MathiasKoch/roberto_mechanical/README.md

# Roberto the robot! Mechanical repository containing PCBs and mechanical drawing files.

Please see the roberto_robot repository for the actual robot software, issue tracker and wiki

https://github.com/smilykoch/roberto_robot
