MathiasKoch/roberto_mechanical/Solidworks/Assemblies/pcb_buttons.SLDASM

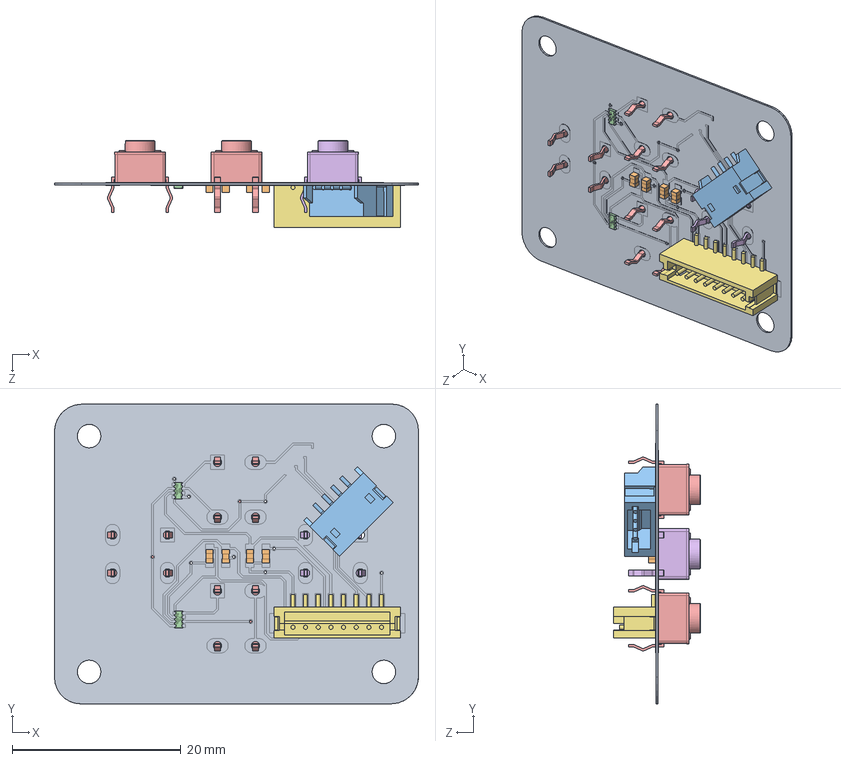
[picture p1: CAD file, 2017-02-08]
Solidworks/Assemblies/pcb_buttons.SLDASM
43.1 x 35.5 x 10.3 mm
Dip_buttons
Capacitor 0603_buttons x 4
S4B-ZR-SM4A-TF_buttons
4xRes_0402_buttons x 2
Tactile switch 6x6x5mm_buttons x 3
Tactile switch 6x6x5mm_buttons_CUT
B8B-PH-SM4_buttons
