MathiasKoch/roberto_mechanical/Solidworks/Assemblies/screen.SLDASM

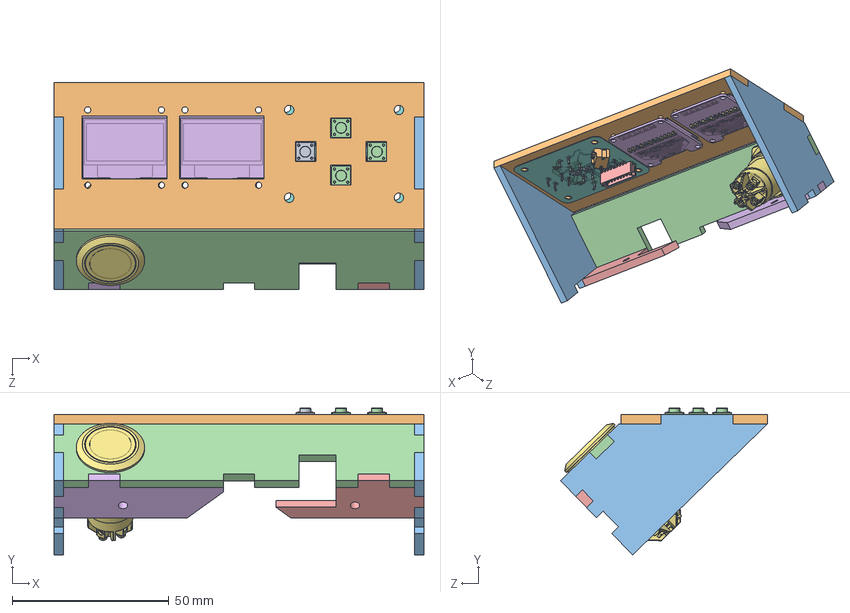
[picture p2: CAD file, 2017-02-08]
Solidworks/Assemblies/screen.SLDASM
118.0 x 46.9 x 66.1 mm
screen_face
screen_side x 2
screen_front
screen_bottom_right
screen_bottom_left
power_switch
Dip_buttons
Capacitor 0603_buttons x 4
S4B-ZR-SM4A-TF_buttons
4xRes_0402_buttons x 2
Tactile switch 6x6x5mm_buttons x 3
Tactile switch 6x6x5mm_buttons_CUT
B8B-PH-SM4_buttons
oled_display x 2
Capacitor 0603_motor x 16
Resistor 0603_motor x 8
