MathiasKoch/roberto_mechanical/Solidworks/Discarded/Electronics/xt60/XT-60_Macho.SLDASM

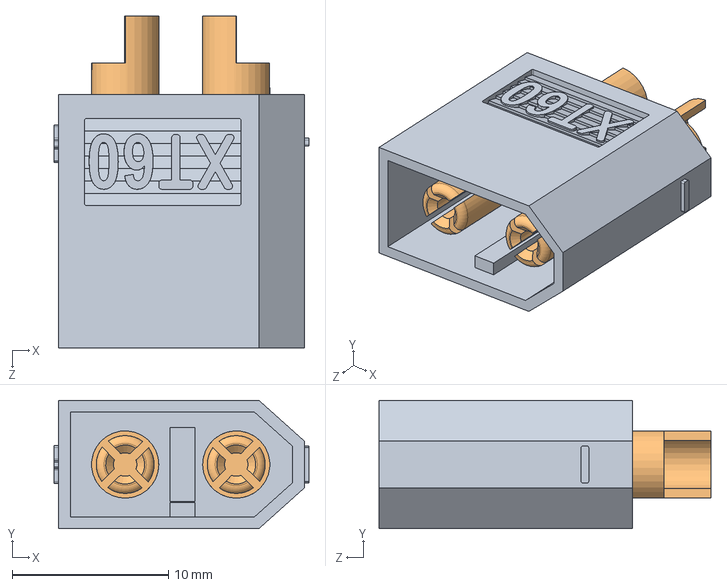
[picture p3: CAD file, 2016-10-30]
Solidworks/Discarded/Electronics/xt60/XT-60_Macho.SLDASM
16.3 x 8.20 x 21.2 mm
XT-60_Macho
PinoXT-60_Macho x 2
