MathiasKoch/roberto_mechanical/Solidworks/Assemblies/display.SLDASM

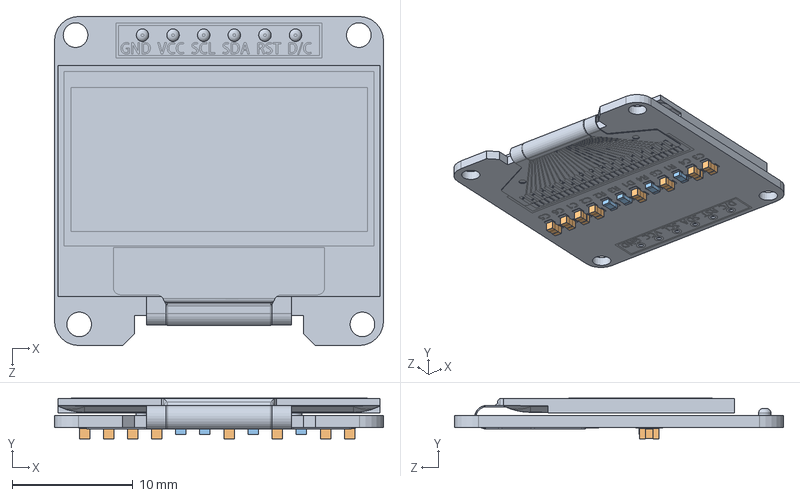
[picture p4: CAD file, 2017-02-08]
Solidworks/Assemblies/display.SLDASM
27.3 x 3.37 x 27.3 mm
oled_display
Capacitor 0603_motor x 8
Resistor 0603_motor x 4
