MathiasKoch/roberto_mechanical/Solidworks/Assemblies/pcb_motor.SLDASM

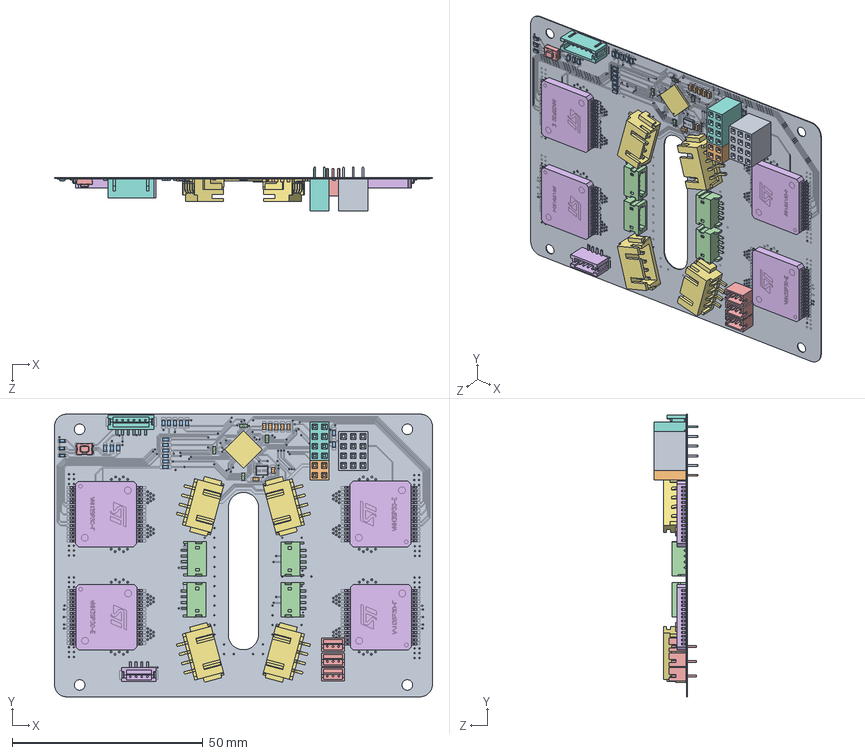
[picture p5: CAD file, 2017-02-08]
Solidworks/Assemblies/pcb_motor.SLDASM
99.1 x 74.1 x 11.7 mm
Dip_motor_motor
Capacitor 0603_motor x 7
led_0603_blue_motor x 3
S4B-ZR-SM4A-TF_motor x 4
B3B-ZR(LF)(SN)_motor x 3
B4B-PH-SM4(LF)(SN)_motor
S4B-XH-SM4-TB_motor x 4
2x4 female header 2_54mm pitch_motor
3x4 female header 2_54mm pitch_motor
2x2 female header 2_54mm pitch_motor
Resistor 0603_motor x 16
4xRes_0402_motor x 4
Switch-CK-KMR2_motor
PowSO30-ST_motor x 4
UFQFPN48_motor
B6B-ZR-SM4-TF_motor
GeyerElectronics_KX7_motor
