MathiasKoch/roberto_mechanical/Solidworks/CircuitWorks/Charger/Dip.SLDASM

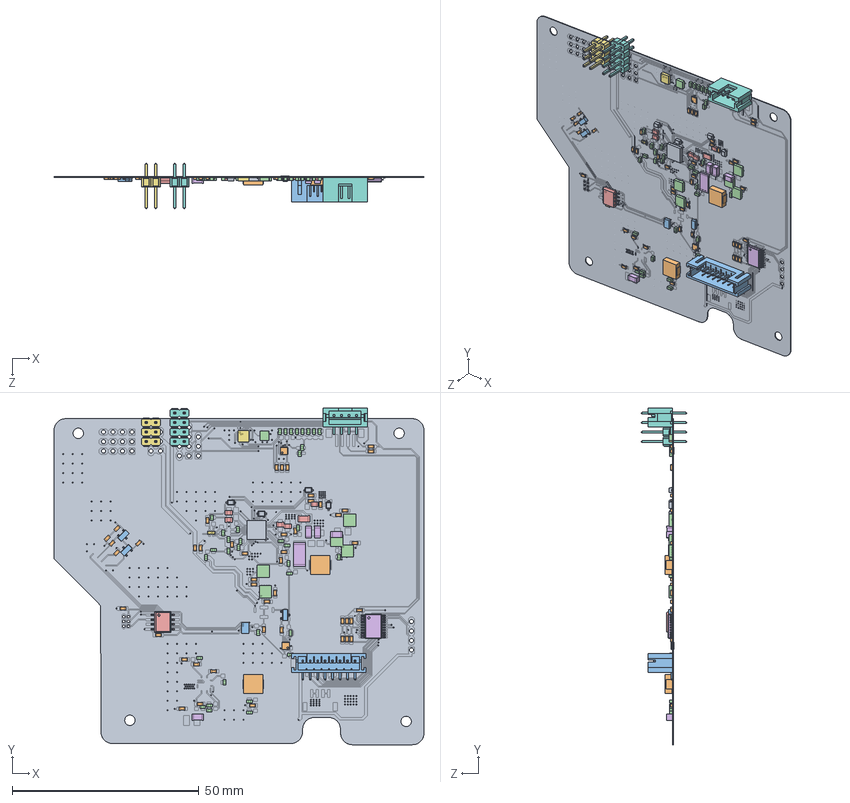
[picture p6: CAD file, 2016-11-09]
Solidworks/CircuitWorks/Charger/Dip.SLDASM
99.1 x 90.1 x 12.2 mm
Dip
Resistor 0603 x 46
B8B-PH-SM4
Capacitor 0603 x 35
Capacitor 0805 x 5
Capacitor 1206 x 4
Header 2_54 Vertical 2x3
Header 2_54 Vertical 2x4
SOD323F-1 x 4
IHLP-2020BZ-01 x 2
SOT 23 x 3
TDFN-8-EP_3x3mm x 5
Resistor 1206
Resistor 2512
4xRes_0402
B4B-PH-SM4(LF)(SN)
VQFN-32
SON8-2x2mm x 2
DFN8_3_0x2_0mm_0_50
HCLGA-10L_LPS25H
SO_IC8
TSSOP-20
QFN24-3x3_MPU9250
