MathiasKoch/roberto_mechanical/Solidworks/Assemblies/pcb_encoder.SLDASM

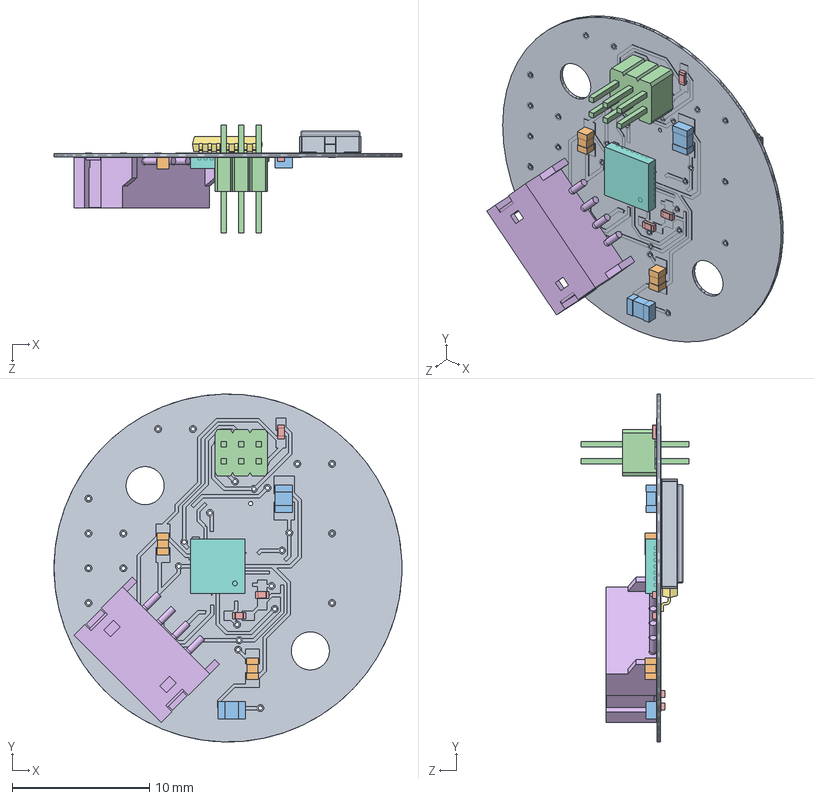
[picture p7: CAD file, 2017-02-08]
Solidworks/Assemblies/pcb_encoder.SLDASM
25.4 x 25.4 x 7.85 mm
Dip_encoder
Capacitor 0603_encoder x 2
Capacitor 0805_encoder x 2
ISP_Header_encoder
res0402-1_encoder x 5
S4B-ZR-SM4A-TF_encoder
tssop14-2_encoder
ATmega 168_encoder
GeyerElectronics_KX14_encoder
