MathiasKoch/roberto_mechanical/Solidworks/Assemblies/camera_mount.SLDASM

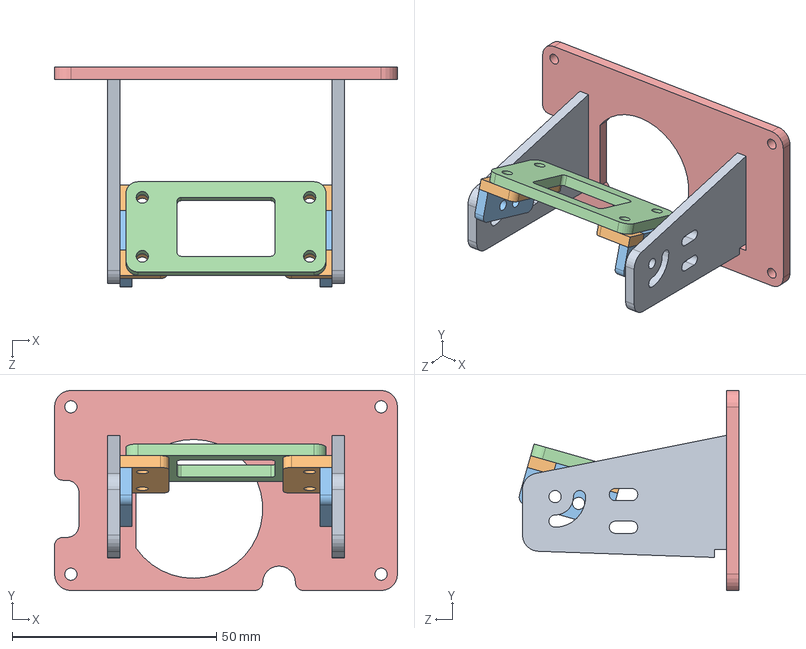
[picture p8: CAD file, 2017-02-08]
Solidworks/Assemblies/camera_mount.SLDASM
84.0 x 49.0 x 53.8 mm
camera_mount_side x 2
camera_vinkel_1 x 2
camera_vinkel_2 x 2
camera_plate
camera_mount_v2
