MathiasKoch/roberto_mechanical/Solidworks/Assemblies/tire.SLDASM

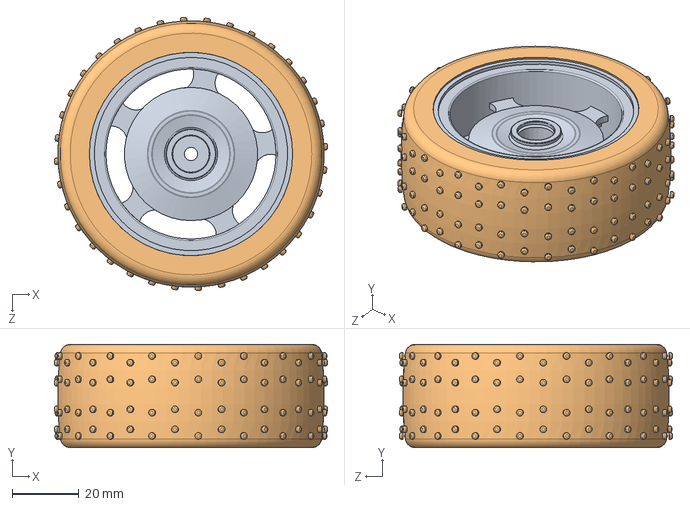
[picture p9: CAD file, 2017-02-08]
Solidworks/Assemblies/tire.SLDASM
81.9 x 31.0 x 81.9 mm
tire_rim
tire_rubber
