MathiasKoch/roberto_mechanical/Solidworks/Assemblies/bearing.SLDASM

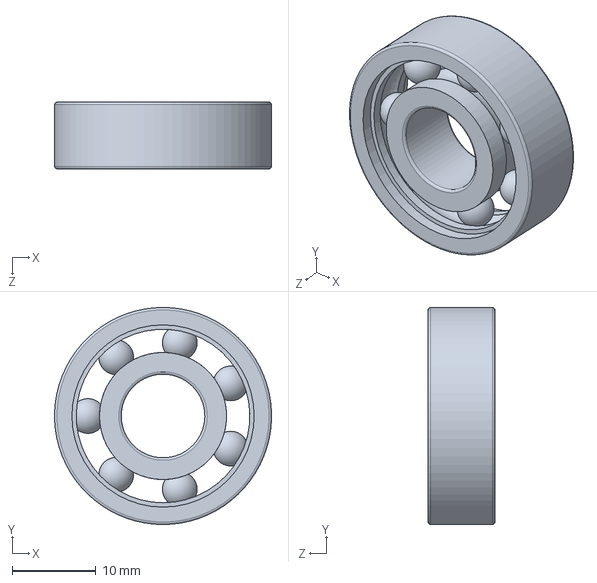
[picture p10: CAD file, 2017-02-08]
Solidworks/Assemblies/bearing.SLDASM
26.0 x 26.0 x 8.00 mm
