MathiasKoch/roberto_mechanical/Solidworks/Assemblies/pcb_distribution.SLDASM

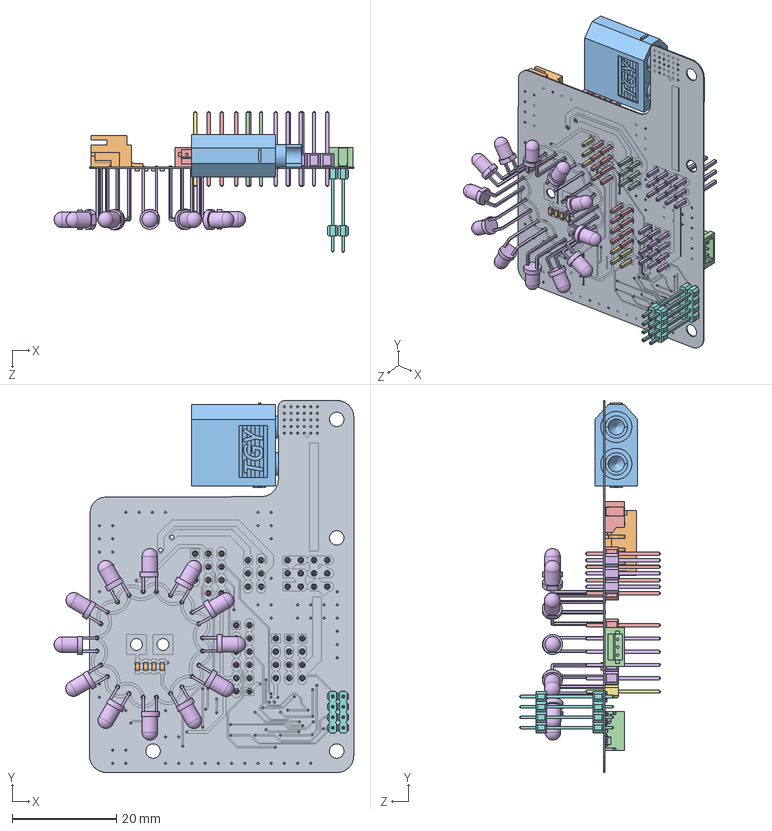
[picture p11: CAD file, 2017-02-08]
Solidworks/Assemblies/pcb_distribution.SLDASM
57.6 x 71.5 x 27.2 mm
Dip_distribution
S4B-XH-SM4-TB_distribution
XT-60_distribution
2x3_male_2.54x254_distribution
2x4_male_2.54x254_distribution x 2
3x4_male_2.54x254_distribution x 2
1x3_male_2.54x254_distribution
2x4_male_2.0x2.0_distribution
SOT 23_distribution x 6
Resistor 0603_distribution x 6
4xRes_0402_distribution x 3
S3B-ZR-SM4A-TF_distribution x 2
S4B-ZR-SM4A-TF_distribution
LED DIP 3MM_distribution x 12
2x2_male_2.54x254_distribution
