MathiasKoch/roberto_mechanical/Solidworks/Assemblies/pcb_charger.SLDASM

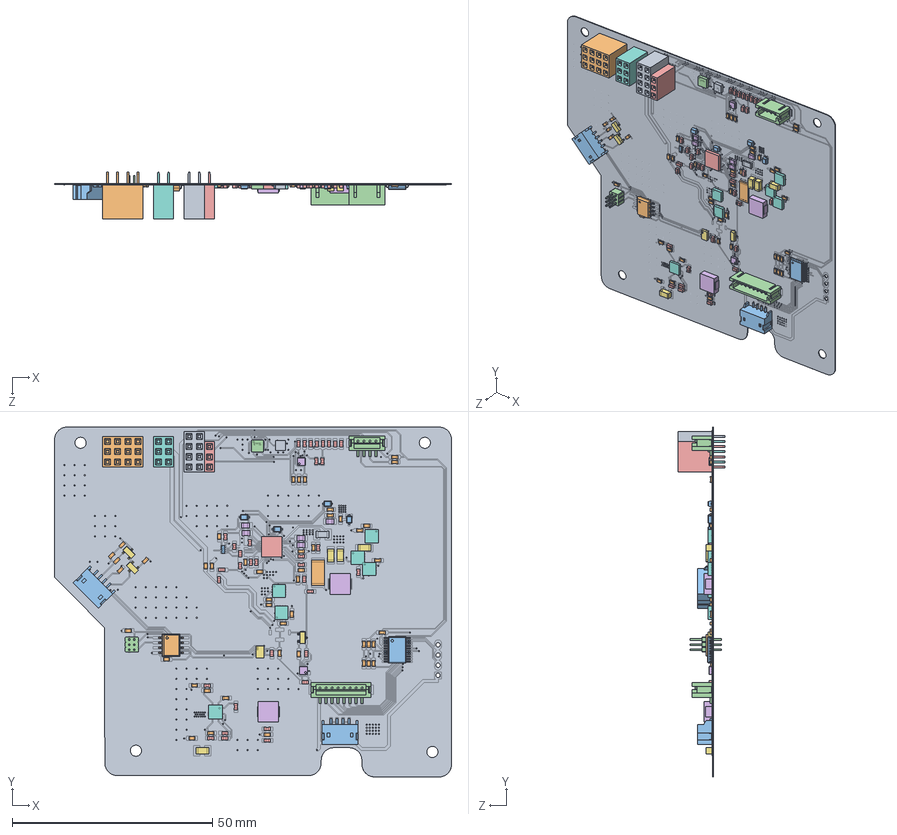
[picture p12: CAD file, 2017-02-08]
Solidworks/Assemblies/pcb_charger.SLDASM
99.1 x 87.3 x 11.7 mm
Dip_charger_charger
Resistor 0603_charger x 46
S4B-ZR-SM4A-TF_charger x 2
B8B-PH-SM4_charger
Capacitor 0603_charger x 35
Capacitor 0805_charger x 5
Capacitor 1206_charger x 4
2x3 female header 2_54mm pitch_charger
2x4 female header 2_54mm pitch_charger
3x4 female header 2_54mm pitch_charger
SOD323F-1_charger x 4
ISP_Header_charger
1x3 female header 2_54mm pitch_charger
IHLP-2020BZ-01_charger x 2
SOT 23_charger x 3
TDFN-8-EP_3x3mm_charger x 5
Resistor 1206_charger
Resistor 2512_charger
4xRes_0402_charger
B4B-PH-SM4(LF)(SN)_charger
VQFN-32_charger
SON8-2x2mm_charger x 2
DFN8_3_0x2_0mm_0_50_charger
TPS54320_charger
HCLGA-10L_LPS25H_charger
SO_IC8_charger
TSSOP-20_charger
QFN24-3x3_MPU9250_charger
