MathiasKoch/roberto_mechanical/DipTrace/3D/CHARGER/MPU9250.step

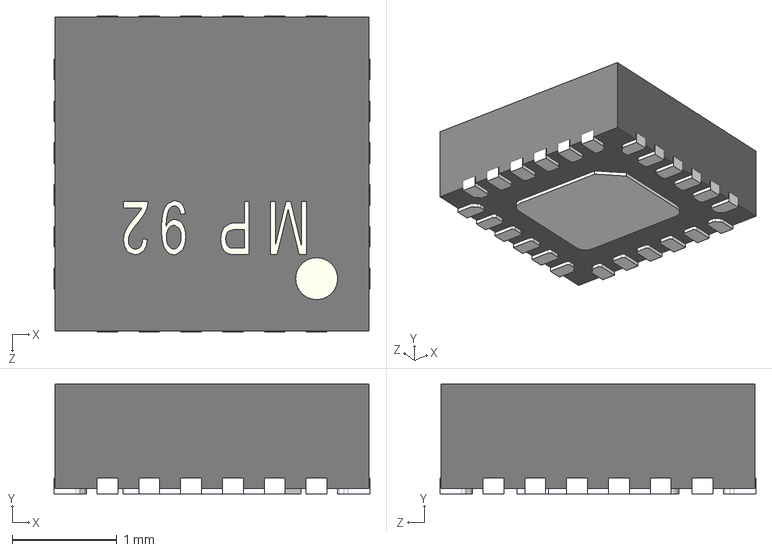
[picture p13: CAD file, 2017-08-20]
DipTrace/3D/CHARGER/MPU9250.step
3.02 x 1.05 x 3.02 mm
