MathiasKoch/roberto_mechanical/DipTrace/3D/DISTRIBUTION/S4B-XH-SM4-TB_motor.STEP

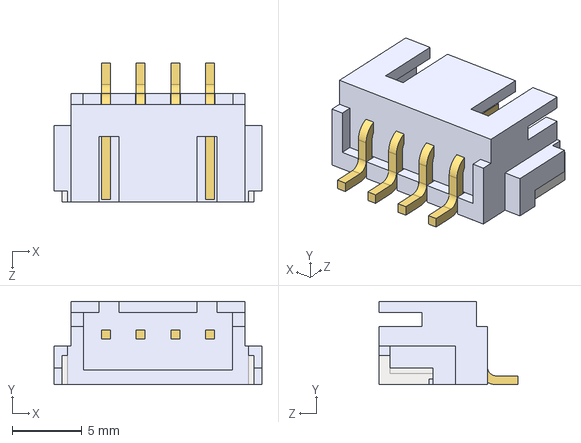
[picture p14: CAD file, 2017-08-20]
DipTrace/3D/DISTRIBUTION/S4B-XH-SM4-TB_motor.STEP
14.9 x 6.00 x 10.0 mm
