MathiasKoch/roberto_mechanical/DipTrace/3D/MOTOR/GeyerElectronics_KX7.step

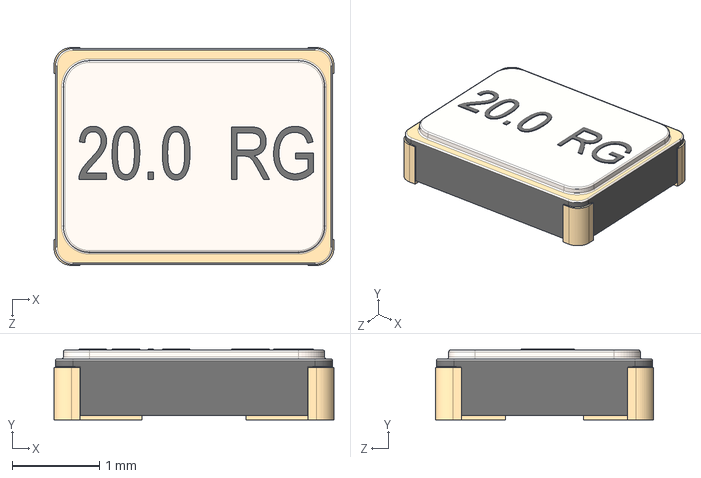
[picture p15: CAD file, 2017-08-20]
DipTrace/3D/MOTOR/GeyerElectronics_KX7.step
3.21 x 0.81 x 2.50 mm
