MathiasKoch/roberto_mechanical/DipTrace/Mechanical mounting/base_bottom_up.DXF

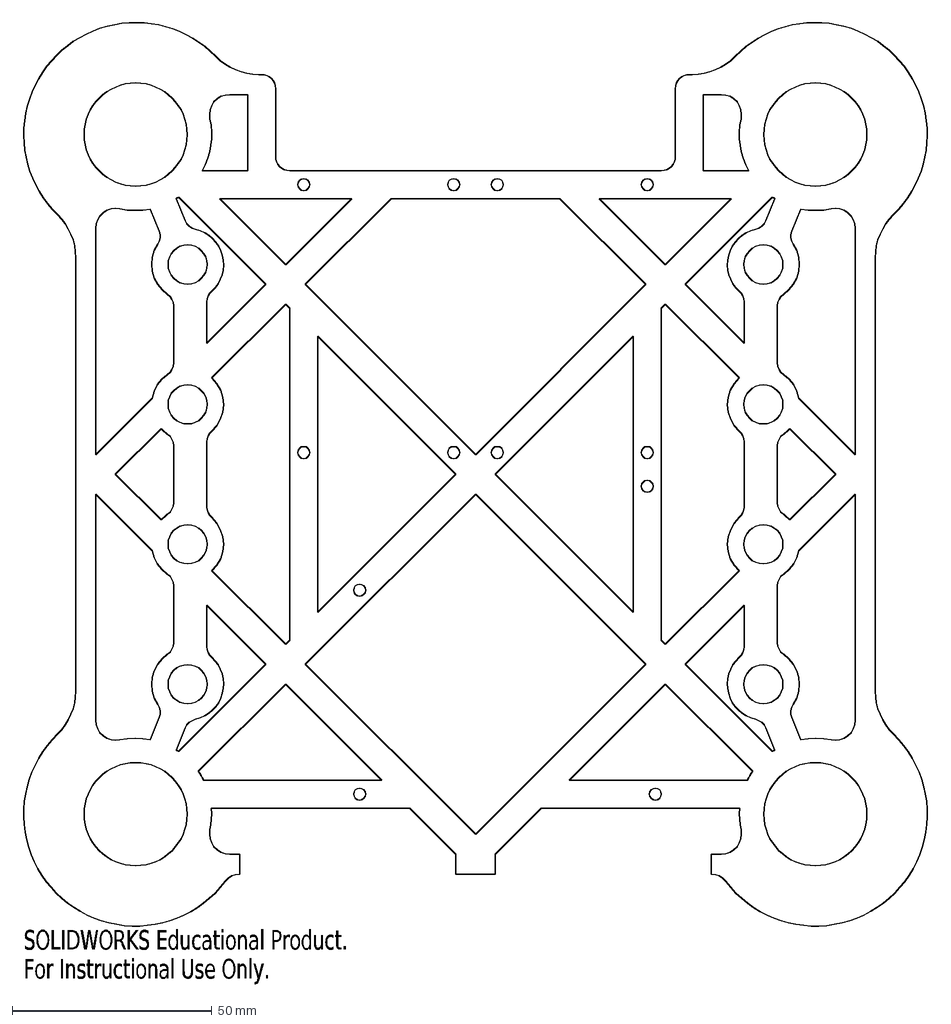
[picture p16: CAD file, 2017-08-20]
DipTrace/Mechanical mounting/base_bottom_up.DXF
SOLIDWORKS Educational Product.
For Instructional Use Only.
