MathiasKoch/roberto_mechanical/Solidworks/CircuitWorks/BUILT-BY-CIRCUITWORKS/components/Electrolitic Capacitor Radial 5x11.SLDPRT

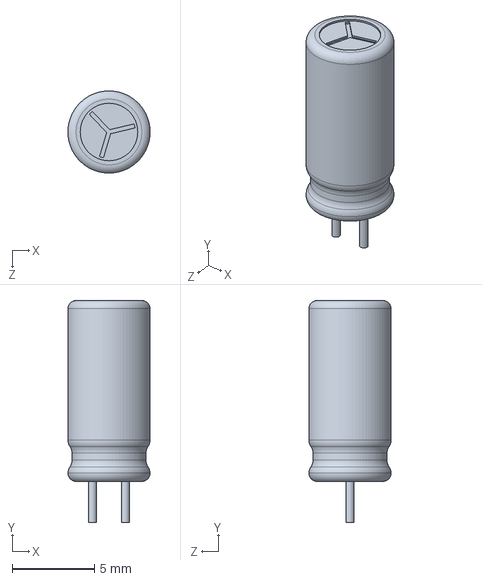
[picture p17: CAD file, 2016-11-10]
Solidworks/CircuitWorks/BUILT-BY-CIRCUITWORKS/components/Electrolitic Capacitor Radial 5x11.SLDPRT
5.00 x 13.5 x 5.00 mm
