MathiasKoch/roberto_mechanical/Solidworks/CircuitWorks/Buttons/Tactile switch 6x6x5mm.SLDPRT

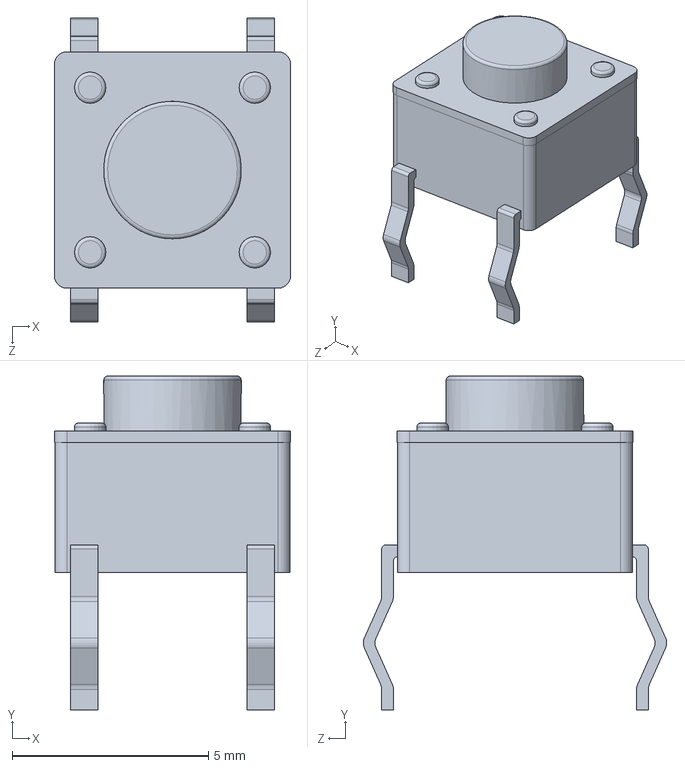
[picture p18: CAD file, 2016-11-10]
Solidworks/CircuitWorks/Buttons/Tactile switch 6x6x5mm.SLDPRT
6.03 x 8.52 x 7.74 mm
