MathiasKoch/roberto_mechanical/Solidworks/CircuitWorks/Distribution/S3B-ZR-SM4A-TF.SLDPRT

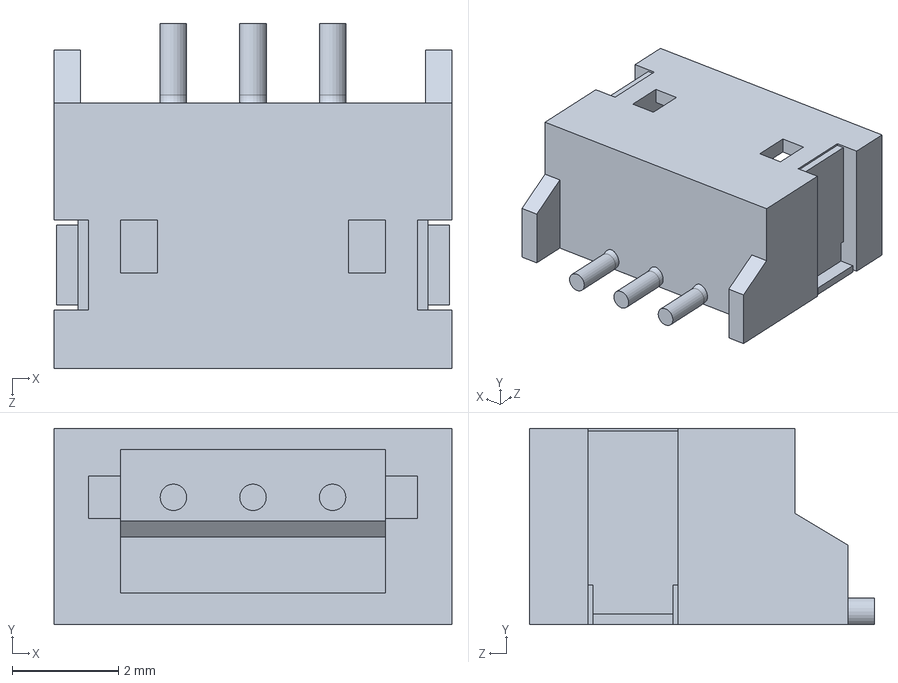
[picture p19: CAD file, 2016-11-10]
Solidworks/CircuitWorks/Distribution/S3B-ZR-SM4A-TF.SLDPRT
7.50 x 3.70 x 6.50 mm
