MathiasKoch/roberto_mechanical/Solidworks/CircuitWorks/Encoder/res0402-1.SLDPRT

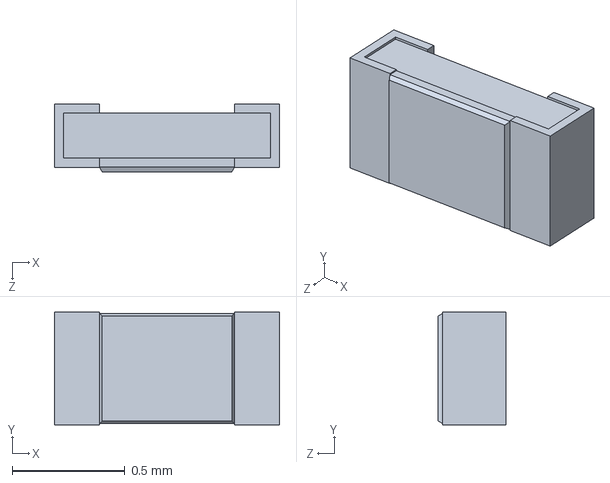
[picture p20: CAD file, 2016-11-10]
Solidworks/CircuitWorks/Encoder/res0402-1.SLDPRT
1.00 x 0.5 x 0.3 mm
