MathiasKoch/roberto_mechanical/Solidworks/Discarded/Electronics/xt60/PinoXT-60_Macho.SLDPRT

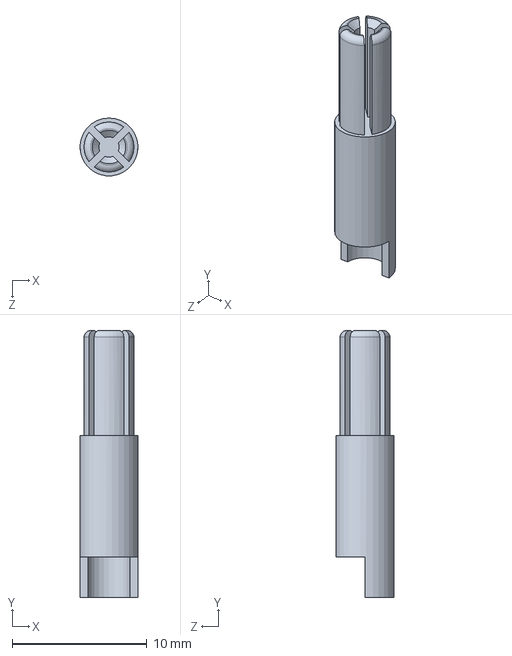
[picture p21: CAD file, 2016-10-30]
Solidworks/Discarded/Electronics/xt60/PinoXT-60_Macho.SLDPRT
4.30 x 19.8 x 4.30 mm
