MathiasKoch/roberto_mechanical/Solidworks/Discarded/gear_motor.SLDPRT

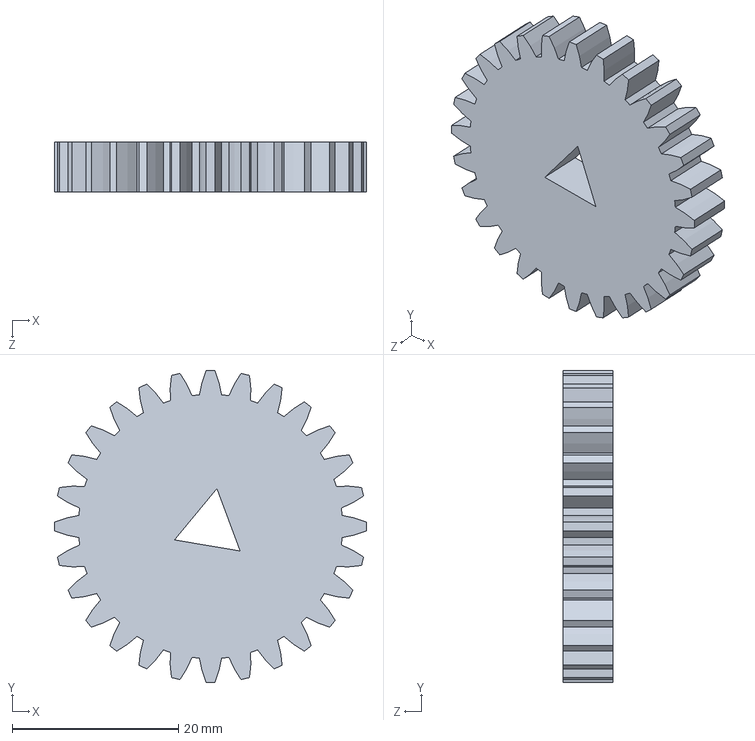
[picture p22: CAD file, 2016-10-30]
Solidworks/Discarded/gear_motor.SLDPRT
37.5 x 37.5 x 6.00 mm
