MathiasKoch/roberto_mechanical/Solidworks/Drawings/dxf/top_base.DXF

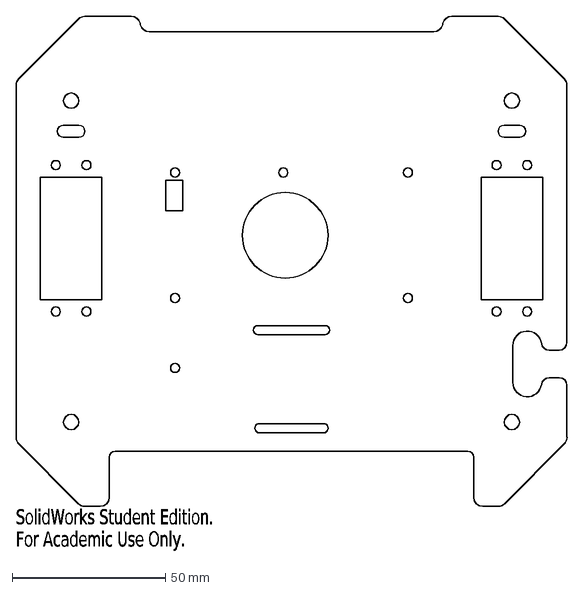
[picture p23: CAD file, 2017-02-08]
Solidworks/Drawings/dxf/top_base.DXF
SolidWorks Student Edition.
For Academic Use Only.
