MathiasKoch/roberto_mechanical/Solidworks/Parts/Charger/4xRes_0402_charger.SLDPRT

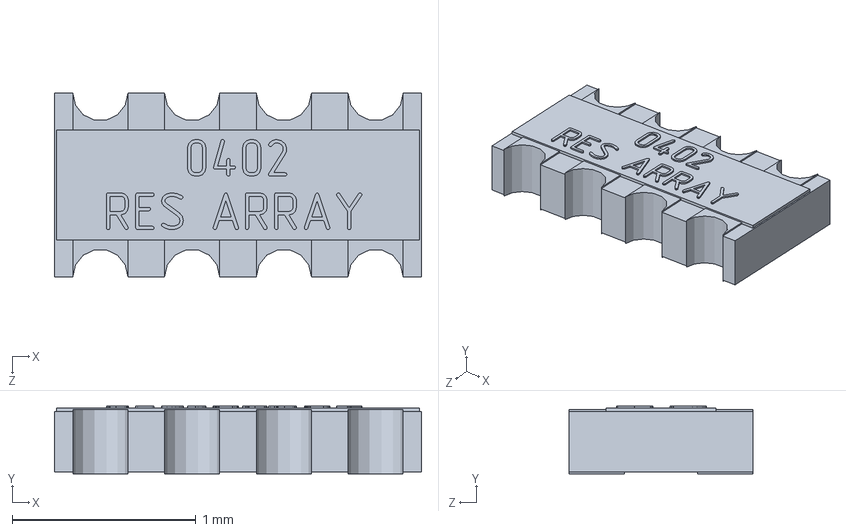
[picture p24: CAD file, 2016-11-09]
Solidworks/Parts/Charger/4xRes_0402_charger.SLDPRT
2.00 x 0.37 x 1.00 mm
