MathiasKoch/roberto_mechanical/Solidworks/Parts/Connectors/XT60 MALE.SLDPRT

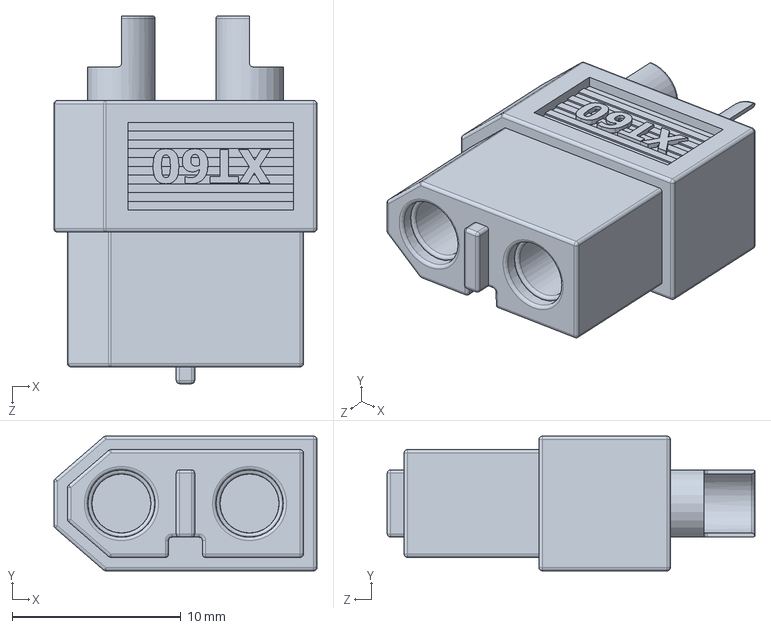
[picture p25: CAD file, 2017-02-08]
Solidworks/Parts/Connectors/XT60 MALE.SLDPRT
15.6 x 8.00 x 21.8 mm
