MathiasKoch/roberto_mechanical/Solidworks/Parts/Display/Resistor 0603_motor.SLDPRT

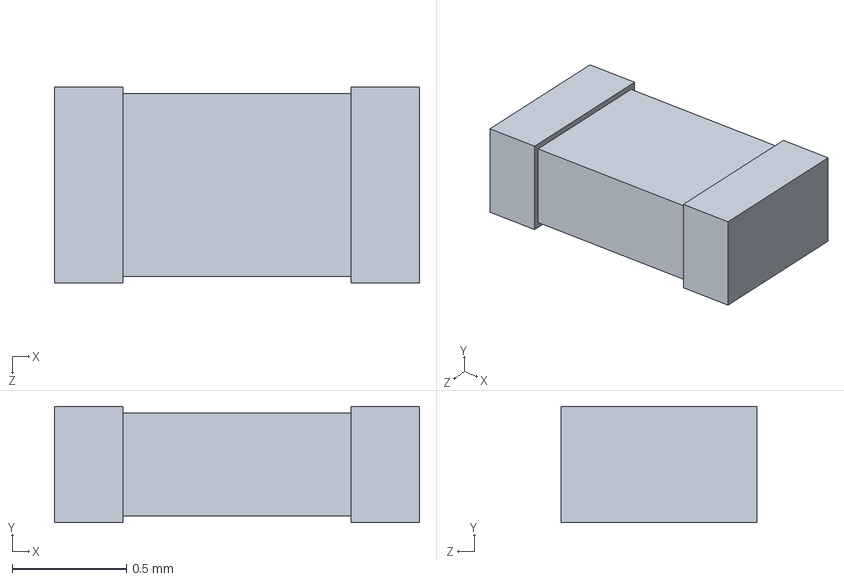
[picture p26: CAD file, 2016-11-09]
Solidworks/Parts/Display/Resistor 0603_motor.SLDPRT
1.60 x 0.51 x 0.86 mm
