MathiasKoch/roberto_mechanical/Solidworks/Parts/Motor/S4B-ZR-SM4A-TF_motor.SLDPRT

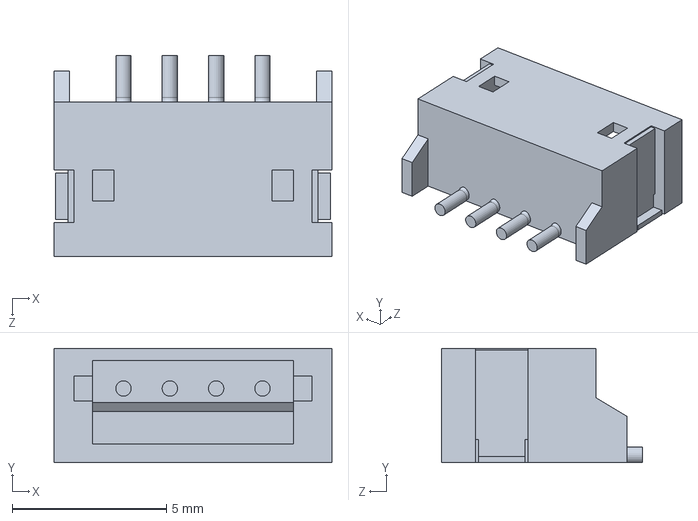
[picture p27: CAD file, 2016-11-09]
Solidworks/Parts/Motor/S4B-ZR-SM4A-TF_motor.SLDPRT
9.00 x 3.70 x 6.50 mm
