MathiasKoch/roberto_mechanical/Solidworks/Parts/screen_face.SLDPRT

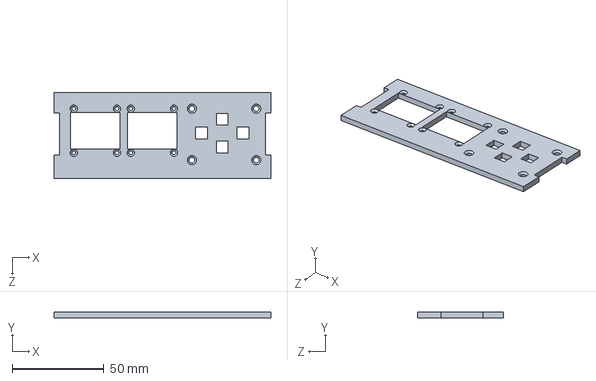
[picture p28: CAD file, 2017-02-08]
Solidworks/Parts/screen_face.SLDPRT
118.0 x 3.00 x 46.7 mm
