MathiasKoch/roberto_mechanical/DipTrace/3D/CHARGER/hdrf-1x3t_2.54_8x3.step

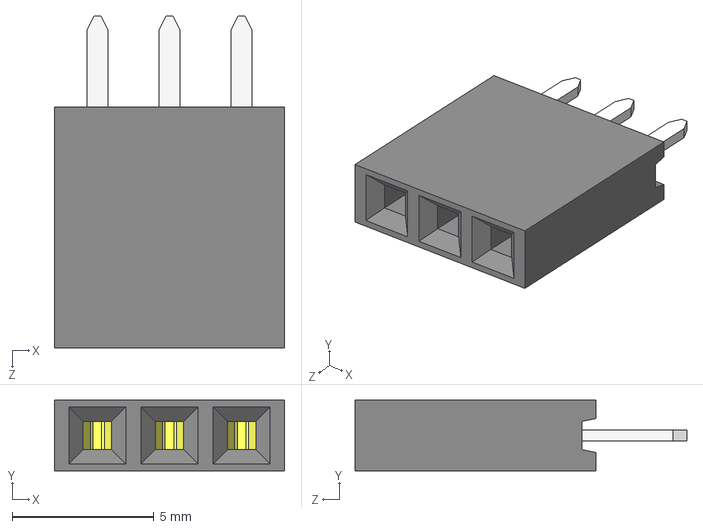
[picture p29: CAD file, 2017-08-20]
DipTrace/3D/CHARGER/hdrf-1x3t_2.54_8x3.step
8.12 x 2.50 x 11.7 mm
