MathiasKoch/roberto_mechanical/DipTrace/3D/MOTOR/PowSO30-ST.STEP

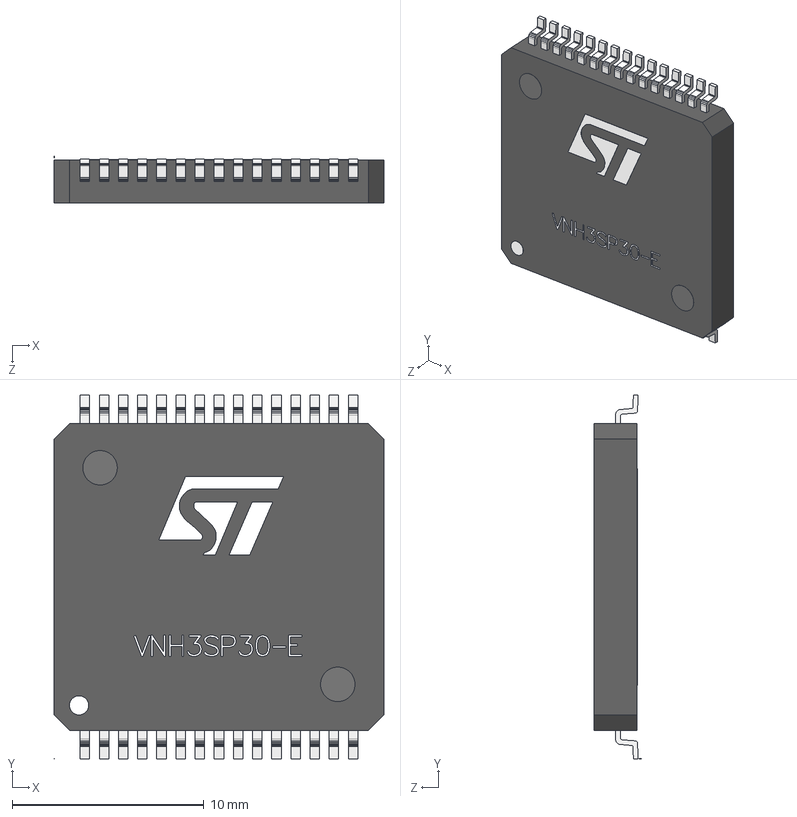
[picture p30: CAD file, 2017-08-20]
DipTrace/3D/MOTOR/PowSO30-ST.STEP
17.2 x 19.0 x 2.47 mm
SW3dPS-PowSO30-ST_Extruded18 x 30
SW3dPS-PowSO30-ST_Board3 x 30
SW3dPS-PowSO30-ST_Extruded22 x 2
SW3dPS-PowSO30-ST_Extruded32
SW3dPS-PowSO30-ST_Extruded31
SW3dPS-PowSO30-ST_Extruded29
SW3dPS-PowSO30-ST_Extruded30
SW3dPS-PowSO30-ST_Extruded20
SW3dPS-PowSO30-ST_Extruded28
SW3dPS-PowSO30-ST_Extruded26
SW3dPS-PowSO30-ST_Cylinder2 x 2
SW3dPS-PowSO30-ST_Extruded33
SW3dPS-PowSO30-ST_Extruded21
SW3dPS-PowSO30-ST_Extruded24
SW3dPS-PowSO30-ST_Extruded19
SW3dPS-PowSO30-ST_Extruded25
SW3dPS-PowSO30-ST_Extruded23
SW3dPS-PowSO30-ST_Extruded27
SW3dPS-PowSO30-ST_Extruded17
SW3dPS-PowSO30-ST_Cylinder3
SW3dPS-PowSO30-ST_Board2
