MathiasKoch/roberto_mechanical/DipTrace/Mechanical mounting/top_base.DXF

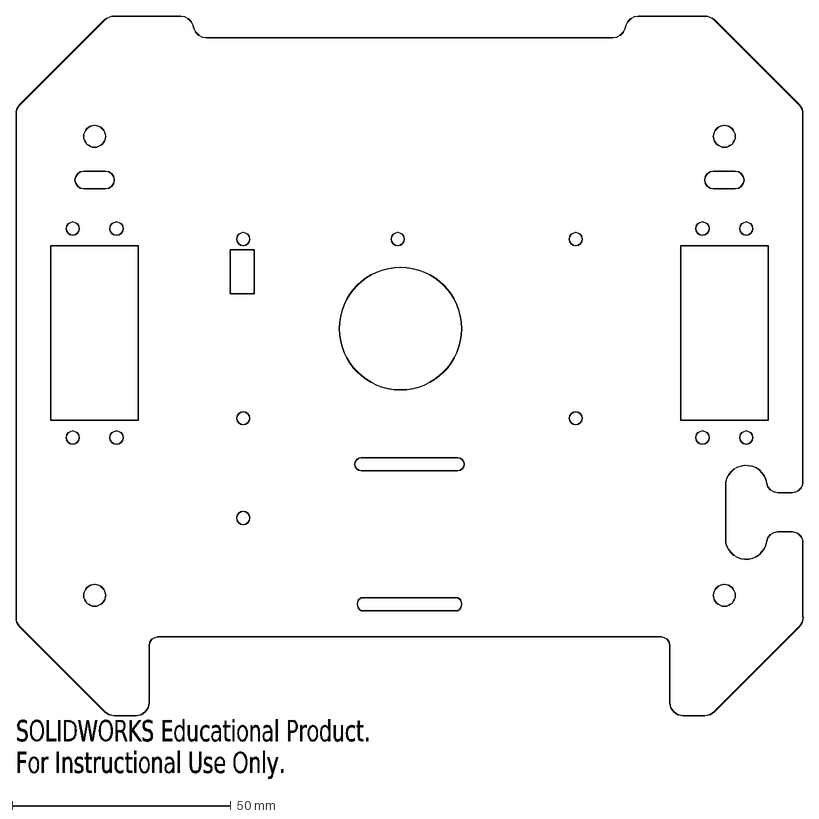
[picture p31: CAD file, 2017-08-20]
DipTrace/Mechanical mounting/top_base.DXF
SOLIDWORKS Educational Product.
For Instructional Use Only.
