MathiasKoch/roberto_mechanical/Solidworks/CircuitWorks/Encoder/GeyerElectronics_KX14.SLDPRT

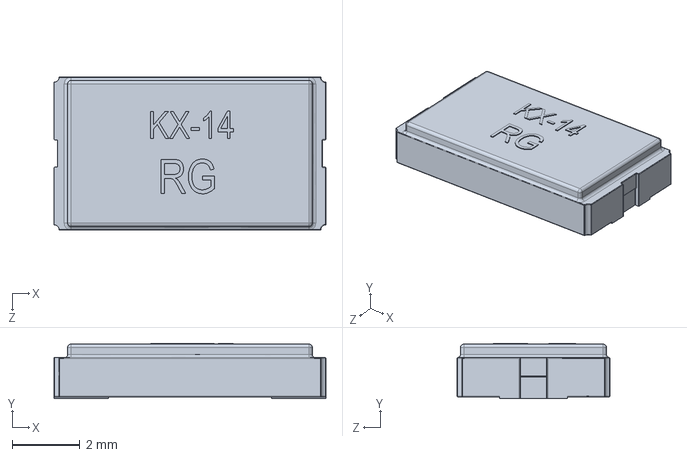
[picture p32: CAD file, 2016-11-10]
Solidworks/CircuitWorks/Encoder/GeyerElectronics_KX14.SLDPRT
8.00 x 1.62 x 4.50 mm
