MathiasKoch/roberto_mechanical/Solidworks/Discarded/WheelMount_p3.SLDPRT

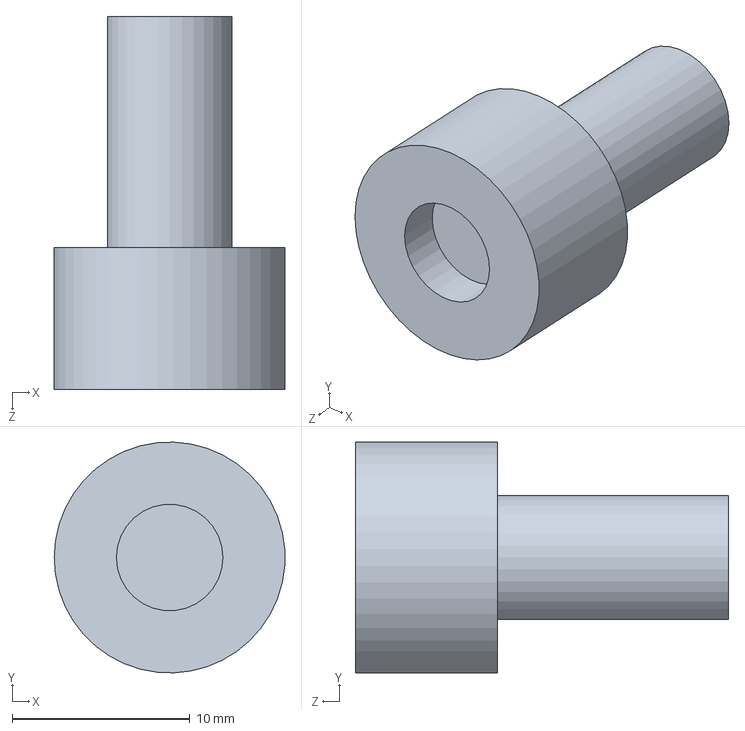
[picture p33: CAD file, 2016-10-30]
Solidworks/Discarded/WheelMount_p3.SLDPRT
13.0 x 13.0 x 21.0 mm
