MathiasKoch/roberto_mechanical/Solidworks/Parts/Charger/SOT 23_charger.SLDPRT

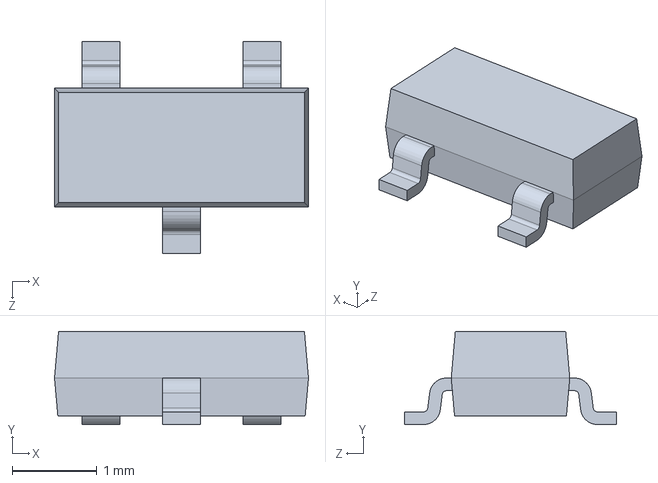
[picture p34: CAD file, 2016-11-09]
Solidworks/Parts/Charger/SOT 23_charger.SLDPRT
3.00 x 1.10 x 2.50 mm
