MathiasKoch/roberto_mechanical/Solidworks/Parts/Display/Capacitor 0603_motor.SLDPRT

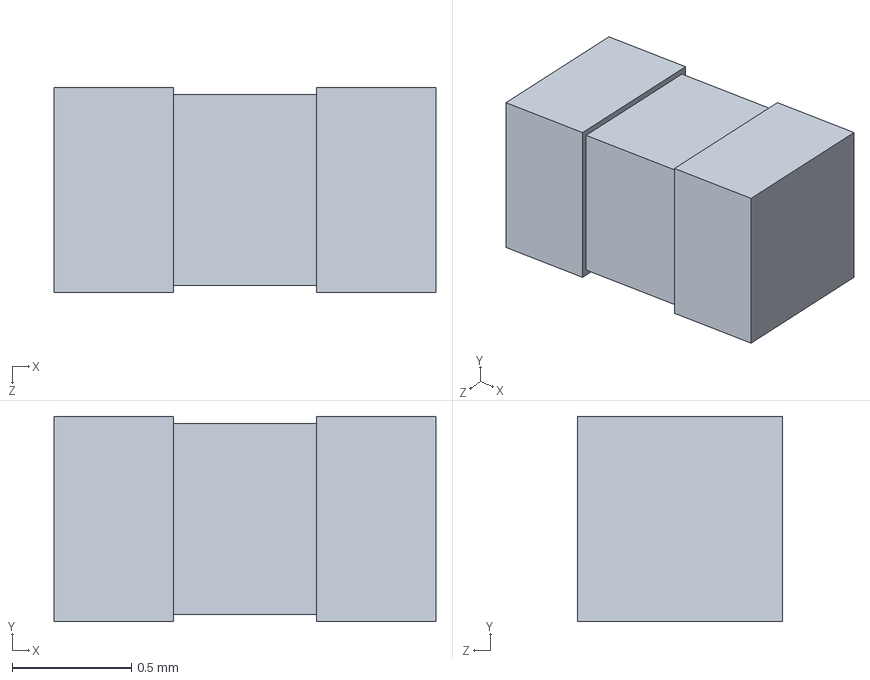
[picture p35: CAD file, 2016-11-09]
Solidworks/Parts/Display/Capacitor 0603_motor.SLDPRT
1.60 x 0.86 x 0.86 mm
