MathiasKoch/roberto_mechanical/Solidworks/Parts/power_switch.SLDPRT

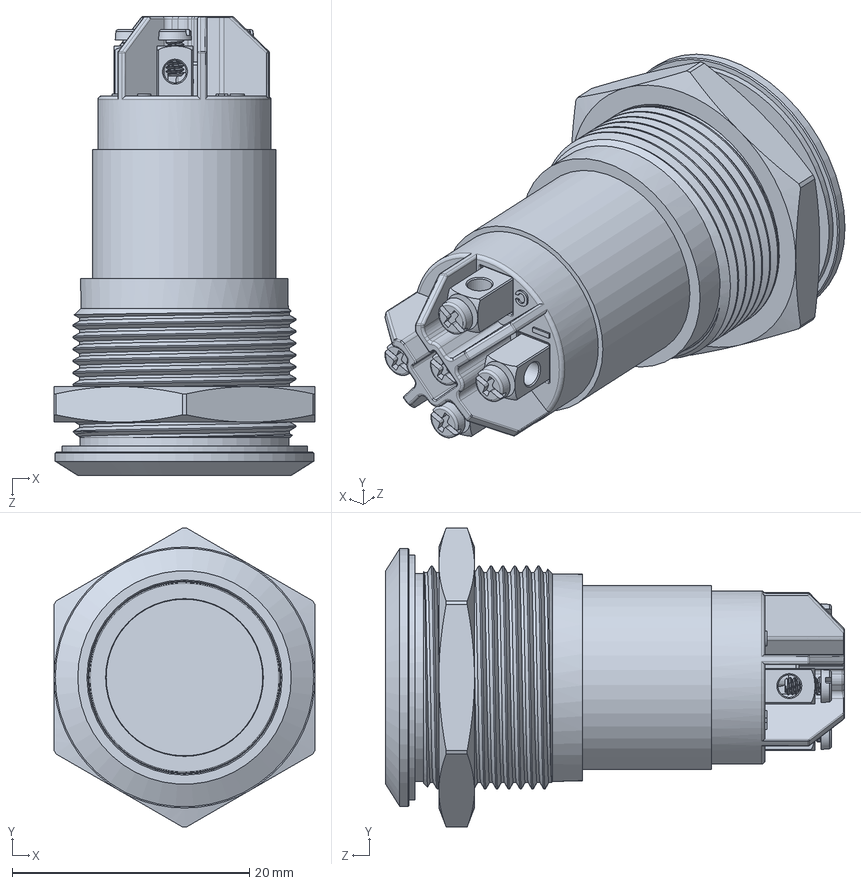
[picture p36: CAD file, 2017-02-08]
Solidworks/Parts/power_switch.SLDPRT
22.0 x 25.2 x 38.7 mm
