MathiasKoch/roberto_mechanical/Solidworks/Parts/Smart-Parts/threaded_rod.sldprt

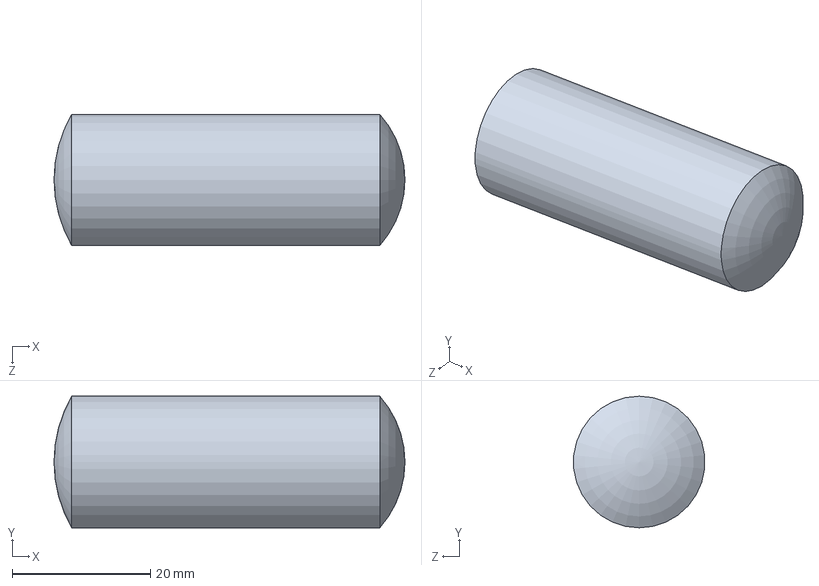
[picture p37: CAD file, 2017-02-08]
Solidworks/Parts/Smart-Parts/threaded_rod.sldprt
50.8 x 19.1 x 19.0 mm
