MathiasKoch/roberto_mechanical/DipTrace/3D/CHARGER/pqfn-32r_5x5x0.5.step

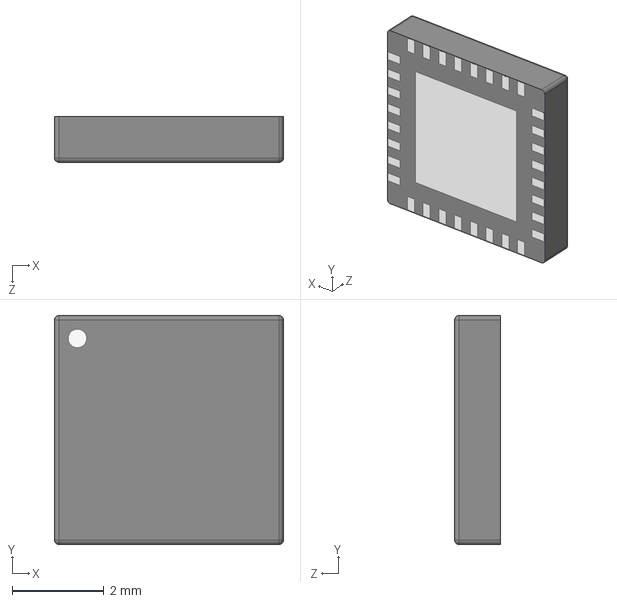
[picture p38: CAD file, 2017-08-20]
DipTrace/3D/CHARGER/pqfn-32r_5x5x0.5.step
5.00 x 5.00 x 1.00 mm
