MathiasKoch/roberto_mechanical/DipTrace/3D/DISTRIBUTION/hdr-2x5th_2.54x2.54_12x15.step

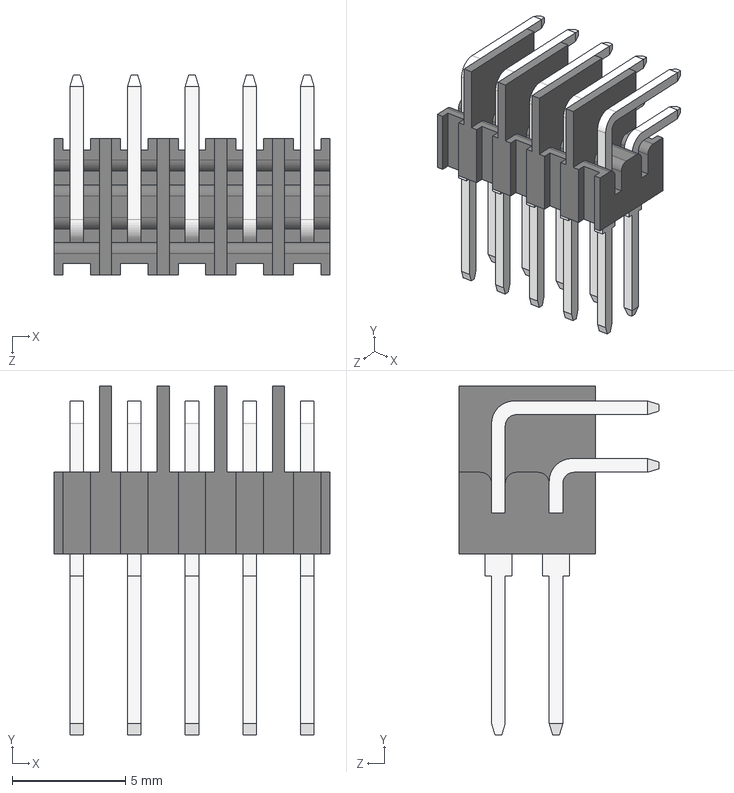
[picture p39: CAD file, 2017-08-20]
DipTrace/3D/DISTRIBUTION/hdr-2x5th_2.54x2.54_12x15.step
12.2 x 15.4 x 8.80 mm
