MathiasKoch/roberto_mechanical/DipTrace/3D/MOTOR/Switch-CK-KMR2.STEP

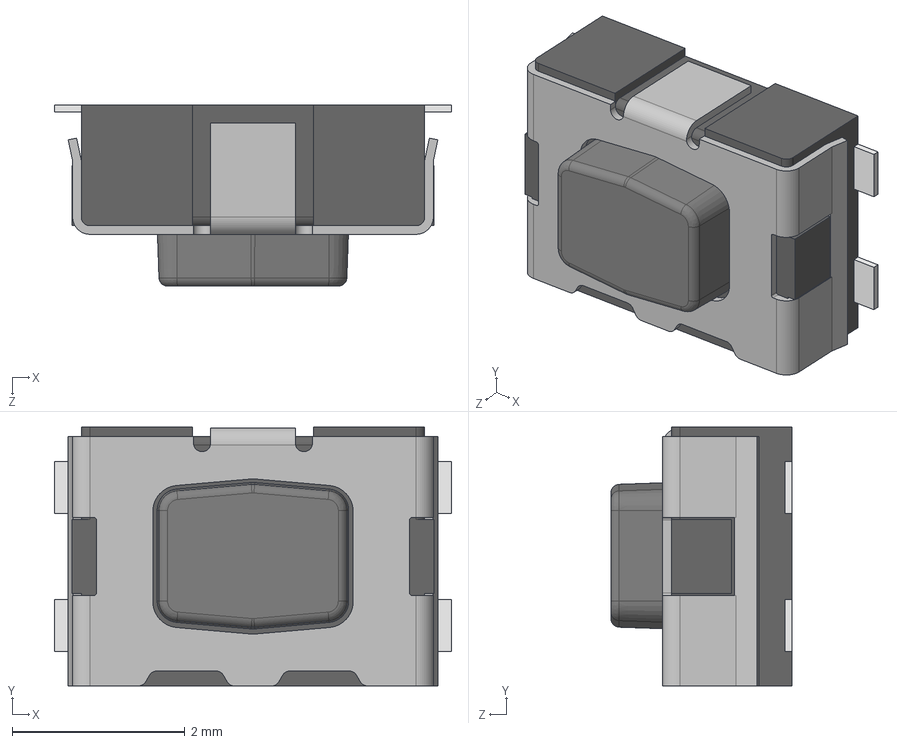
[picture p40: CAD file, 2017-08-20]
DipTrace/3D/MOTOR/Switch-CK-KMR2.STEP
4.60 x 3.00 x 2.10 mm
User Library-Switch-CK-KMR2_Button
User Library-Switch-CK-KMR2_Boitier
User Library-Switch-CK-KMR2_Tole
User Library-Switch-CK-KMR2_Pads
