MathiasKoch/roberto_mechanical/DipTrace/Mechanical mounting/base_bottom_low.DXF

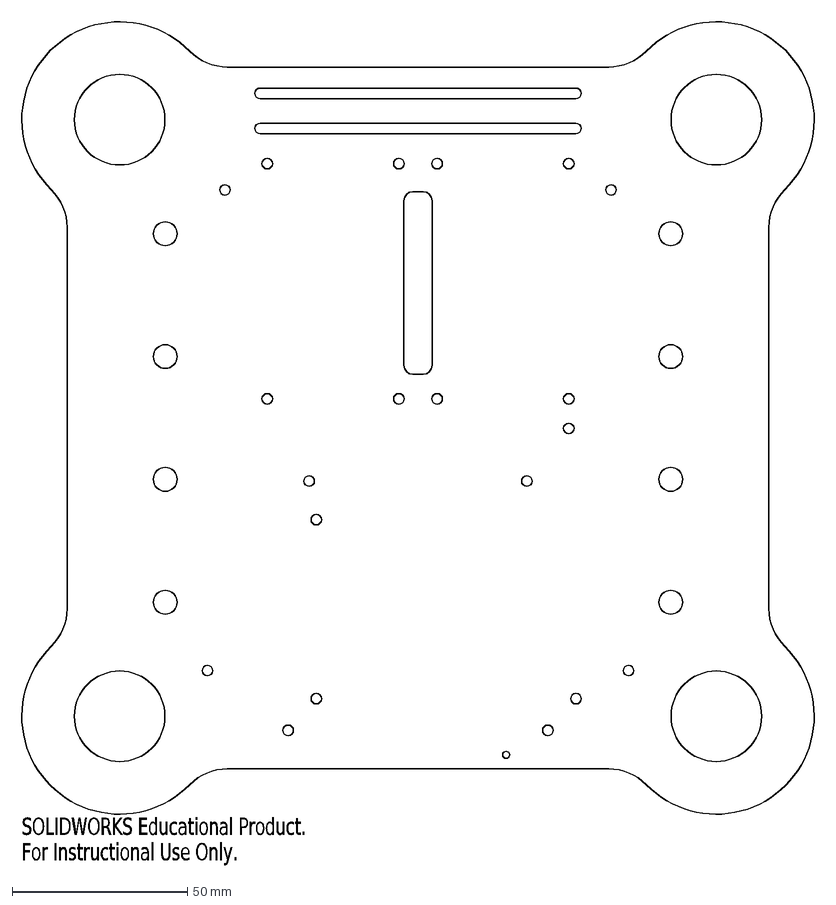
[picture p41: CAD file, 2017-08-20]
DipTrace/Mechanical mounting/base_bottom_low.DXF
SOLIDWORKS Educational Product.
For Instructional Use Only.
