MathiasKoch/roberto_mechanical/Solidworks/CircuitWorks/BUILT-BY-CIRCUITWORKS/components/SO-14 (PIC16F684).SLDPRT

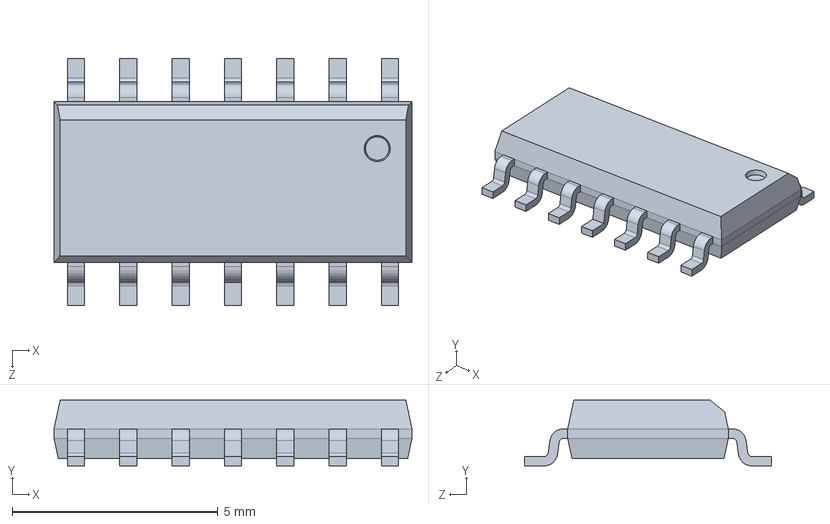
[picture p42: CAD file, 2016-11-10]
Solidworks/CircuitWorks/BUILT-BY-CIRCUITWORKS/components/SO-14 (PIC16F684).SLDPRT
8.69 x 1.60 x 5.99 mm
