MathiasKoch/roberto_mechanical/Solidworks/CircuitWorks/Encoder/ATmega 168.SLDPRT

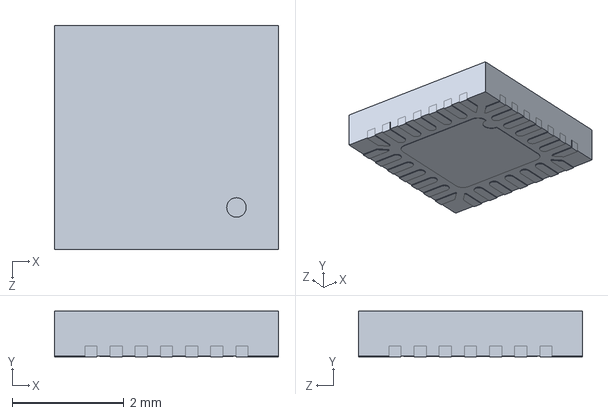
[picture p44: CAD file, 2016-11-10]
Solidworks/CircuitWorks/Encoder/ATmega 168.SLDPRT
4.00 x 0.82 x 4.00 mm
