MathiasKoch/roberto_mechanical/Solidworks/Parts/Connectors/JST_XH_4.SLDPRT

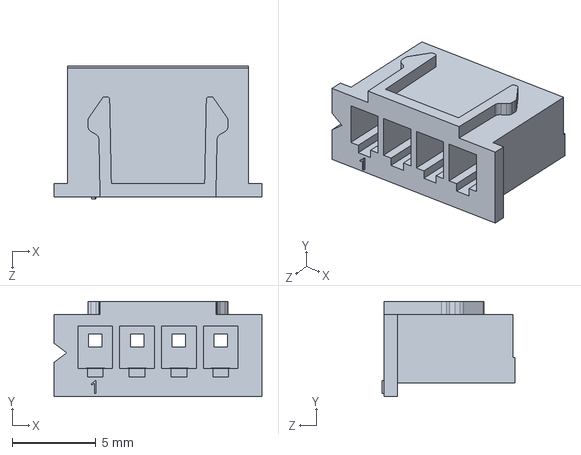
[picture p46: CAD file, 2016-11-17]
Solidworks/Parts/Connectors/JST_XH_4.SLDPRT
12.4 x 5.69 x 7.95 mm
