MathiasKoch/roberto_mechanical/Solidworks/Parts/Distribution/1x3_male_2.54x254_distribution.SLDPRT

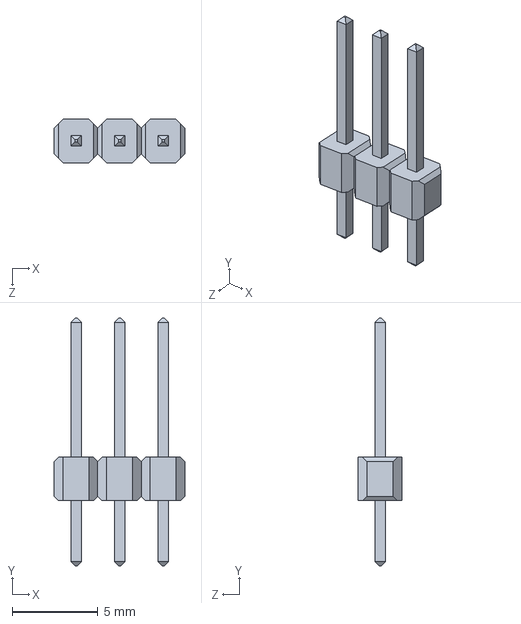
[picture p47: CAD file, 2016-11-10]
Solidworks/Parts/Distribution/1x3_male_2.54x254_distribution.SLDPRT
7.62 x 14.5 x 2.54 mm
