MathiasKoch/roberto_mechanical/Solidworks/Parts/encoder_mount.SLDPRT

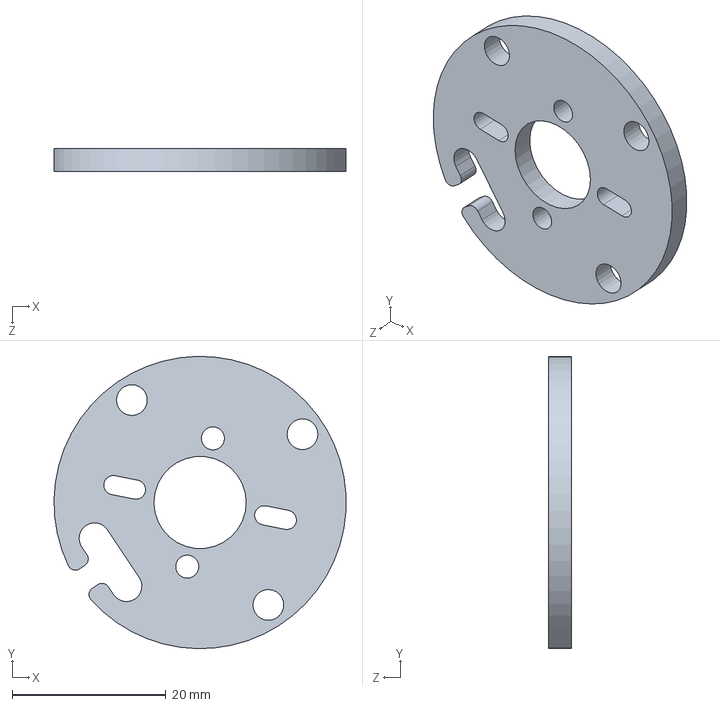
[picture p48: CAD file, 2017-02-08]
Solidworks/Parts/encoder_mount.SLDPRT
38.0 x 38.0 x 3.00 mm
