MathiasKoch/roberto_mechanical/DipTrace/3D/CHARGER/SRR1208.step

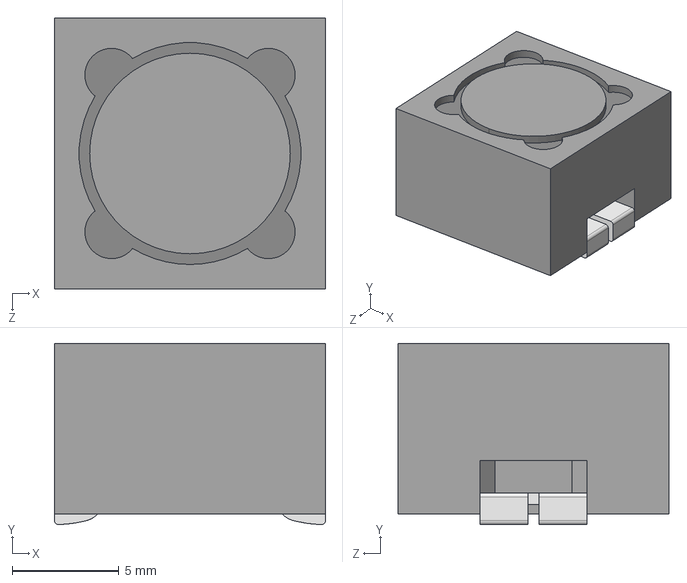
[picture p49: CAD file, 2017-08-20]
DipTrace/3D/CHARGER/SRR1208.step
12.7 x 8.49 x 12.7 mm
