MathiasKoch/roberto_mechanical/Solidworks/CircuitWorks/BUILT-BY-CIRCUITWORKS/components/CAPCXXXXN.SLDPRT

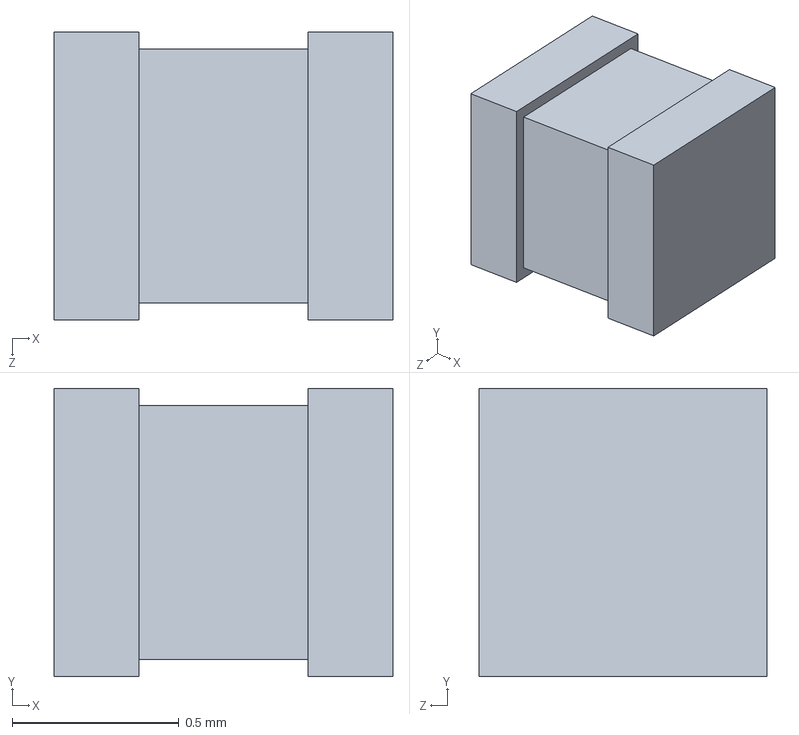
[picture p50: CAD file, 2016-11-10]
Solidworks/CircuitWorks/BUILT-BY-CIRCUITWORKS/components/CAPCXXXXN.SLDPRT
1.02 x 0.864 x 0.864 mm
