MathiasKoch/roberto_mechanical/Solidworks/Discarded/hjul.SLDPRT

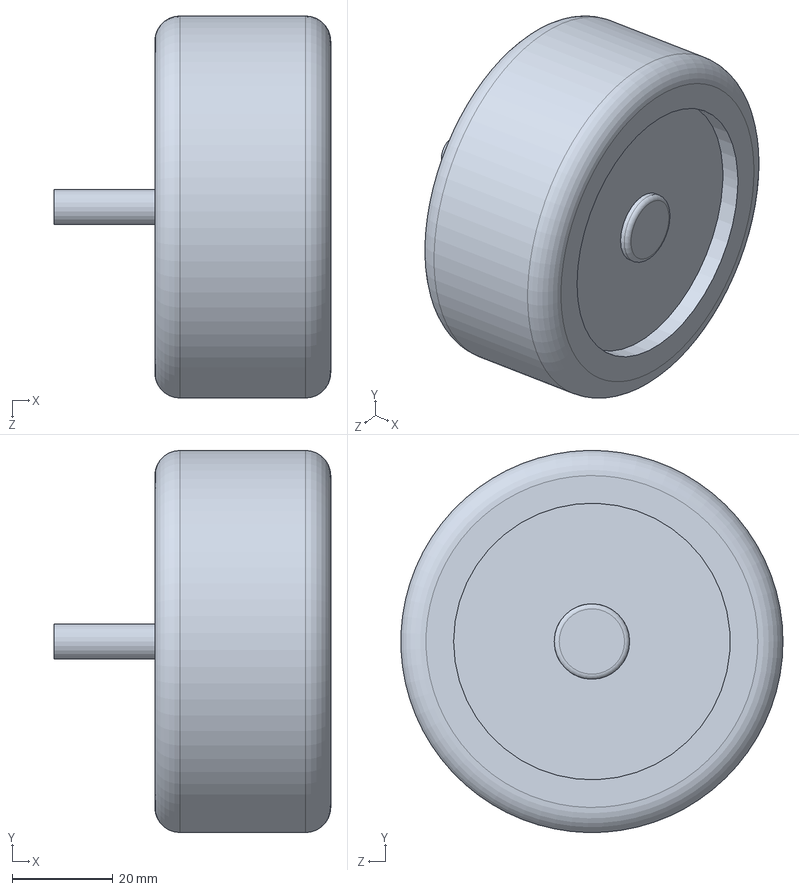
[picture p52: CAD file, 2016-10-30]
Solidworks/Discarded/hjul.SLDPRT
55.0 x 76.0 x 76.0 mm
