MathiasKoch/roberto_mechanical/Solidworks/Parts/battery.SLDPRT

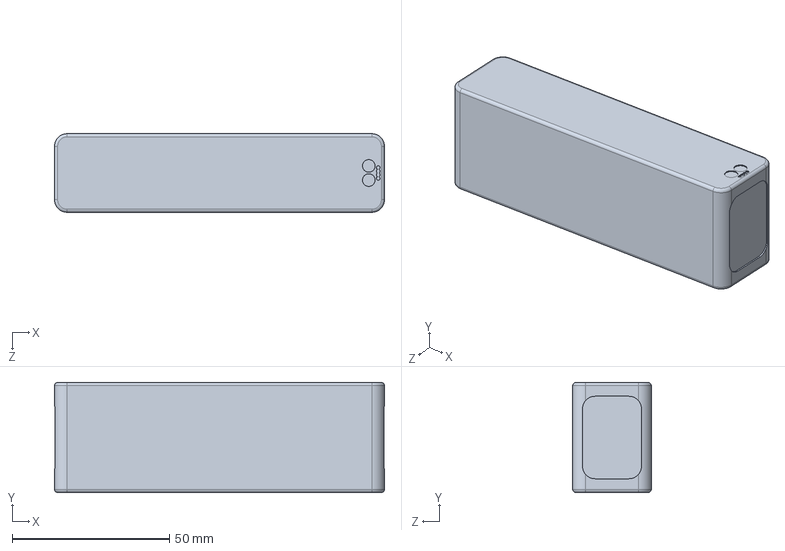
[picture p53: CAD file, 2017-02-08]
Solidworks/Parts/battery.SLDPRT
105.0 x 35.0 x 25.0 mm
