MathiasKoch/roberto_mechanical/Solidworks/Parts/Charger/SON8-2x2mm_charger.SLDPRT

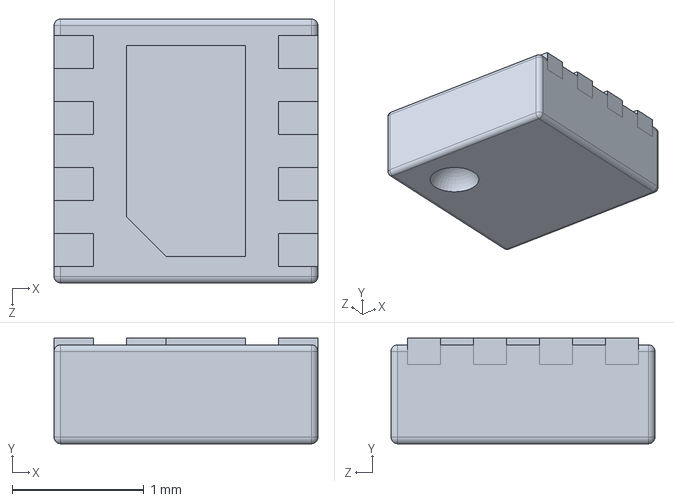
[picture p54: CAD file, 2016-11-09]
Solidworks/Parts/Charger/SON8-2x2mm_charger.SLDPRT
2.00 x 0.8 x 2.00 mm
