MathiasKoch/roberto_mechanical/Solidworks/Parts/Connectors/8 way jst shr-08v-s-b.SLDPRT

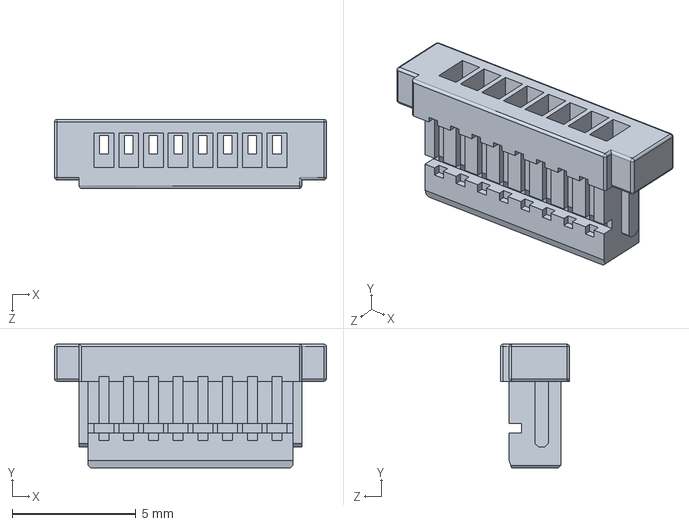
[picture p55: CAD file, 2016-11-09]
Solidworks/Parts/Connectors/8 way jst shr-08v-s-b.SLDPRT
11.0 x 5.00 x 2.80 mm
