MathiasKoch/roberto_mechanical/Solidworks/User Library-Finished golf ball.SLDPRT

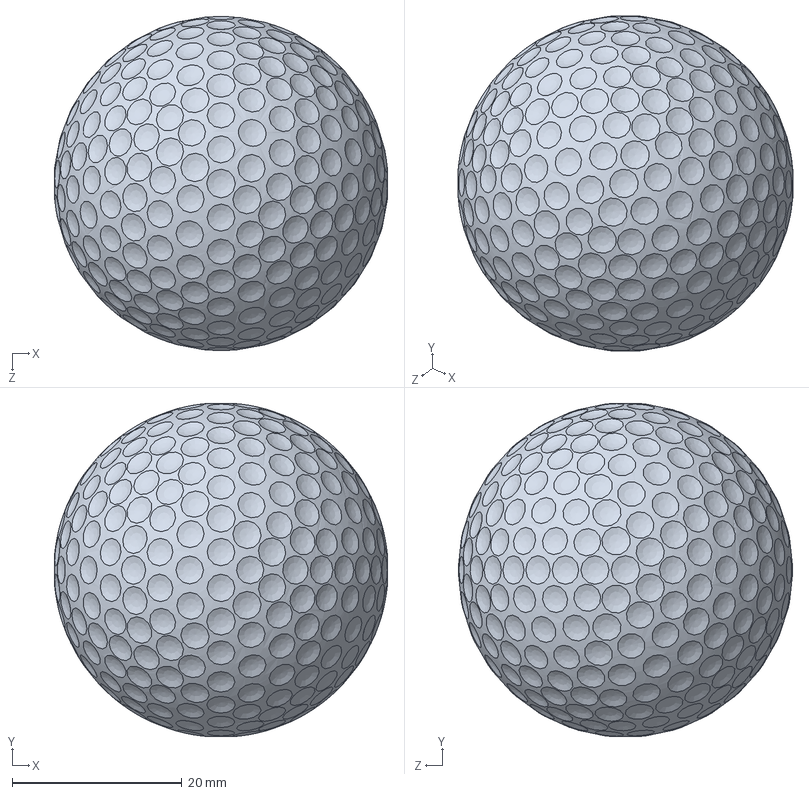
[picture p56: CAD file, 2016-11-09]
Solidworks/User Library-Finished golf ball.SLDPRT
39.2 x 39.2 x 39.4 mm
