MathiasKoch/roberto_mechanical/DipTrace/3D/CHARGER/hdrf-2x3t_2.54x2.54_8x5.step

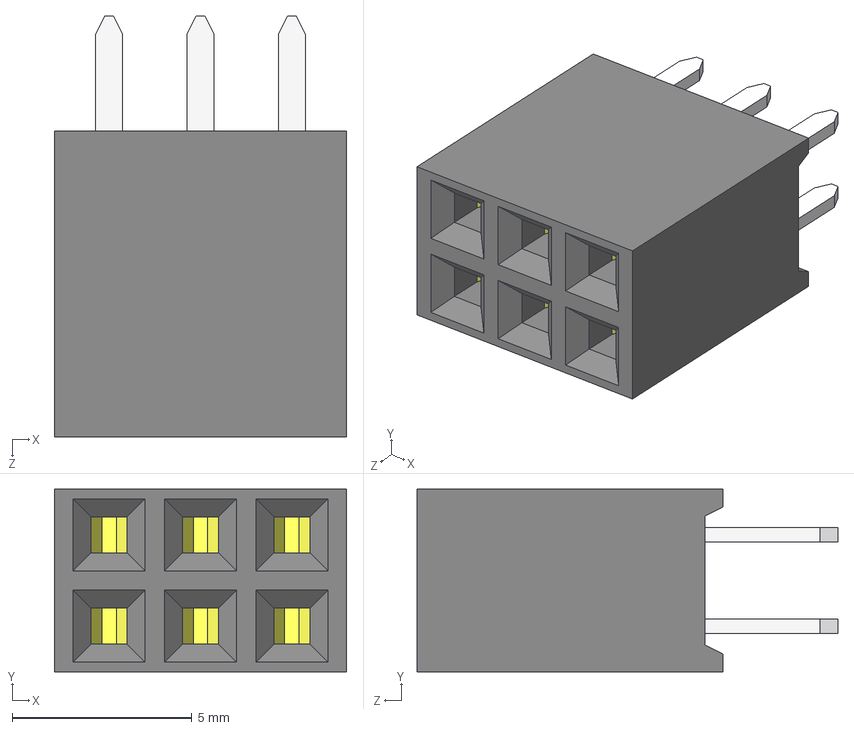
[picture p57: CAD file, 2017-08-20]
DipTrace/3D/CHARGER/hdrf-2x3t_2.54x2.54_8x5.step
8.12 x 5.08 x 11.7 mm
hdrf-2x3t_2.54x2.54_8x5
hdrf-2x3t_2.54x2.54_8x5_001
hdrf-2x3t_2.54x2.54_8x5_002
