MathiasKoch/roberto_mechanical/DipTrace/3D/DISTRIBUTION/20-VQFN (3_5x4_5).step

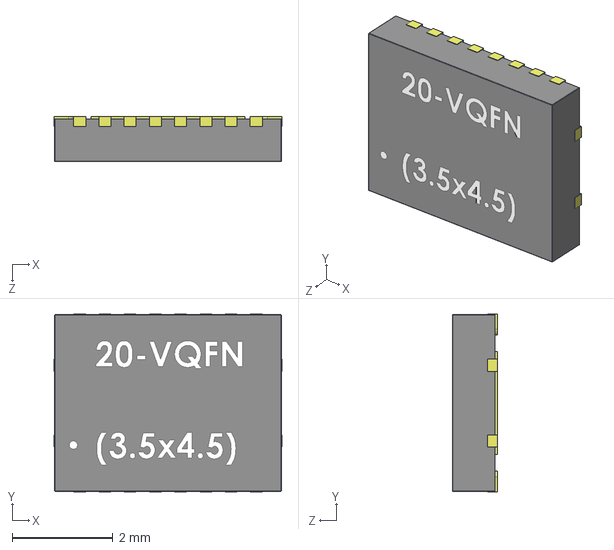
[picture p58: CAD file, 2017-08-20]
DipTrace/3D/DISTRIBUTION/20-VQFN (3_5x4_5).step
4.52 x 3.52 x 0.9 mm
