MathiasKoch/roberto_mechanical/DipTrace/3D/MOTOR/CAT10-000.STEP

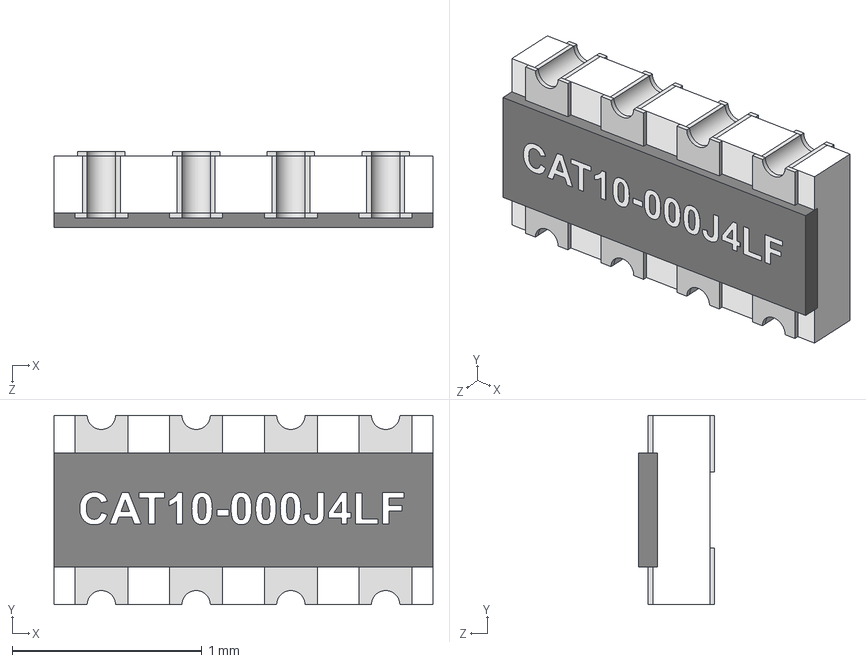
[picture p59: CAD file, 2017-08-20]
DipTrace/3D/MOTOR/CAT10-000.STEP
2.00 x 1.00 x 0.401 mm
User Library-CAT10-000_BODY1
User Library-CAT10-000_LEAD_MID x 8
User Library-CAT10-000_LEAD_TOP x 8
User Library-CAT10-000_LEAD_BOT x 8
User Library-CAT10-000_BODY2
User Library-CAT10-000_STRING_000
