MathiasKoch/roberto_mechanical/Solidworks/CircuitWorks/BUILT-BY-CIRCUITWORKS/components/SIP 9.SLDPRT

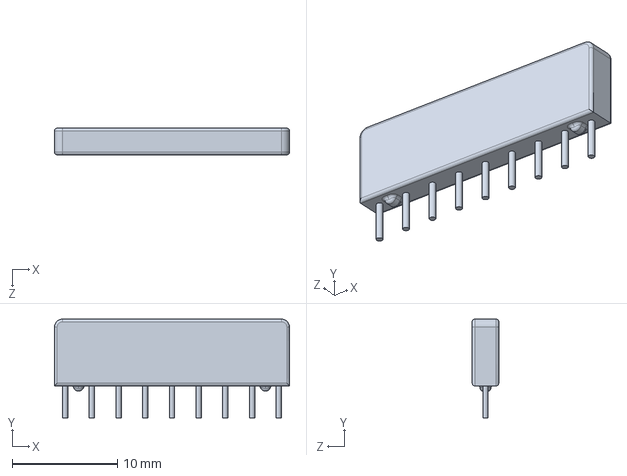
[picture p60: CAD file, 2016-11-10]
Solidworks/CircuitWorks/BUILT-BY-CIRCUITWORKS/components/SIP 9.SLDPRT
22.4 x 9.40 x 2.54 mm
