MathiasKoch/roberto_mechanical/Solidworks/Discarded/motor_mount_1.SLDPRT

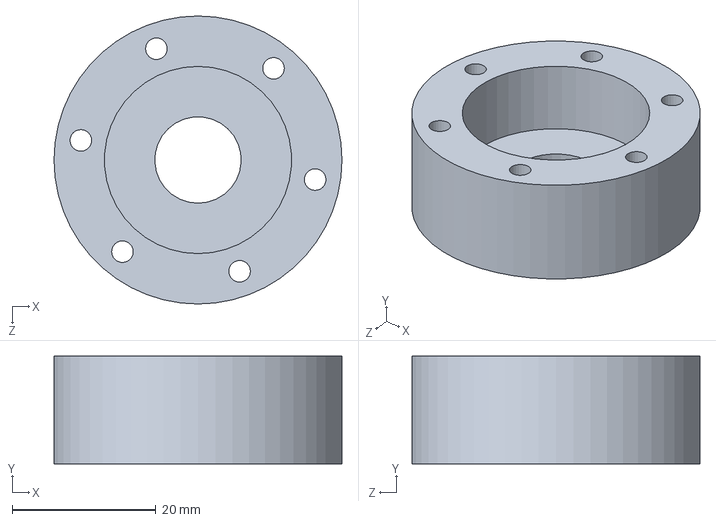
[picture p61: CAD file, 2016-10-30]
Solidworks/Discarded/motor_mount_1.SLDPRT
40.0 x 15.0 x 40.0 mm
