MathiasKoch/roberto_mechanical/Solidworks/Parts/Buttons/B8B-PH-SM4_buttons.SLDPRT

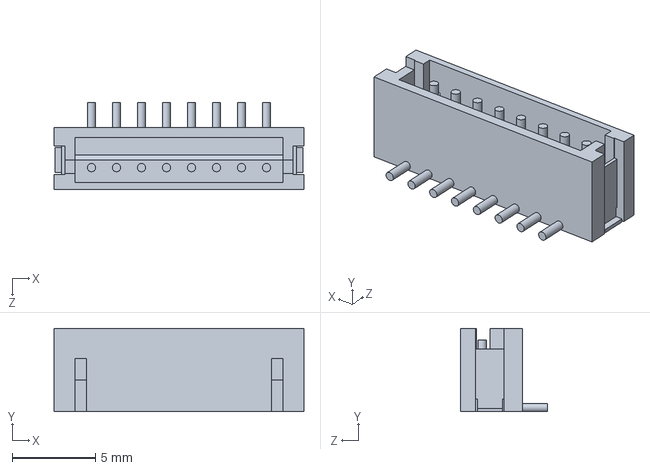
[picture p62: CAD file, 2016-11-10]
Solidworks/Parts/Buttons/B8B-PH-SM4_buttons.SLDPRT
15.0 x 5.00 x 5.20 mm
