MathiasKoch/roberto_mechanical/Solidworks/Parts/Charger/2x4 female header 2_54mm pitch_charger.SLDPRT

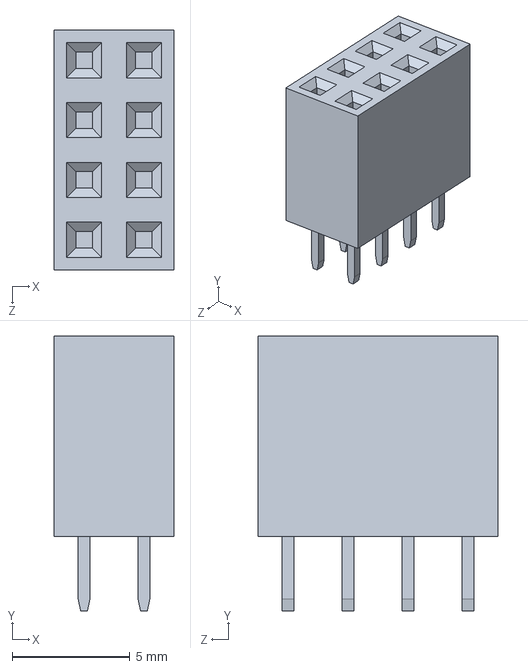
[picture p63: CAD file, 2016-11-09]
Solidworks/Parts/Charger/2x4 female header 2_54mm pitch_charger.SLDPRT
5.08 x 11.7 x 10.2 mm
