MathiasKoch/roberto_mechanical/Solidworks/Parts/Distribution/2x4_male_2.0x2.0_distribution.SLDPRT

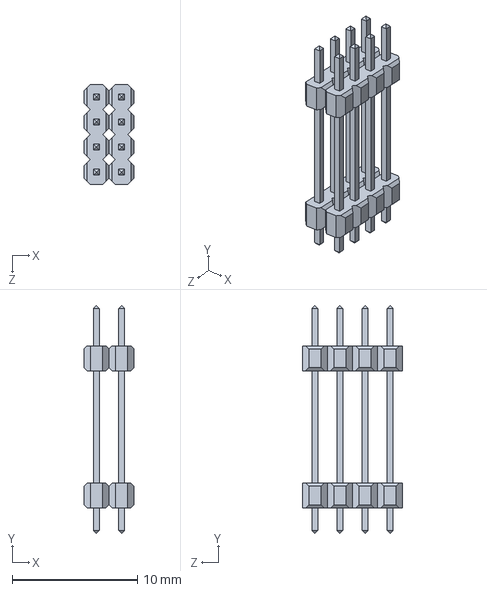
[picture p64: CAD file, 2016-11-10]
Solidworks/Parts/Distribution/2x4_male_2.0x2.0_distribution.SLDPRT
4.00 x 18.2 x 8.00 mm
