MathiasKoch/roberto_mechanical/Solidworks/Parts/Motor/3x4 female header 2_54mm pitch_motor.SLDPRT

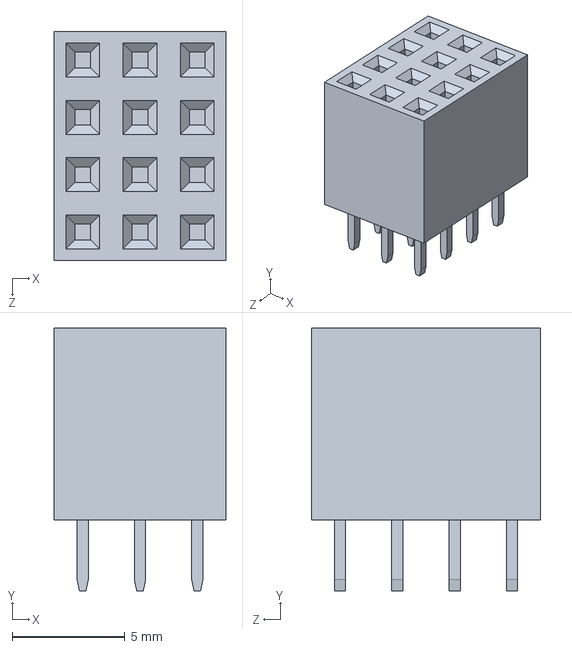
[picture p65: CAD file, 2016-11-09]
Solidworks/Parts/Motor/3x4 female header 2_54mm pitch_motor.SLDPRT
7.62 x 11.7 x 10.2 mm
