MathiasKoch/roberto_mechanical/Solidworks/Parts/oled_display.SLDPRT

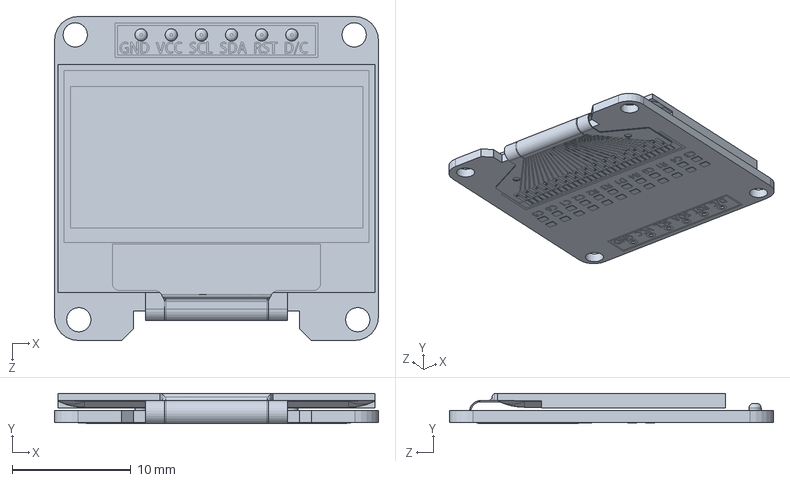
[picture p66: CAD file, 2016-11-17]
Solidworks/Parts/oled_display.SLDPRT
27.3 x 2.56 x 27.3 mm
