MathiasKoch/roberto_mechanical/DipTrace/3D/DISTRIBUTION/qfn-36l_6x6x0.5.step

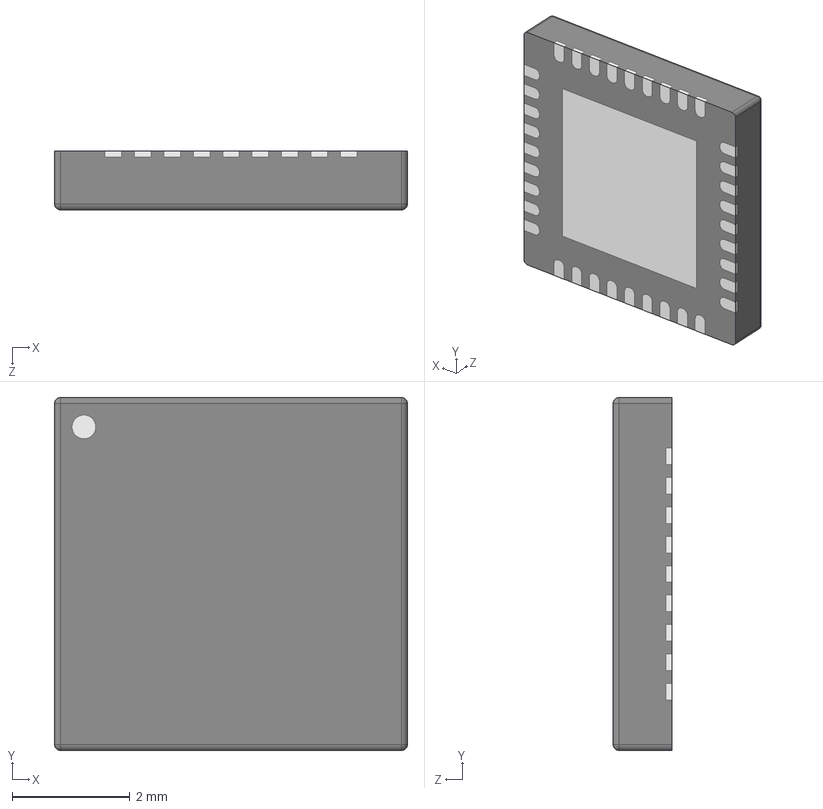
[picture p67: CAD file, 2017-08-20]
DipTrace/3D/DISTRIBUTION/qfn-36l_6x6x0.5.step
6.00 x 6.00 x 1.00 mm
