MathiasKoch/roberto_mechanical/DipTrace/3D/MOTOR/hdrf-2x2t_2.54x2.54_6x5.step

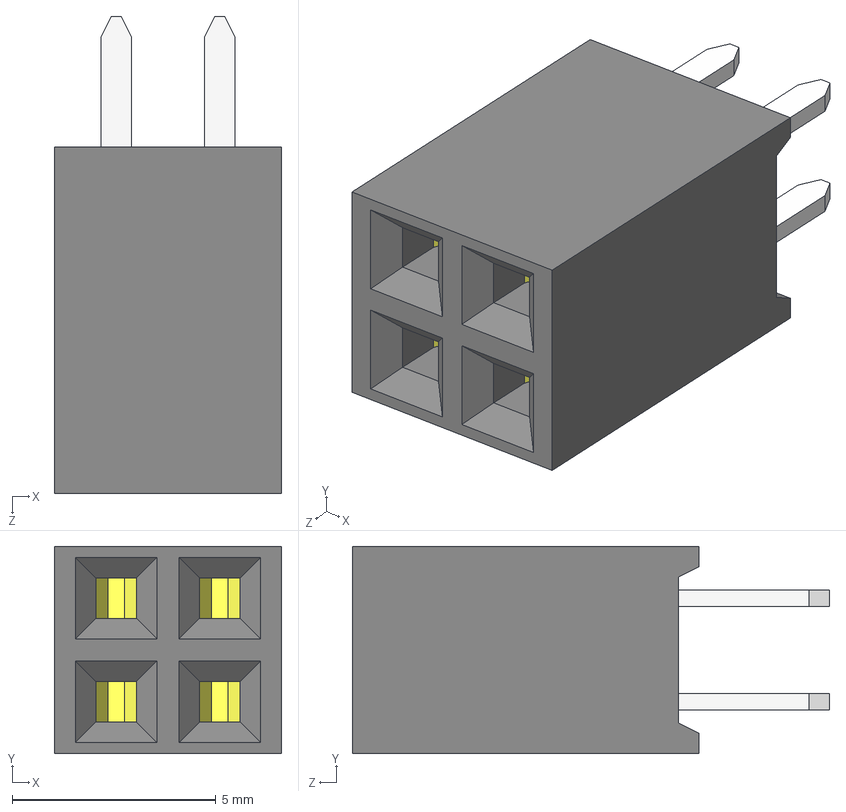
[picture p68: CAD file, 2017-08-20]
DipTrace/3D/MOTOR/hdrf-2x2t_2.54x2.54_6x5.step
5.58 x 5.08 x 11.7 mm
hdrf-2x2t_2.54x2.54_6x5
hdrf-2x2t_2.54x2.54_6x5_001
hdrf-2x2t_2.54x2.54_6x5_002
