MathiasKoch/roberto_mechanical/Solidworks/CircuitWorks/Distribution/2x2_male_2.54x254.SLDPRT

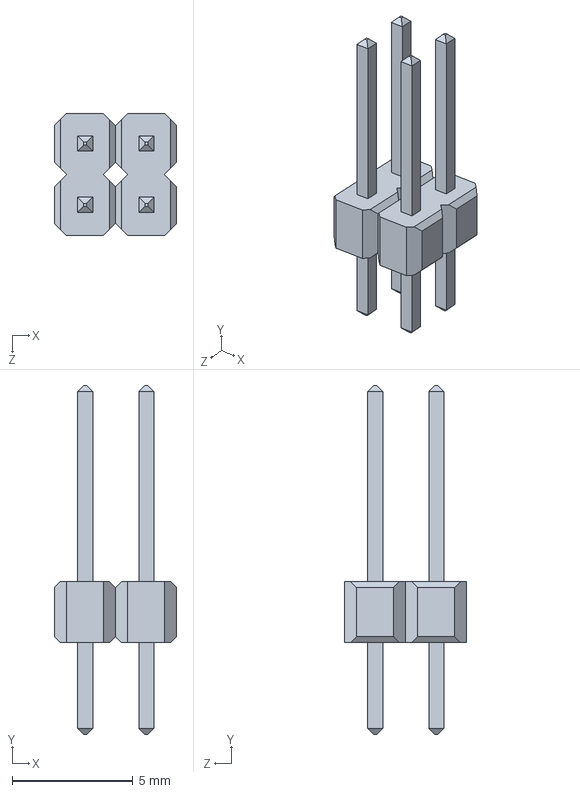
[picture p69: CAD file, 2016-11-10]
Solidworks/CircuitWorks/Distribution/2x2_male_2.54x254.SLDPRT
5.08 x 14.5 x 5.08 mm
