MathiasKoch/roberto_mechanical/Solidworks/Discarded/LCD.SLDPRT

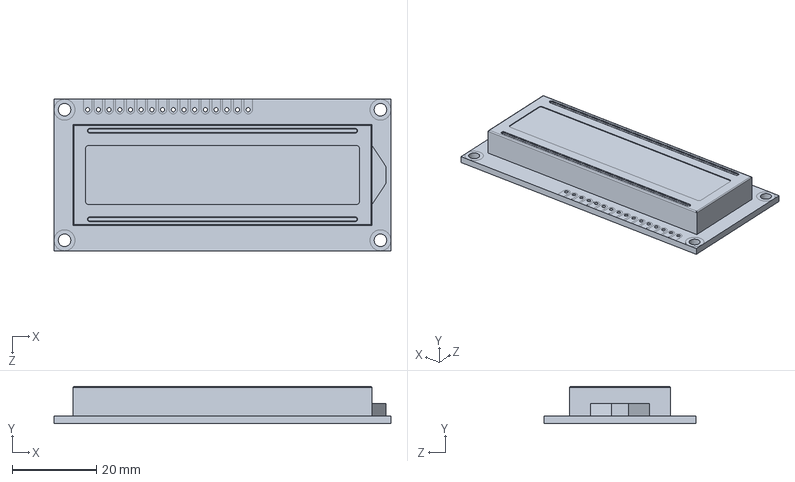
[picture p70: CAD file, 2016-10-30]
Solidworks/Discarded/LCD.SLDPRT
80.0 x 8.80 x 36.0 mm
