MathiasKoch/roberto_mechanical/Solidworks/Parts/Charger/Resistor 2512_charger.SLDPRT

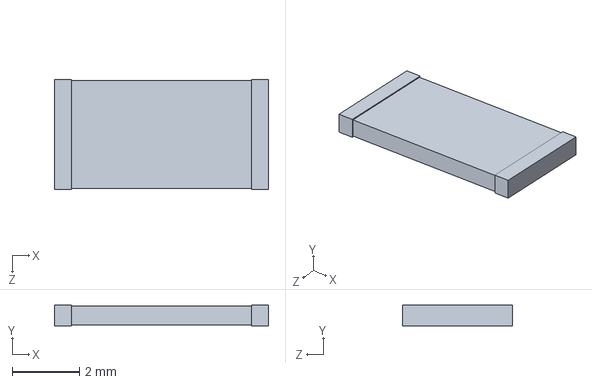
[picture p71: CAD file, 2016-11-09]
Solidworks/Parts/Charger/Resistor 2512_charger.SLDPRT
6.35 x 0.61 x 3.26 mm
