MathiasKoch/roberto_mechanical/Solidworks/Parts/Motor/2x2 female header 2_54mm pitch_motor.SLDPRT

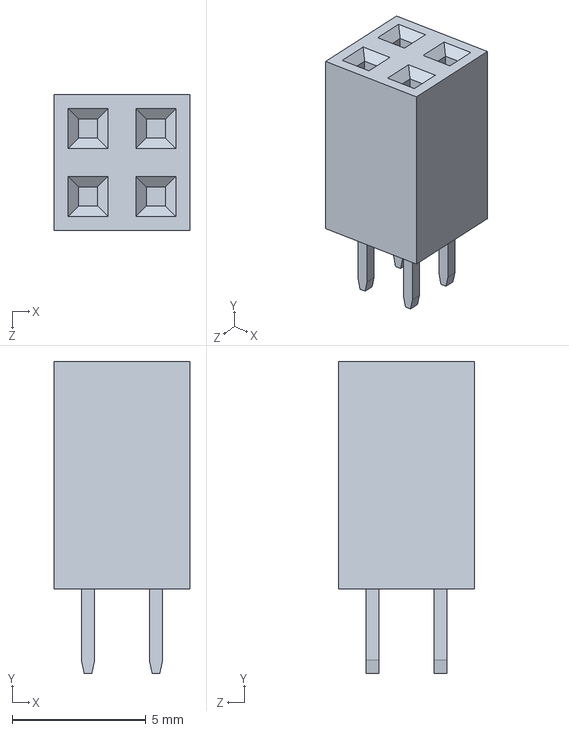
[picture p72: CAD file, 2016-11-09]
Solidworks/Parts/Motor/2x2 female header 2_54mm pitch_motor.SLDPRT
5.08 x 11.7 x 5.08 mm
