MathiasKoch/roberto_mechanical/Solidworks/Parts/ODROID.SLDPRT

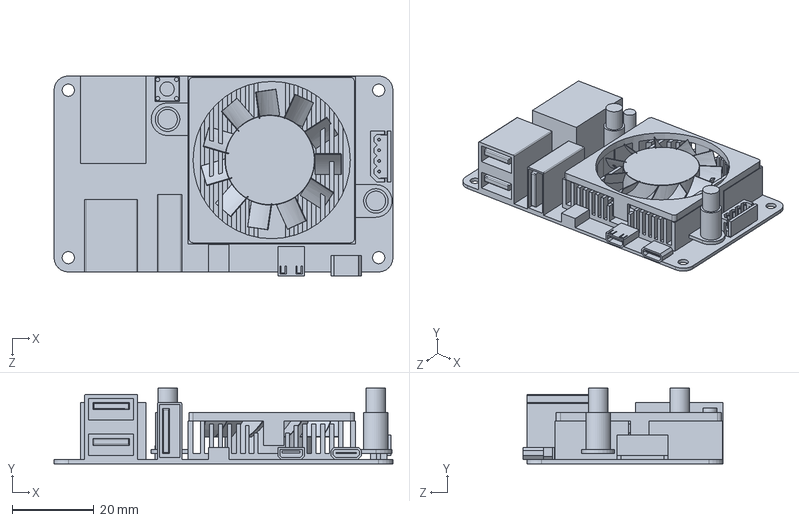
[picture p73: CAD file, 2016-11-17]
Solidworks/Parts/ODROID.SLDPRT
83.0 x 18.5 x 49.0 mm
