MathiasKoch/roberto_mechanical/DipTrace/3D/CHARGER/hdrf-1x4t_2.54_11x3.step

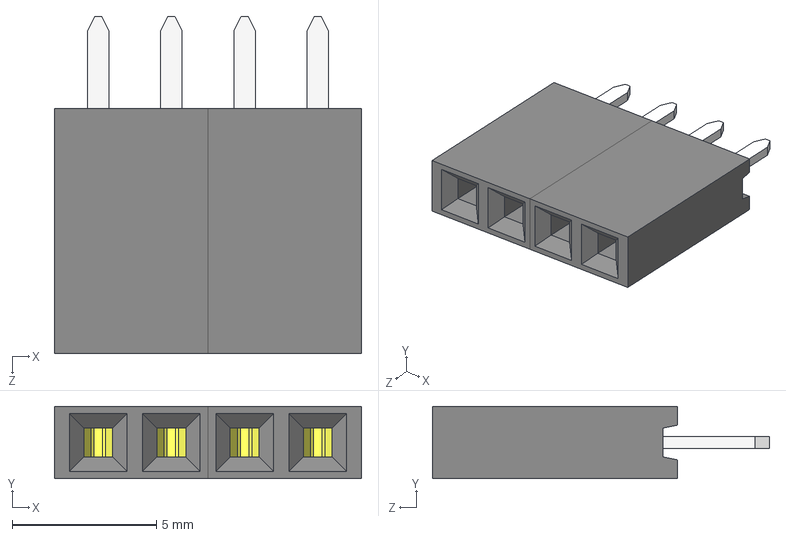
[picture p74: CAD file, 2017-08-20]
DipTrace/3D/CHARGER/hdrf-1x4t_2.54_11x3.step
10.7 x 2.50 x 11.7 mm
