MathiasKoch/roberto_mechanical/Solidworks/CircuitWorks/Charger/B4B-ZR-SM4-TF.SLDPRT

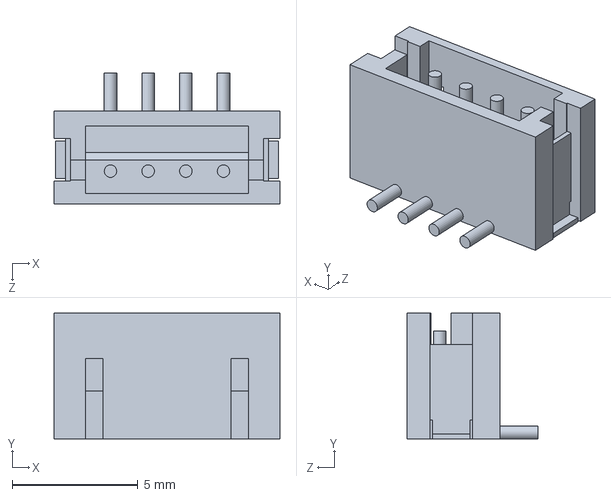
[picture p75: CAD file, 2016-11-09]
Solidworks/CircuitWorks/Charger/B4B-ZR-SM4-TF.SLDPRT
9.00 x 5.00 x 5.20 mm
