MathiasKoch/roberto_mechanical/Solidworks/Discarded/base_bottom.SLDPRT

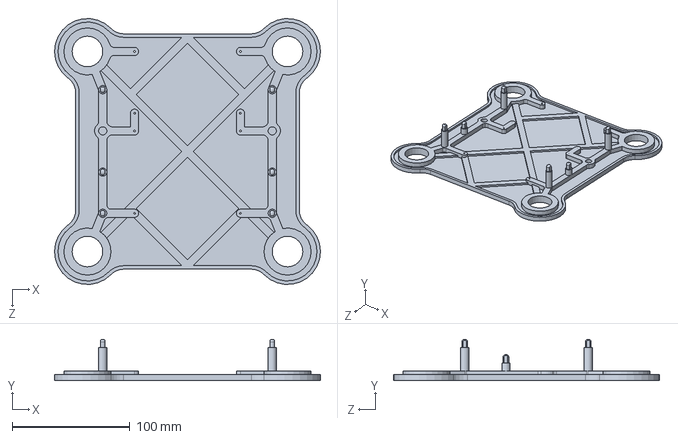
[picture p76: CAD file, 2016-10-30]
Solidworks/Discarded/base_bottom.SLDPRT
226.0 x 35.0 x 225.8 mm
