MathiasKoch/roberto_mechanical/Solidworks/Parts/Charger/TSSOP-20_charger.SLDPRT

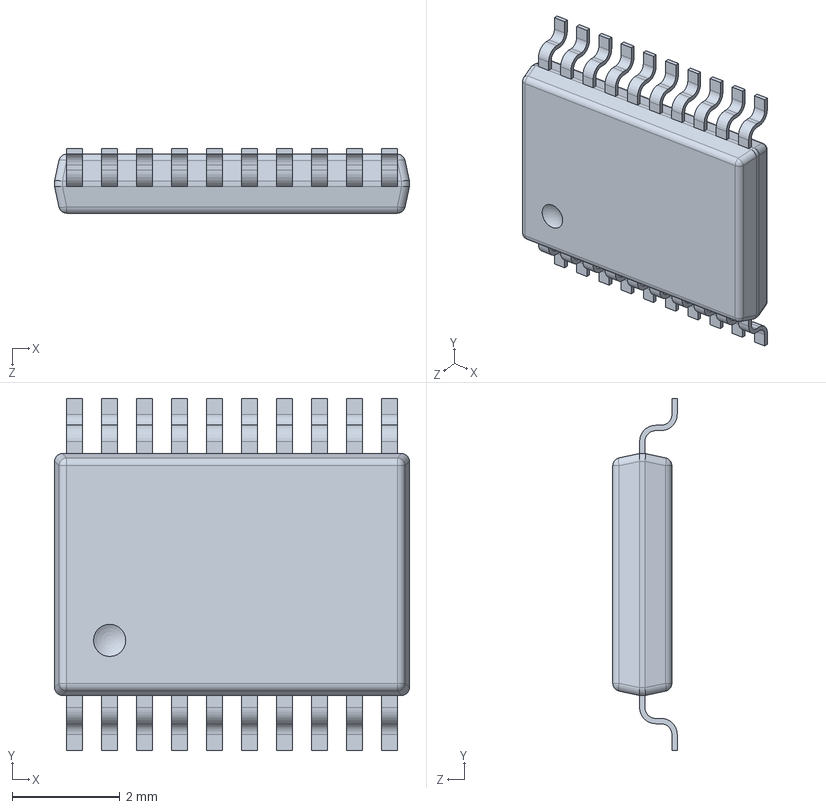
[picture p77: CAD file, 2016-11-09]
Solidworks/Parts/Charger/TSSOP-20_charger.SLDPRT
6.60 x 6.55 x 1.20 mm
