MathiasKoch/roberto_mechanical/Solidworks/Parts/Distribution/LED DIP 3MM_distribution.SLDPRT

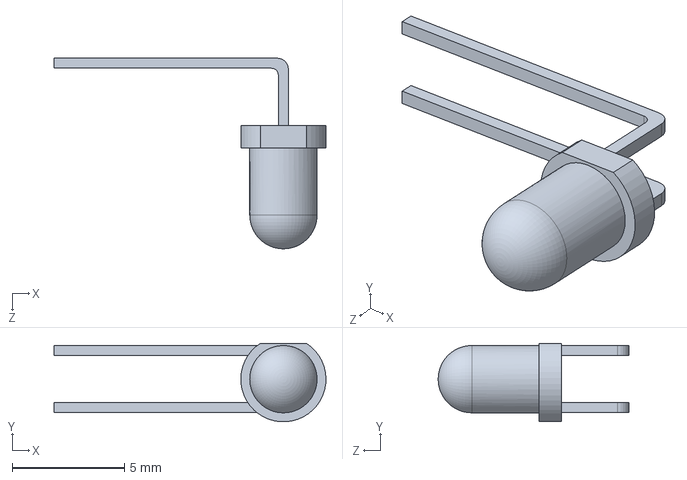
[picture p78: CAD file, 2016-11-10]
Solidworks/Parts/Distribution/LED DIP 3MM_distribution.SLDPRT
12.1 x 3.50 x 8.50 mm
