MathiasKoch/roberto_mechanical/Solidworks/Parts/Encoder/Capacitor 0805_encoder.SLDPRT

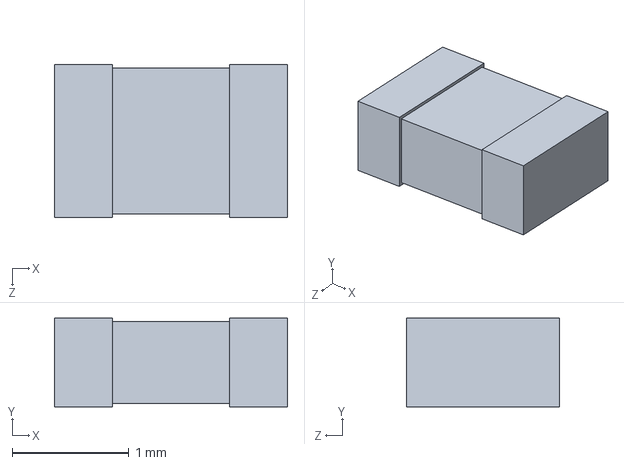
[picture p79: CAD file, 2016-11-10]
Solidworks/Parts/Encoder/Capacitor 0805_encoder.SLDPRT
2.00 x 0.76 x 1.31 mm
