MathiasKoch/roberto_mechanical/Solidworks/Parts/plate_stick_short.SLDPRT

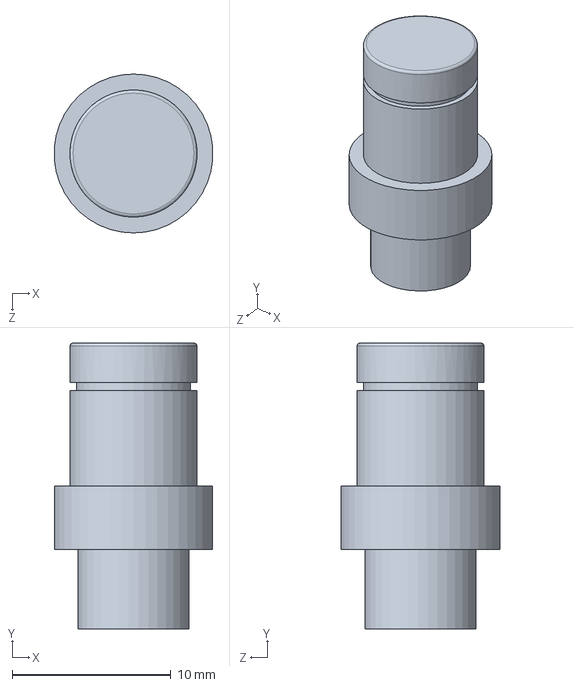
[picture p80: CAD file, 2016-11-17]
Solidworks/Parts/plate_stick_short.SLDPRT
9.97 x 18.0 x 10.0 mm
