MathiasKoch/roberto_mechanical/DipTrace/3D/CHARGER/tc_2917.step

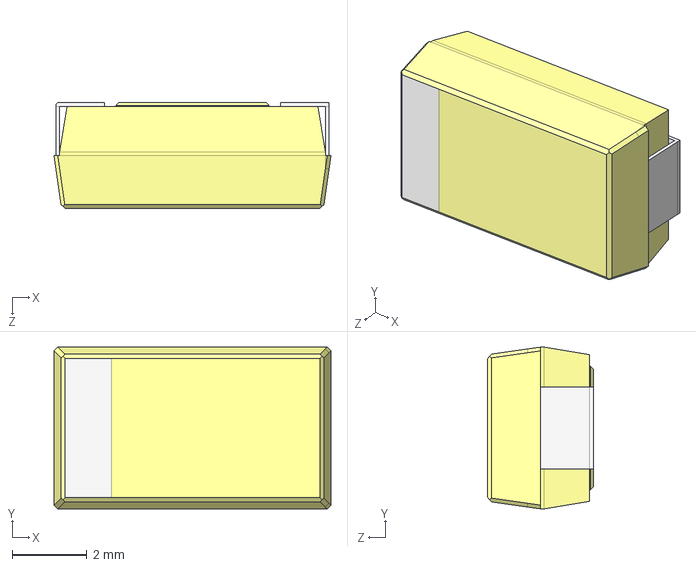
[picture p81: CAD file, 2017-08-20]
DipTrace/3D/CHARGER/tc_2917.step
7.40 x 4.32 x 2.82 mm
