MathiasKoch/roberto_mechanical/Solidworks/CircuitWorks/BUILT-BY-CIRCUITWORKS/components/BAS-16.SLDPRT

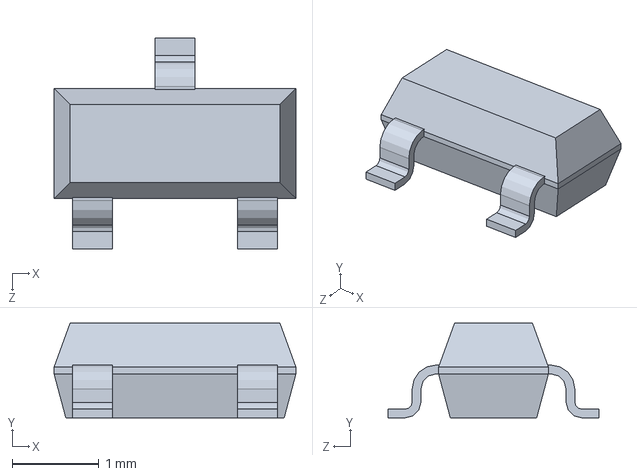
[picture p82: CAD file, 2016-11-10]
Solidworks/CircuitWorks/BUILT-BY-CIRCUITWORKS/components/BAS-16.SLDPRT
2.79 x 1.09 x 2.44 mm
