MathiasKoch/roberto_mechanical/Solidworks/Parts/Charger/ISP_Header_charger.SLDPRT

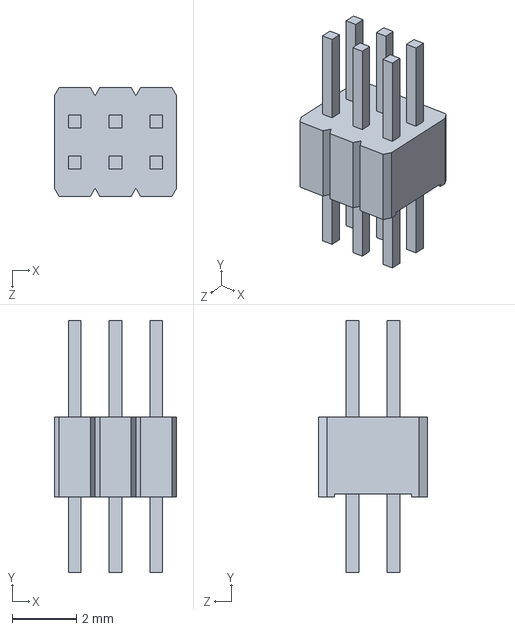
[picture p83: CAD file, 2016-11-09]
Solidworks/Parts/Charger/ISP_Header_charger.SLDPRT
3.81 x 7.85 x 3.40 mm
