MathiasKoch/roberto_mechanical/Solidworks/Parts/Motor/UFQFPN48_motor.SLDPRT

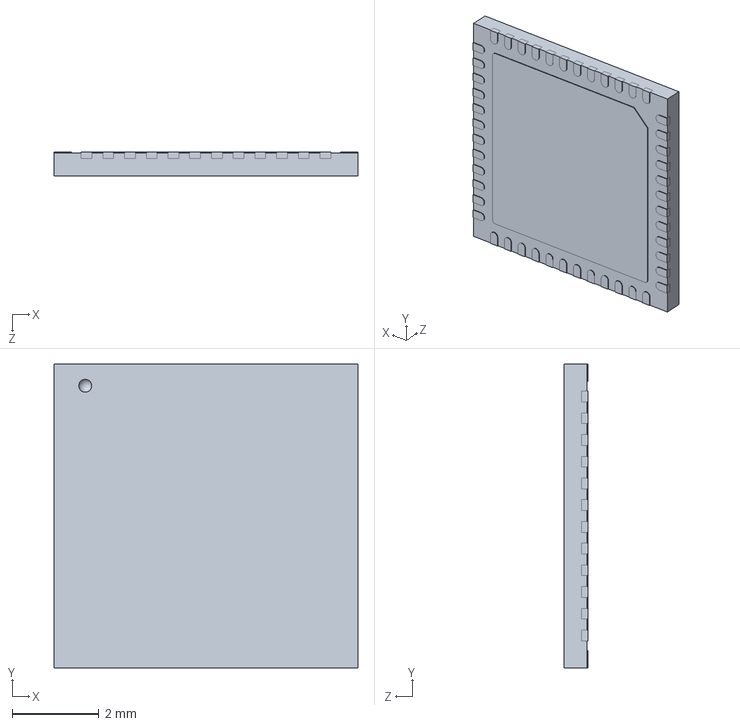
[picture p84: CAD file, 2016-11-09]
Solidworks/Parts/Motor/UFQFPN48_motor.SLDPRT
7.00 x 7.00 x 0.55 mm
