MathiasKoch/roberto_mechanical/Solidworks/Parts/servo_horn.SLDPRT

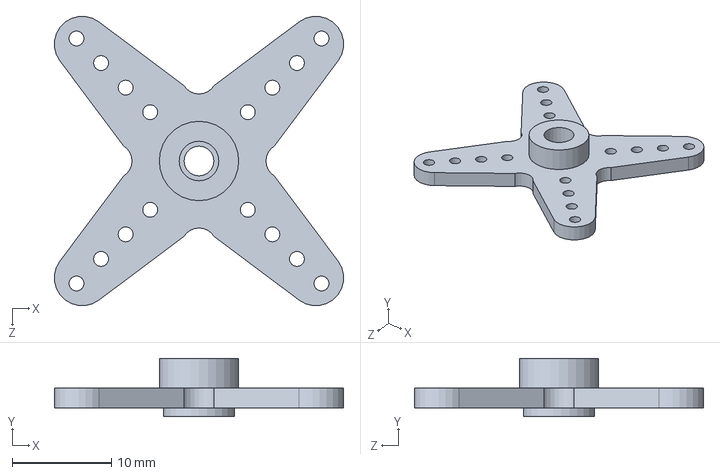
[picture p85: CAD file, 2016-11-17]
Solidworks/Parts/servo_horn.SLDPRT
29.1 x 5.85 x 29.1 mm
