MathiasKoch/roberto_mechanical/DipTrace/3D/MOTOR/hdrf-2x4t_2.54x2.54_11x5.step

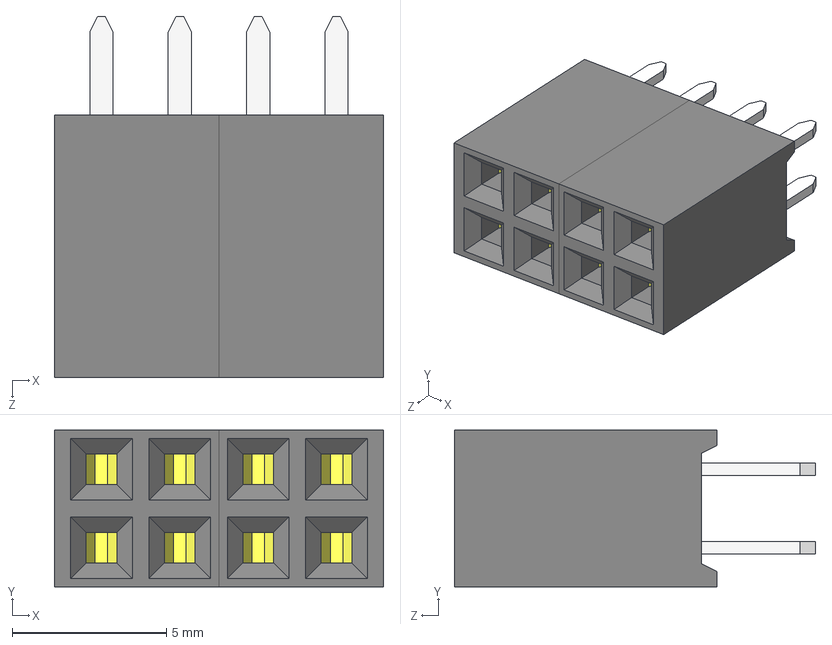
[picture p86: CAD file, 2017-08-20]
DipTrace/3D/MOTOR/hdrf-2x4t_2.54x2.54_11x5.step
10.7 x 5.08 x 11.7 mm
hdrf-2x4t_2.54x2.54_11x5
hdrf-2x4t_2.54x2.54_11x5_001
hdrf-2x4t_2.54x2.54_11x5_002
