MathiasKoch/roberto_mechanical/(list of files, cad)

Other CAD files:
Solidworks/Assem2.SLDASM
Solidworks/Assemblies/Wires/battery_cable.sldasm
Solidworks/Assem6.SLDASM
Solidworks/Assemblies/Wires/bat_cable.sldasm
Solidworks/Parts/Connectors/Cable_2-Assem1_Robot_2.0.sldasm
Solidworks/Assem7.SLDASM
Solidworks/Discarded/Electronics/hdr-2x3t_2.54x2.54_8x5_1.sldprt
Solidworks/Drawings/dwg/gripper_simpel.DWG
Solidworks/Parts/Buttons/Tactile switch 6x6x5mm_buttons.SLDPRT
Solidworks/Parts/Distribution/Dip_distribution.sldprt
Solidworks/Parts/Encoder/Dip_encoder.sldprt
Solidworks/Parts/Smart-Parts/XT60 MALE.SLDPRT
Solidworks/CircuitWorks/BUILT-BY-CIRCUITWORKS/components/TO92TR_NPNTR.sldprt
Solidworks/CircuitWorks/Distribution/XT-60.SLDPRT
Solidworks/Discarded/Electronics/Board_1.sldprt
Solidworks/Drawings/dwg/servo1_mount5.DWG
Solidworks/Parts/Buttons/Tactile switch 6x6x5mm_buttons_CUT.SLDPRT
Solidworks/Parts/Encoder/GeyerElectronics_KX14_encoder.SLDPRT
Solidworks/Parts/Motor/PowSO30-ST_motor.SLDPRT
Solidworks/Discarded/Electronics/JST,BxB-XH-A4_PIN_1.sldprt
Solidworks/Drawings/dwg/gripper_with_gear_right.DWG
Solidworks/Parts/Buttons/Dip_buttons.sldprt
Solidworks/Parts/Charger/Static_Via_Static_Via_charger.sldprt
Solidworks/Parts/Encoder/ATmega 168_encoder.SLDPRT
Solidworks/Parts/Motor/Hole_Hole_motor.sldprt
DipTrace/3D/DISTRIBUTION/S3B-ZR-SM4A-TF.STEP
Solidworks/Discarded/Electronics/LED-1206_1.sldprt
Solidworks/Drawings/dwg/gripper_bottom_connector.DWG
Solidworks/Parts/Buttons/Capacitor 0603_buttons.SLDPRT
Solidworks/Parts/Distribution/S4B-ZR-SM4A-TF_distribution.SLDPRT
Solidworks/Parts/Encoder/res0402-1_encoder.SLDPRT
Solidworks/Parts/Motor/GeyerElectronics_KX7_motor.SLDPRT
Solidworks/CircuitWorks/Distribution/1x3_male_2.54x254.SLDPRT
Solidworks/Discarded/Electronics/JST,BxB-XH-A4_PIN_1_1.sldprt
Solidworks/Drawings/dwg/servo1_mount.DWG
Solidworks/Parts/Encoder/Hole_Hole_encoder.sldprt
Solidworks/CircuitWorks/BUILT-BY-CIRCUITWORKS/components/Hole_1_Hole_1.sldprt
Solidworks/Discarded/Electronics/POWER_SO-20.sldprt
Solidworks/Drawings/dwg/camera_mount_v2.DWG
Solidworks/Parts/Buttons/S4B-ZR-SM4A-TF_buttons.SLDPRT
Solidworks/Parts/Distribution/2x2_male_2.54x254_distribution.SLDPRT
Solidworks/Parts/Encoder/Static_Via_Static_Via_encoder.sldprt
DipTrace/3D/MOTOR/S4B-ZR-SM4A-TF_motor.STEP
Solidworks/CircuitWorks/BUILT-BY-CIRCUITWORKS/components/DIP508D_DIODE.sldprt
Solidworks/CircuitWorks/Distribution/2x4_male_2.0x2.0.SLDPRT
Solidworks/Discarded/Electronics/JST,BxB-XH-A4_PIN_1_2.sldprt
Solidworks/Drawings/dwg/servo1_mount2.DWG
Solidworks/Parts/Buttons/Hole_Hole_buttons.sldprt
Solidworks/Parts/Motor/Switch-CK-KMR2_motor.SLDPRT
DipTrace/3D/DISTRIBUTION/LED DIP 3MM.STEP
DipTrace/3D/MOTOR/B4B-PH-SM4(LF)(SN)_motor.STEP
Solidworks/CircuitWorks/Distribution/LED DIP 3MM.SLDPRT
Solidworks/Discarded/Electronics/smc.sldprt
Solidworks/Drawings/dwg/gripper_bottom_connector_servo.DWG
Solidworks/Parts/Buttons/4xRes_0402_buttons.SLDPRT
Solidworks/Parts/Distribution/Resistor 0603_distribution.SLDPRT
Solidworks/Parts/Encoder/ISP_Header_encoder.SLDPRT
DipTrace/3D/DISTRIBUTION/XT-60.STEP
DipTrace/3D/CHARGER/B8B-PH-SM4.STEP
DipTrace/3D/CHARGER/Coilcraft-XFL3012.step
DipTrace/3D/CHARGER/S4B-ZR-SM4A-TF.STEP
DipTrace/3D/CHARGER/SO-8.step
DipTrace/3D/CHARGER/SON8-2x2mm-1.step
DipTrace/3D/CHARGER/TDFN-8-EP_3x3mm.step
DipTrace/3D/CHARGER/res_2512.step
DipTrace/3D/CHARGER/sdr1105.stp
Solidworks/CircuitWorks/BUILT-BY-CIRCUITWORKS/components/0402c_2320560.sldprt
Solidworks/CircuitWorks/BUILT-BY-CIRCUITWORKS/components/0402r_1430758.sldprt
Solidworks/CircuitWorks/BUILT-BY-CIRCUITWORKS/components/0404_r_1620019.sldprt
Solidworks/CircuitWorks/BUILT-BY-CIRCUITWORKS/components/0805.SLDPRT
Solidworks/CircuitWorks/BUILT-BY-CIRCUITWORKS/components/0_125W Metal Film Resistor.SLDPRT
Solidworks/CircuitWorks/BUILT-BY-CIRCUITWORKS/components/0_25W Carbon Film Resistor.SLDPRT
Solidworks/CircuitWorks/BUILT-BY-CIRCUITWORKS/components/0_25W Metal Film Resistor.SLDPRT
Solidworks/CircuitWorks/BUILT-BY-CIRCUITWORKS/components/0_33W Carbon Film Resistor.SLDPRT
Solidworks/CircuitWorks/BUILT-BY-CIRCUITWORKS/components/0_5W Metal Film Resistor.SLDPRT
Solidworks/CircuitWorks/BUILT-BY-CIRCUITWORKS/components/0_66W Carbon Film Resistor.SLDPRT
Solidworks/CircuitWorks/BUILT-BY-CIRCUITWORKS/components/1206.SLDPRT
Solidworks/CircuitWorks/BUILT-BY-CIRCUITWORKS/components/1PS76SB10_1PS76SB10.sldprt
Solidworks/CircuitWorks/BUILT-BY-CIRCUITWORKS/components/1PS76SB10_1_1PS76SB10_1.sldprt
Solidworks/CircuitWorks/BUILT-BY-CIRCUITWORKS/components/1W Carbon Film Resistor.SLDPRT
Solidworks/CircuitWorks/BUILT-BY-CIRCUITWORKS/components/1x3 female header 2_54mm pitch.SLDPRT
Solidworks/CircuitWorks/BUILT-BY-CIRCUITWORKS/components/1x3_male_2.54x254.SLDPRT
Solidworks/CircuitWorks/BUILT-BY-CIRCUITWORKS/components/2512.SLDPRT
Solidworks/CircuitWorks/BUILT-BY-CIRCUITWORKS/components/2N7002KW_2N7002KW.sldprt
Solidworks/CircuitWorks/BUILT-BY-CIRCUITWORKS/components/2W Carbon Film Resistor.SLDPRT
Solidworks/CircuitWorks/BUILT-BY-CIRCUITWORKS/components/2x2 female header 2_54mm pitch.SLDPRT
Solidworks/CircuitWorks/BUILT-BY-CIRCUITWORKS/components/2x2_male_2.54x254.SLDPRT
Solidworks/CircuitWorks/BUILT-BY-CIRCUITWORKS/components/2x3 female header 2_54mm pitch.SLDPRT
Solidworks/CircuitWorks/BUILT-BY-CIRCUITWORKS/components/2x3_male_2.54x254.SLDPRT
Solidworks/CircuitWorks/BUILT-BY-CIRCUITWORKS/components/2x4 female header 2_54mm pitch.SLDPRT
Solidworks/CircuitWorks/BUILT-BY-CIRCUITWORKS/components/2x4_male_2.0x2.0.SLDPRT
Solidworks/CircuitWorks/BUILT-BY-CIRCUITWORKS/components/2x4_male_2.54x254.SLDPRT
Solidworks/CircuitWorks/BUILT-BY-CIRCUITWORKS/components/3x4 female header 2_54mm pitch.SLDPRT
Solidworks/CircuitWorks/BUILT-BY-CIRCUITWORKS/components/3x4_male_2.54x254.SLDPRT
Solidworks/CircuitWorks/BUILT-BY-CIRCUITWORKS/components/4xRes_0402.SLDPRT
Solidworks/CircuitWorks/BUILT-BY-CIRCUITWORKS/components/5mm LED RED.SLDPRT
Solidworks/CircuitWorks/BUILT-BY-CIRCUITWORKS/components/6444562_6444562.sldprt
Solidworks/CircuitWorks/BUILT-BY-CIRCUITWORKS/components/6444563_6444563.sldprt
Solidworks/CircuitWorks/BUILT-BY-CIRCUITWORKS/components/6444564_6444564.sldprt
Solidworks/CircuitWorks/BUILT-BY-CIRCUITWORKS/components/8775808_8775808.sldprt
Solidworks/CircuitWorks/BUILT-BY-CIRCUITWORKS/components/901310123_901310123.sldprt
Solidworks/CircuitWorks/BUILT-BY-CIRCUITWORKS/components/901310124_901310124.sldprt
Solidworks/CircuitWorks/BUILT-BY-CIRCUITWORKS/components/ATTINY45TINY8520SMT_ATTINY45TINY8520SMT.sldprt
Solidworks/CircuitWorks/BUILT-BY-CIRCUITWORKS/components/ATmega 168.SLDPRT
Solidworks/CircuitWorks/BUILT-BY-CIRCUITWORKS/components/Axial0_4.SLDPRT
Solidworks/CircuitWorks/BUILT-BY-CIRCUITWORKS/components/Axial0_4_100K.SLDPRT
Solidworks/CircuitWorks/BUILT-BY-CIRCUITWORKS/components/Axial0_4_10K.SLDPRT
Solidworks/CircuitWorks/BUILT-BY-CIRCUITWORKS/components/Axial0_4_1K.SLDPRT
Solidworks/CircuitWorks/BUILT-BY-CIRCUITWORKS/components/Axial0_4_33K.SLDPRT
Solidworks/CircuitWorks/BUILT-BY-CIRCUITWORKS/components/Axial0_4_3K3.SLDPRT
Solidworks/CircuitWorks/BUILT-BY-CIRCUITWORKS/components/Axial0_4_47K.SLDPRT
Solidworks/CircuitWorks/BUILT-BY-CIRCUITWORKS/components/Axial0_4_4K7.SLDPRT
Solidworks/CircuitWorks/BUILT-BY-CIRCUITWORKS/components/B3B-ZR(LF)(SN).SLDPRT
Solidworks/CircuitWorks/BUILT-BY-CIRCUITWORKS/components/B4B-PH-SM4(LF)(SN).SLDPRT
Solidworks/CircuitWorks/BUILT-BY-CIRCUITWORKS/components/B4BZRSM4TF_B4BZRSM4TF.sldprt
Solidworks/CircuitWorks/BUILT-BY-CIRCUITWORKS/components/B6B-ZR-SM4-TF.SLDPRT
Solidworks/CircuitWorks/BUILT-BY-CIRCUITWORKS/components/B8B-PH-SM4.SLDPRT
Solidworks/CircuitWorks/BUILT-BY-CIRCUITWORKS/components/B8BZRSM4TF_B8BZRSM4TF.sldprt
Solidworks/CircuitWorks/BUILT-BY-CIRCUITWORKS/components/BA.SLDPRT
Solidworks/CircuitWorks/BUILT-BY-CIRCUITWORKS/components/BD1_DBRIDGE.sldprt
Solidworks/CircuitWorks/BUILT-BY-CIRCUITWORKS/components/BNC.SLDPRT
Solidworks/CircuitWorks/BUILT-BY-CIRCUITWORKS/components/BQ294700_BQ294700.sldprt
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
