MathiasKoch/roberto_mechanical/Solidworks/Drawings/pdf/hjulophæng_p2.PDF

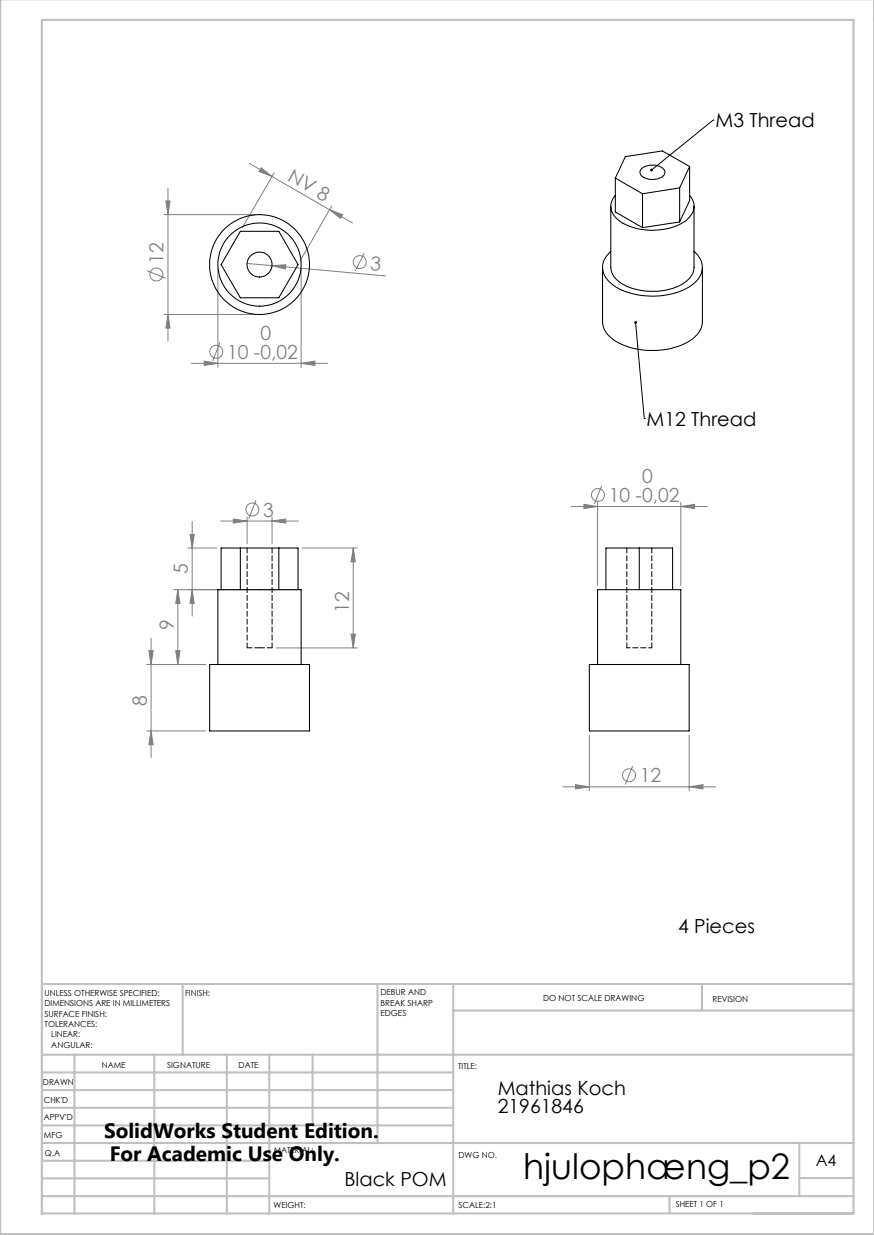
[picture p87: page 1]
M3 Thread; M12 Thread; 4 Pieces; SCALE:2:1; SHEET 1 OF 1; DO NOT SCALE DRAWING; REVISION; DEBUR AND BREAK SHARP; UNLESS OTHERWISE SPECIFIED:; FINISH:

DIMENSIONS ARE IN MILLIMETERS
SURFACE FINISH:
TOLERANCES:
LINEAR:
ANGULAR:

NAME | SIGNATURE | DATE | | | | TITLE: Mathias Koch 21961846

DRAWN
CHK'D
APPV'D
MFG | SolidWorks Student Edition.
Q.A | For Academic Use Only. | | | MATERIAL: Black POM | hjulophæng_p2 WEIGHT: DWG NO. | A4
