MathiasKoch/roberto_mechanical/Solidworks/Drawings/pdf/magnet_mount.PDF

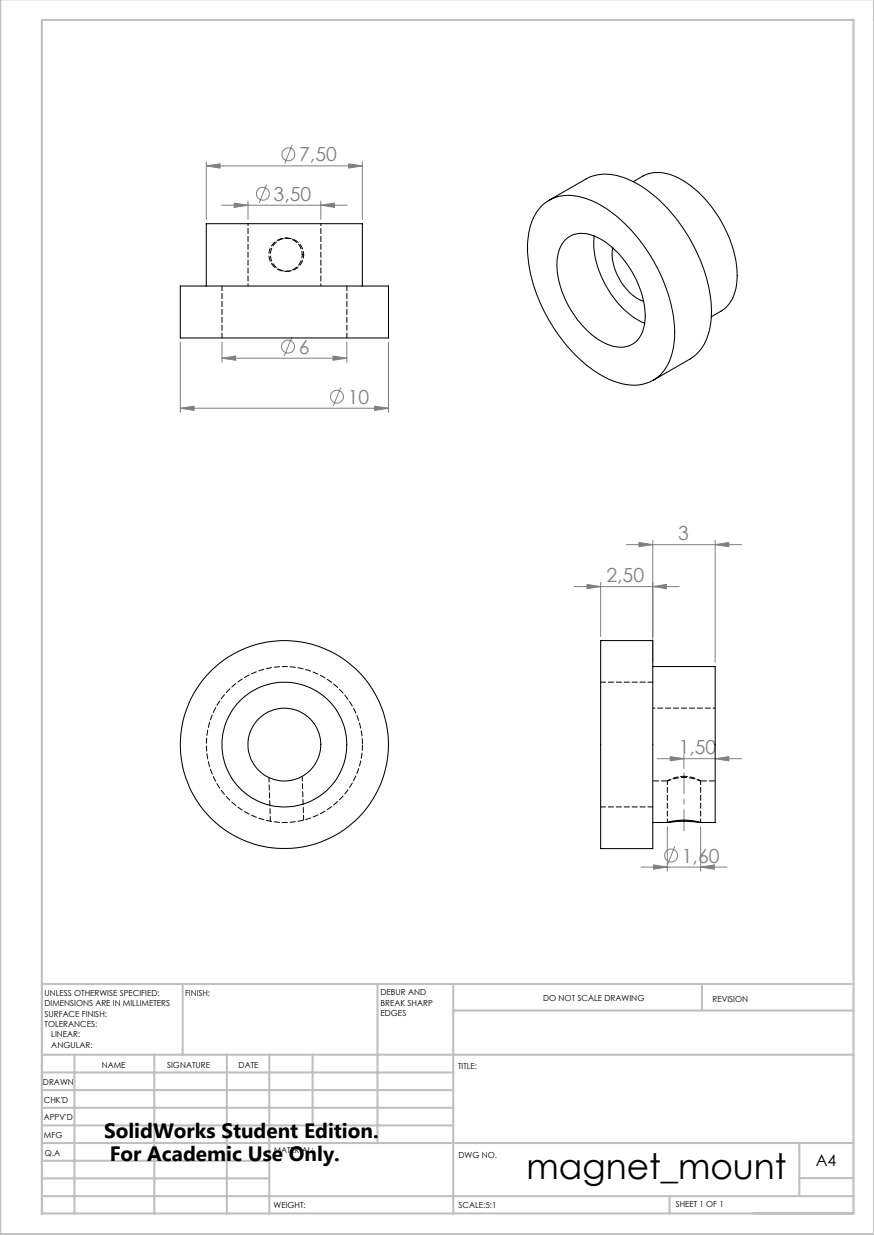
[picture p88: page 1]
SCALE:5:1; SHEET 1 OF 1; DO NOT SCALE DRAWING; REVISION; DEBUR AND BREAK SHARP; UNLESS OTHERWISE SPECIFIED:; FINISH:

DIMENSIONS ARE IN MILLIMETERS
SURFACE FINISH:
TOLERANCES:
LINEAR:
ANGULAR:

NAME | SIGNATURE | DATE | | | | TITLE:
Q.A | For Academic Use Only. | | | MATERIAL: | magnet_mount WEIGHT: DWG NO. | A4

DRAWN
CHK'D
APPV'D
MFG | SolidWorks Student Edition.
