MathiasKoch/roberto_mechanical/DipTrace/PDF/Buttons_v2.pdf

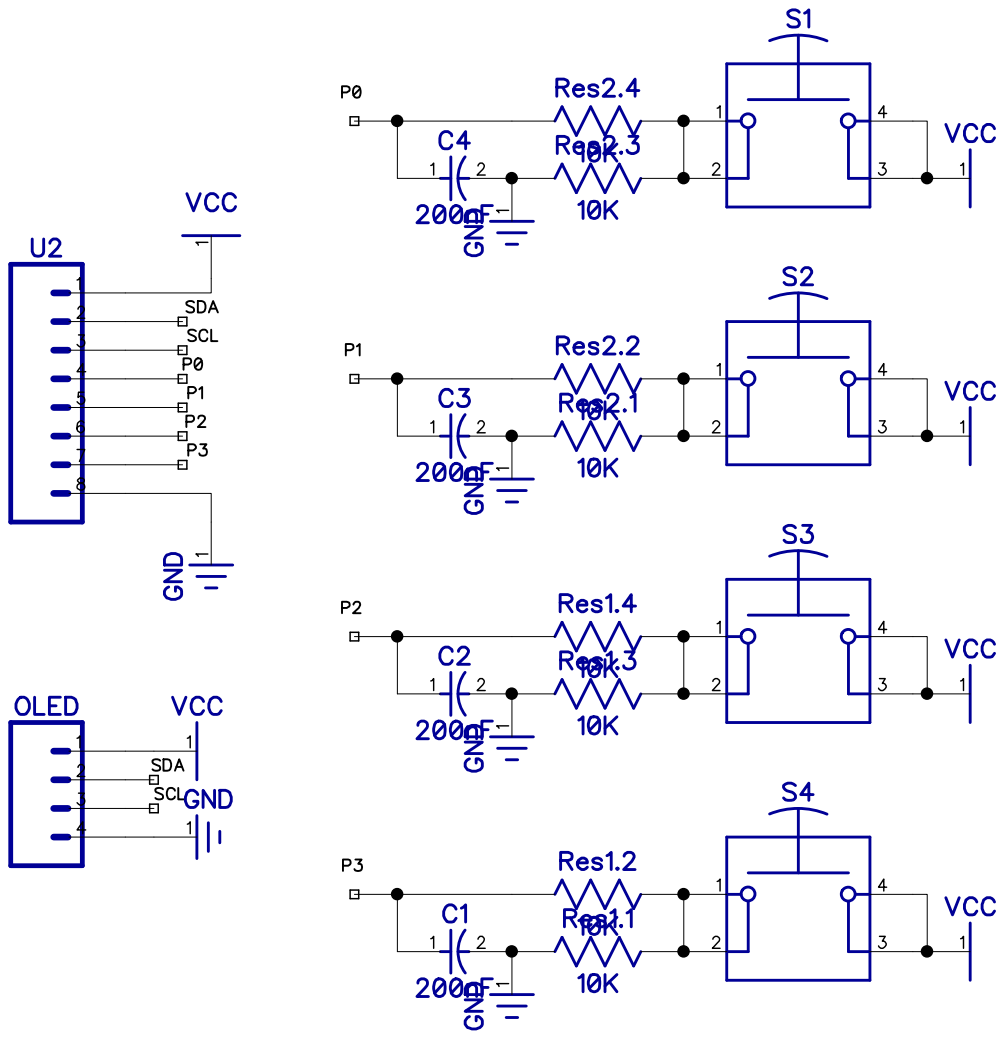
[picture p89: page 1]
