MathiasKoch/roberto_mechanical/DipTrace/PDF/Charger_v5.pdf

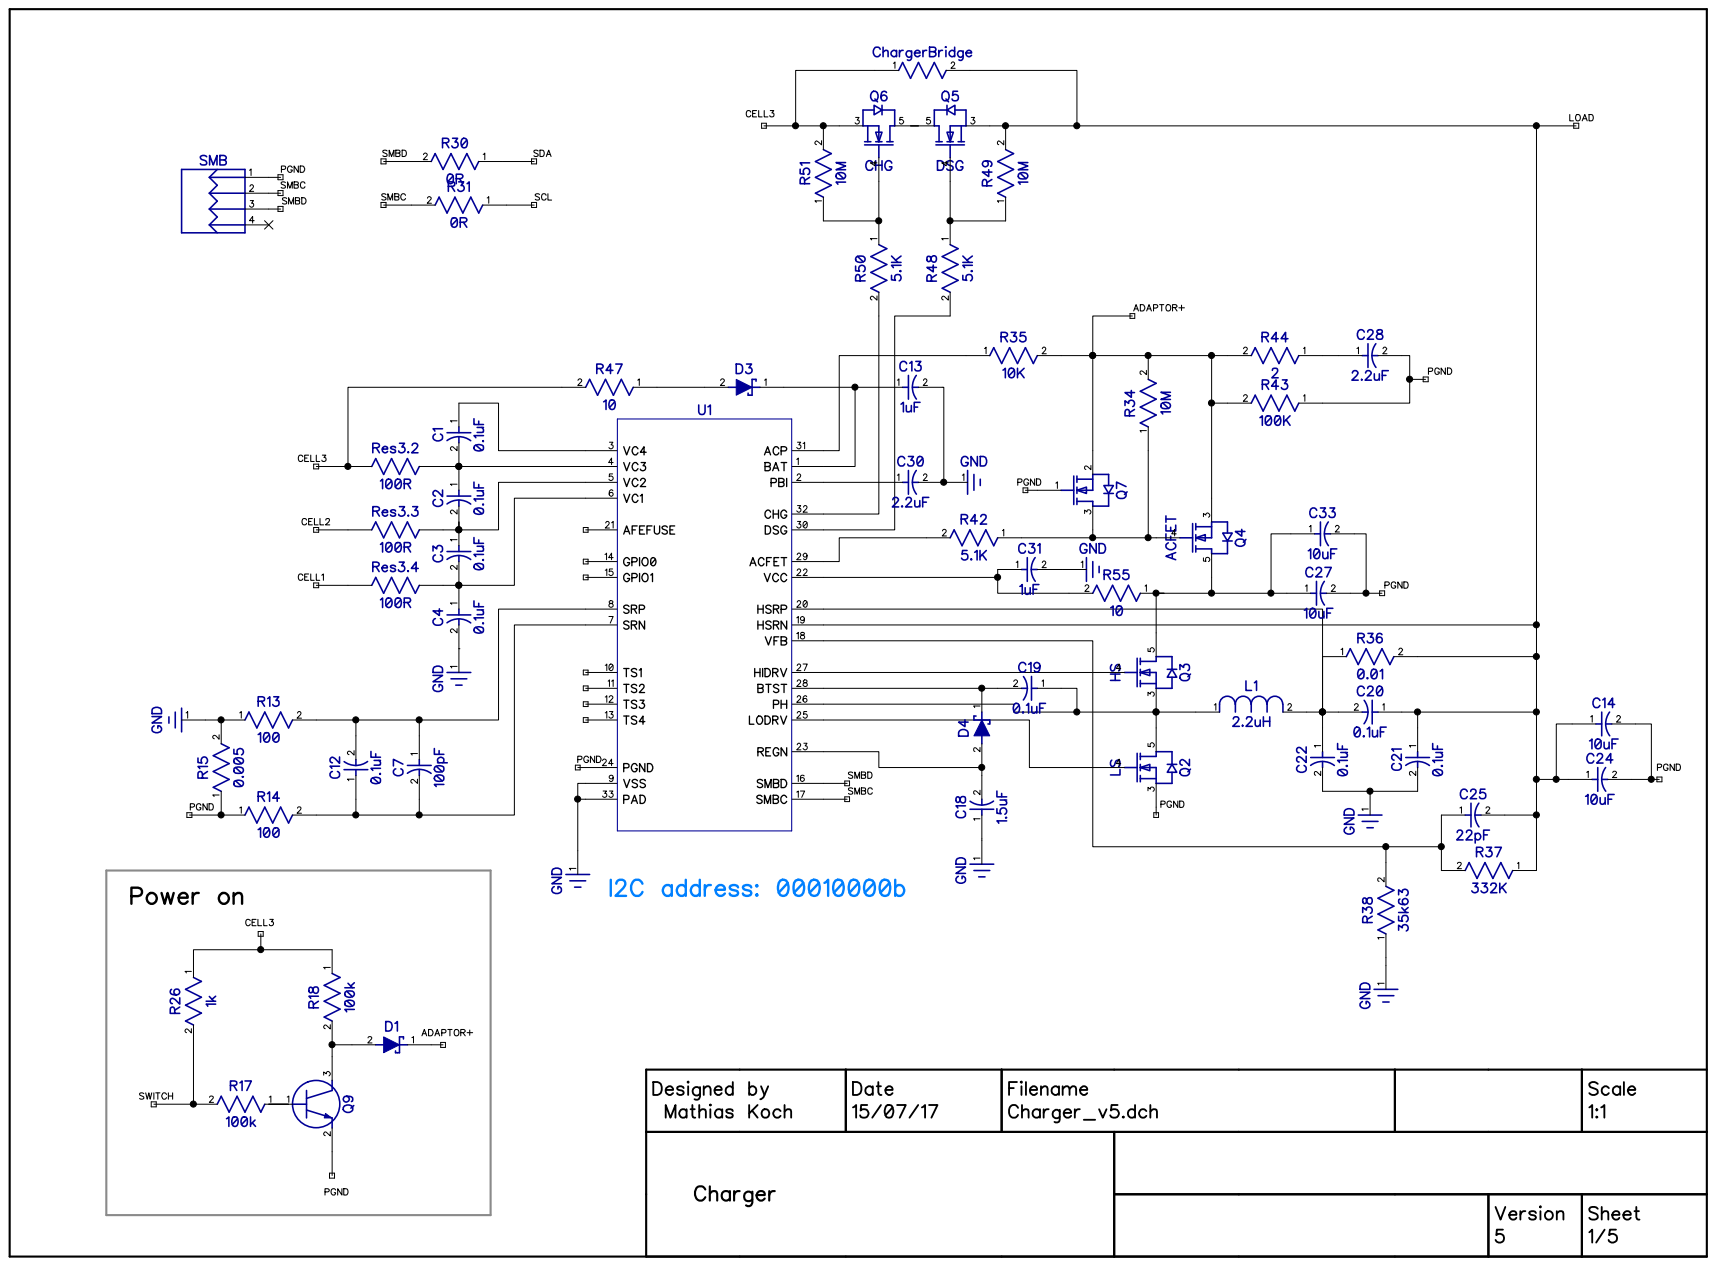
[picture p90: page 1]

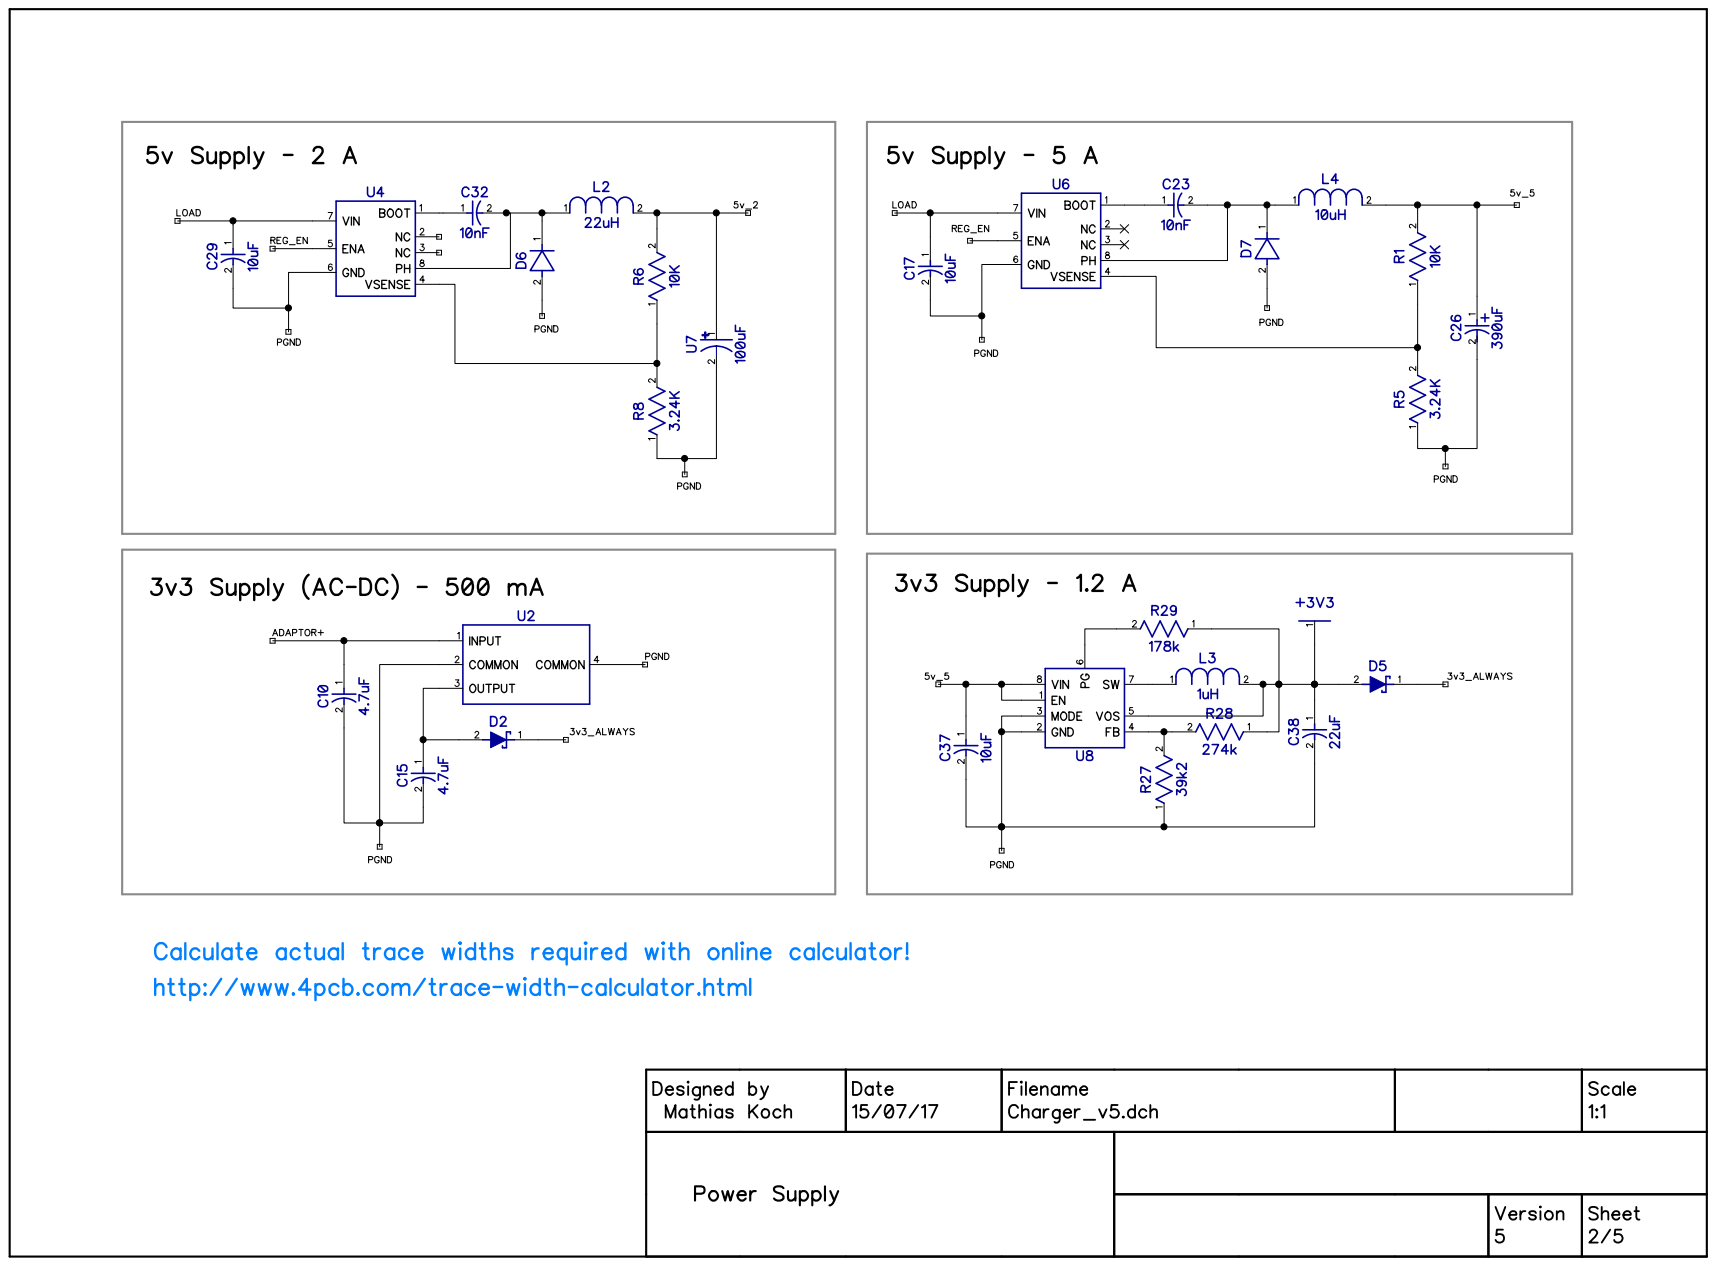
[picture p91: page 2]

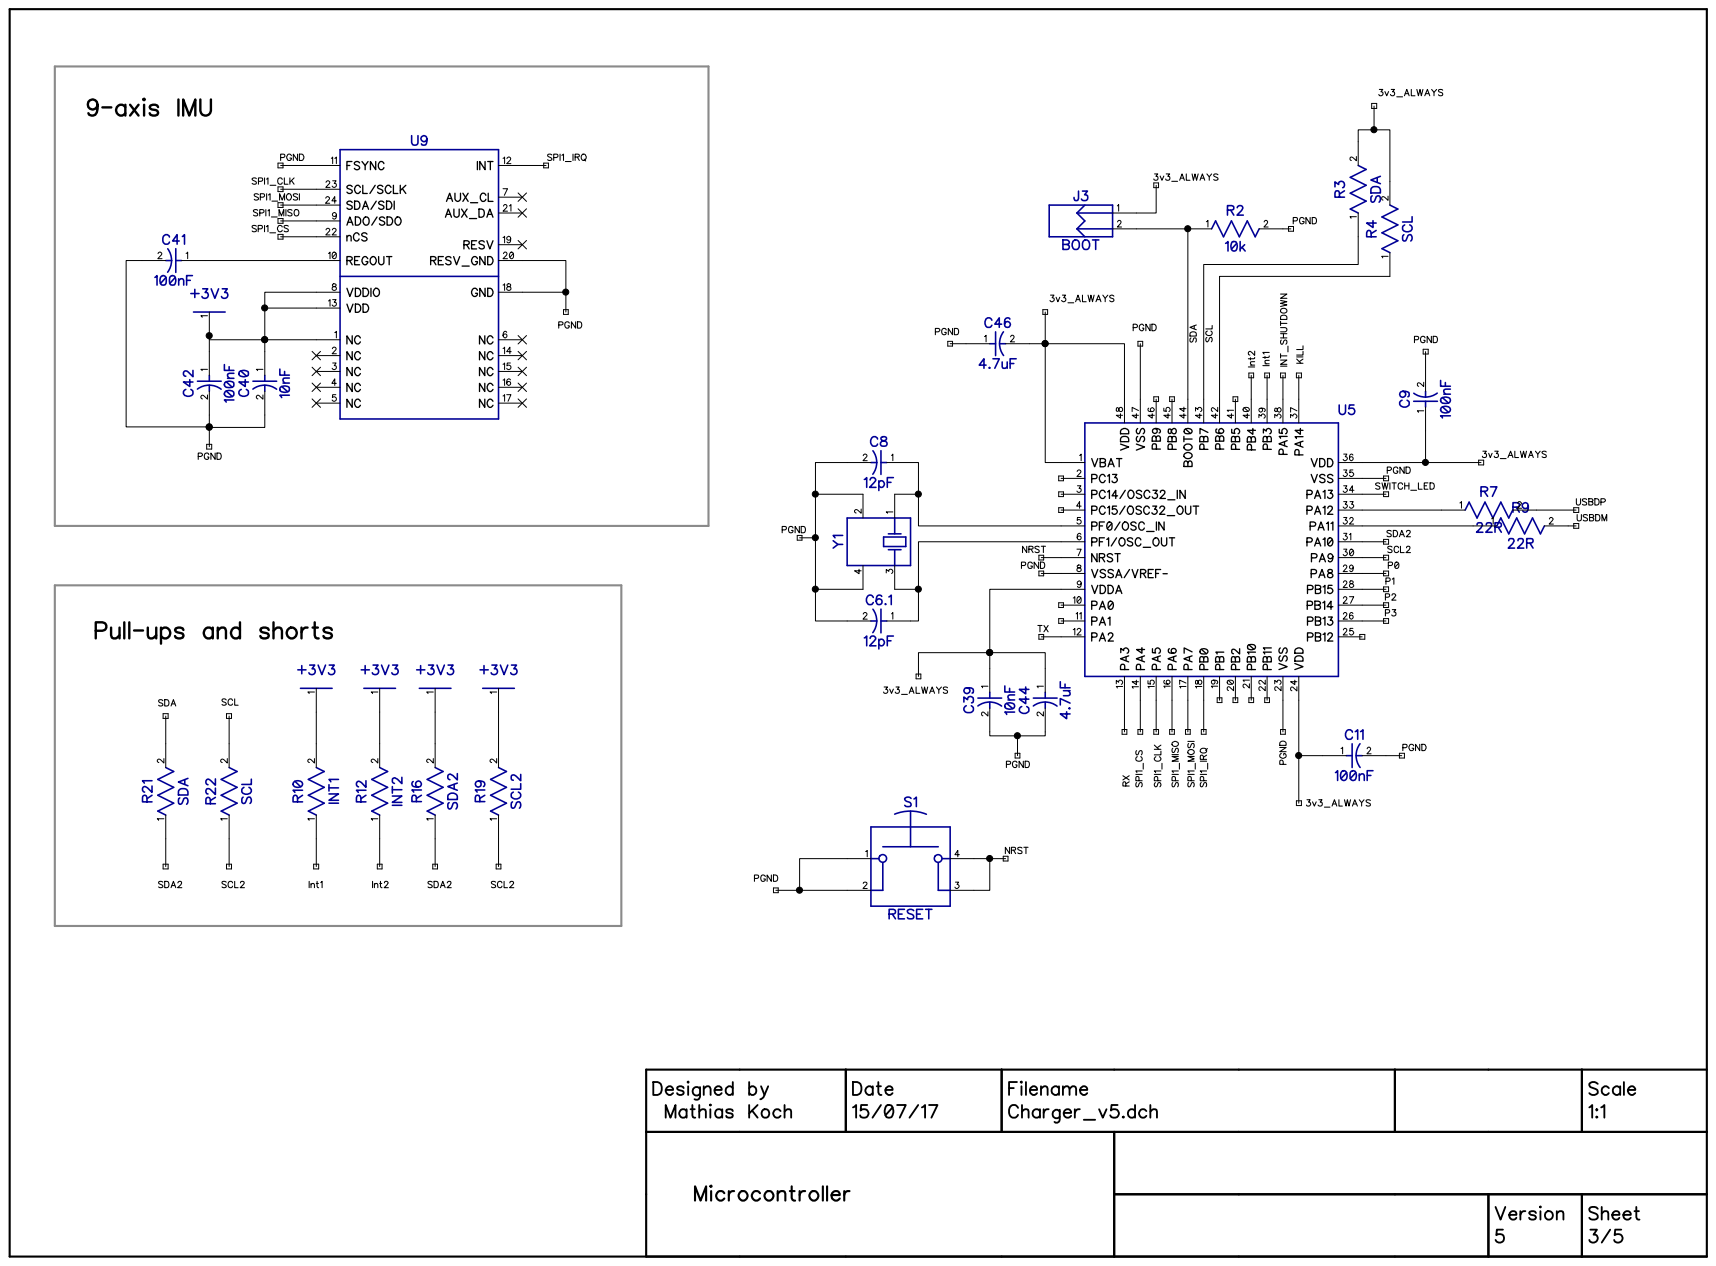
[picture p92: page 3]

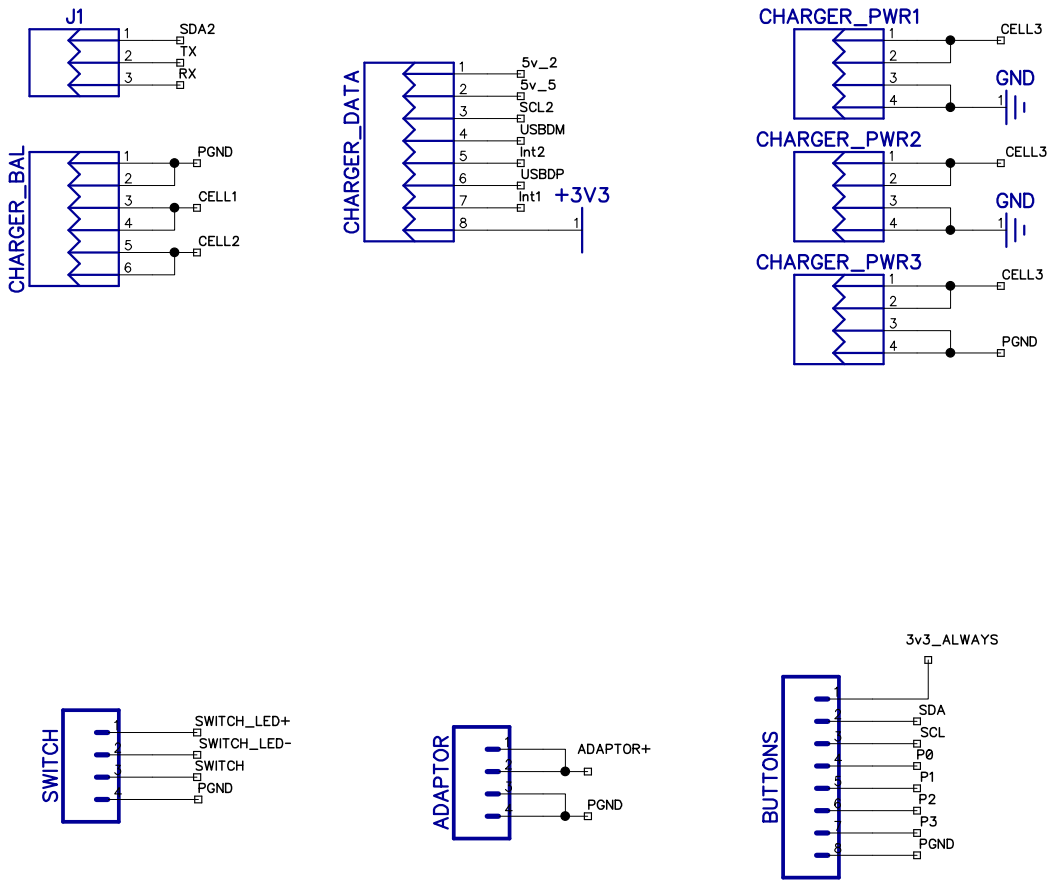
[picture p93: page 4]

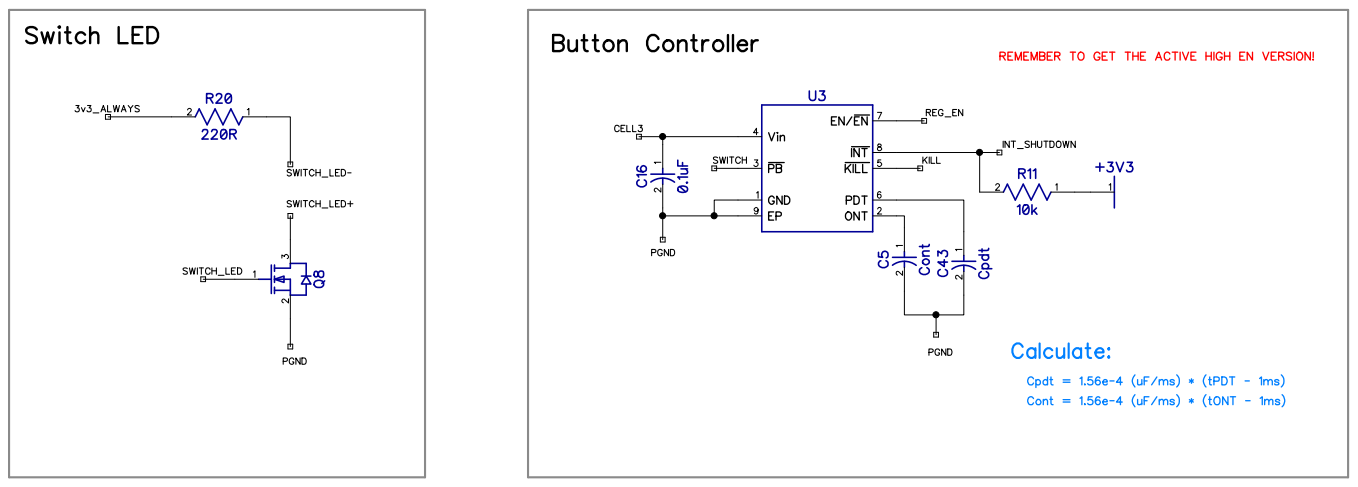
[picture p94: page 5]
