MathiasKoch/roberto_mechanical/DipTrace/PDF/Distribution_v3.pdf

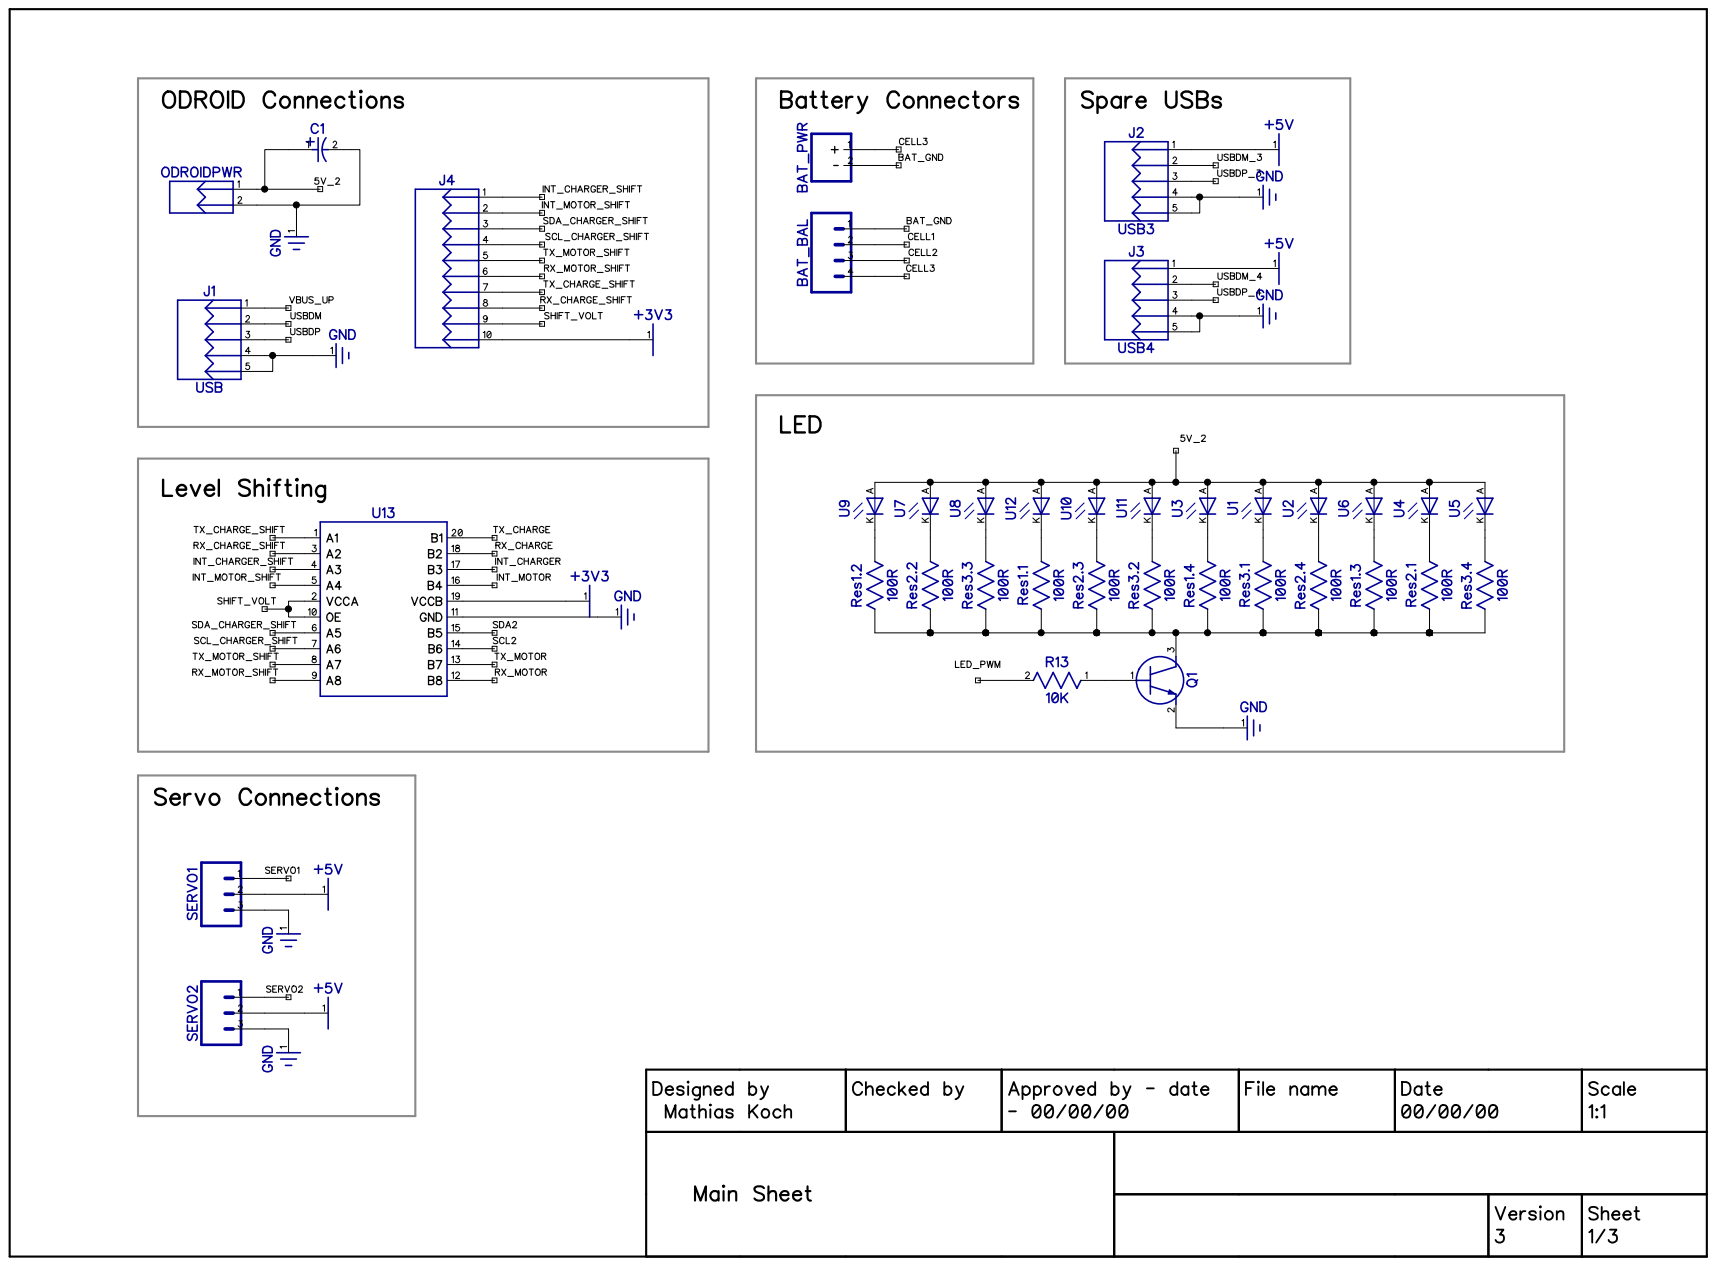
[picture p95: page 1]

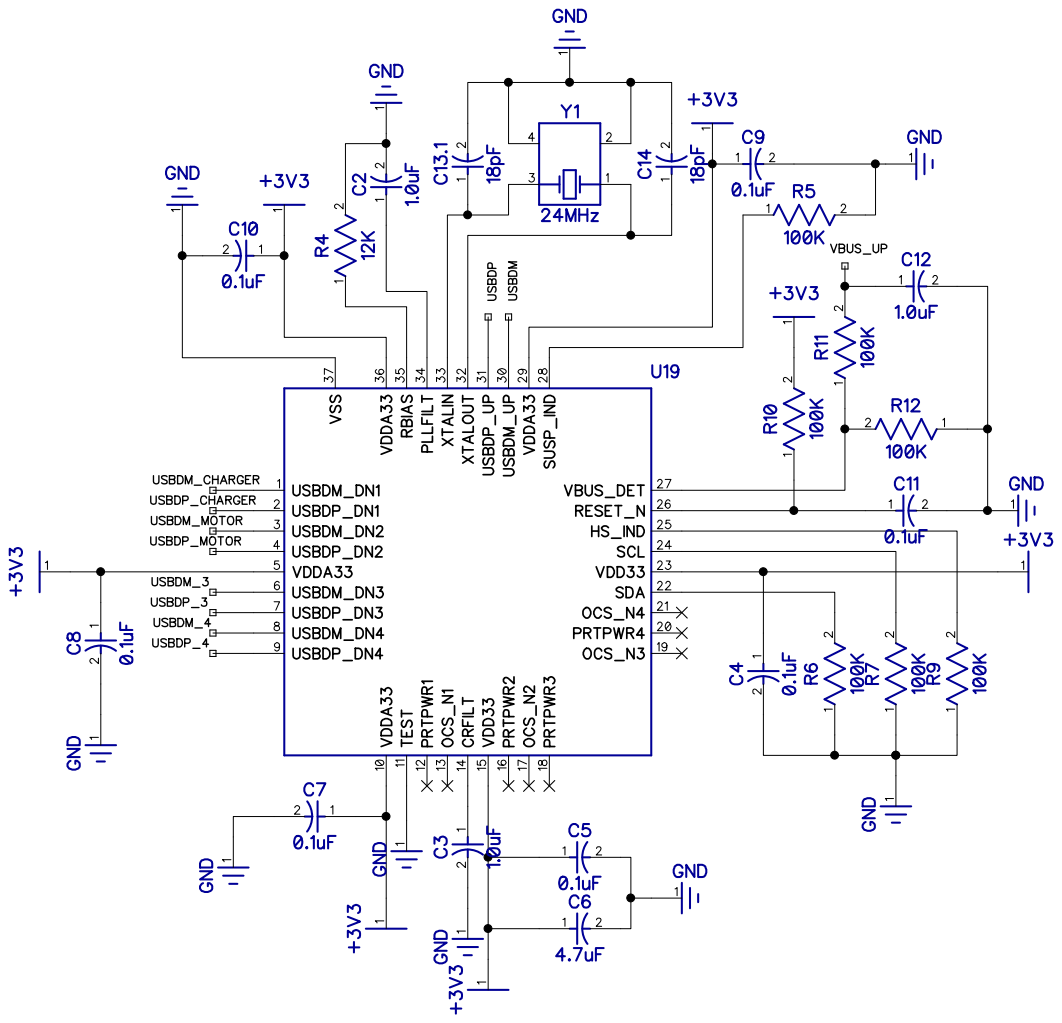
[picture p96: page 2]

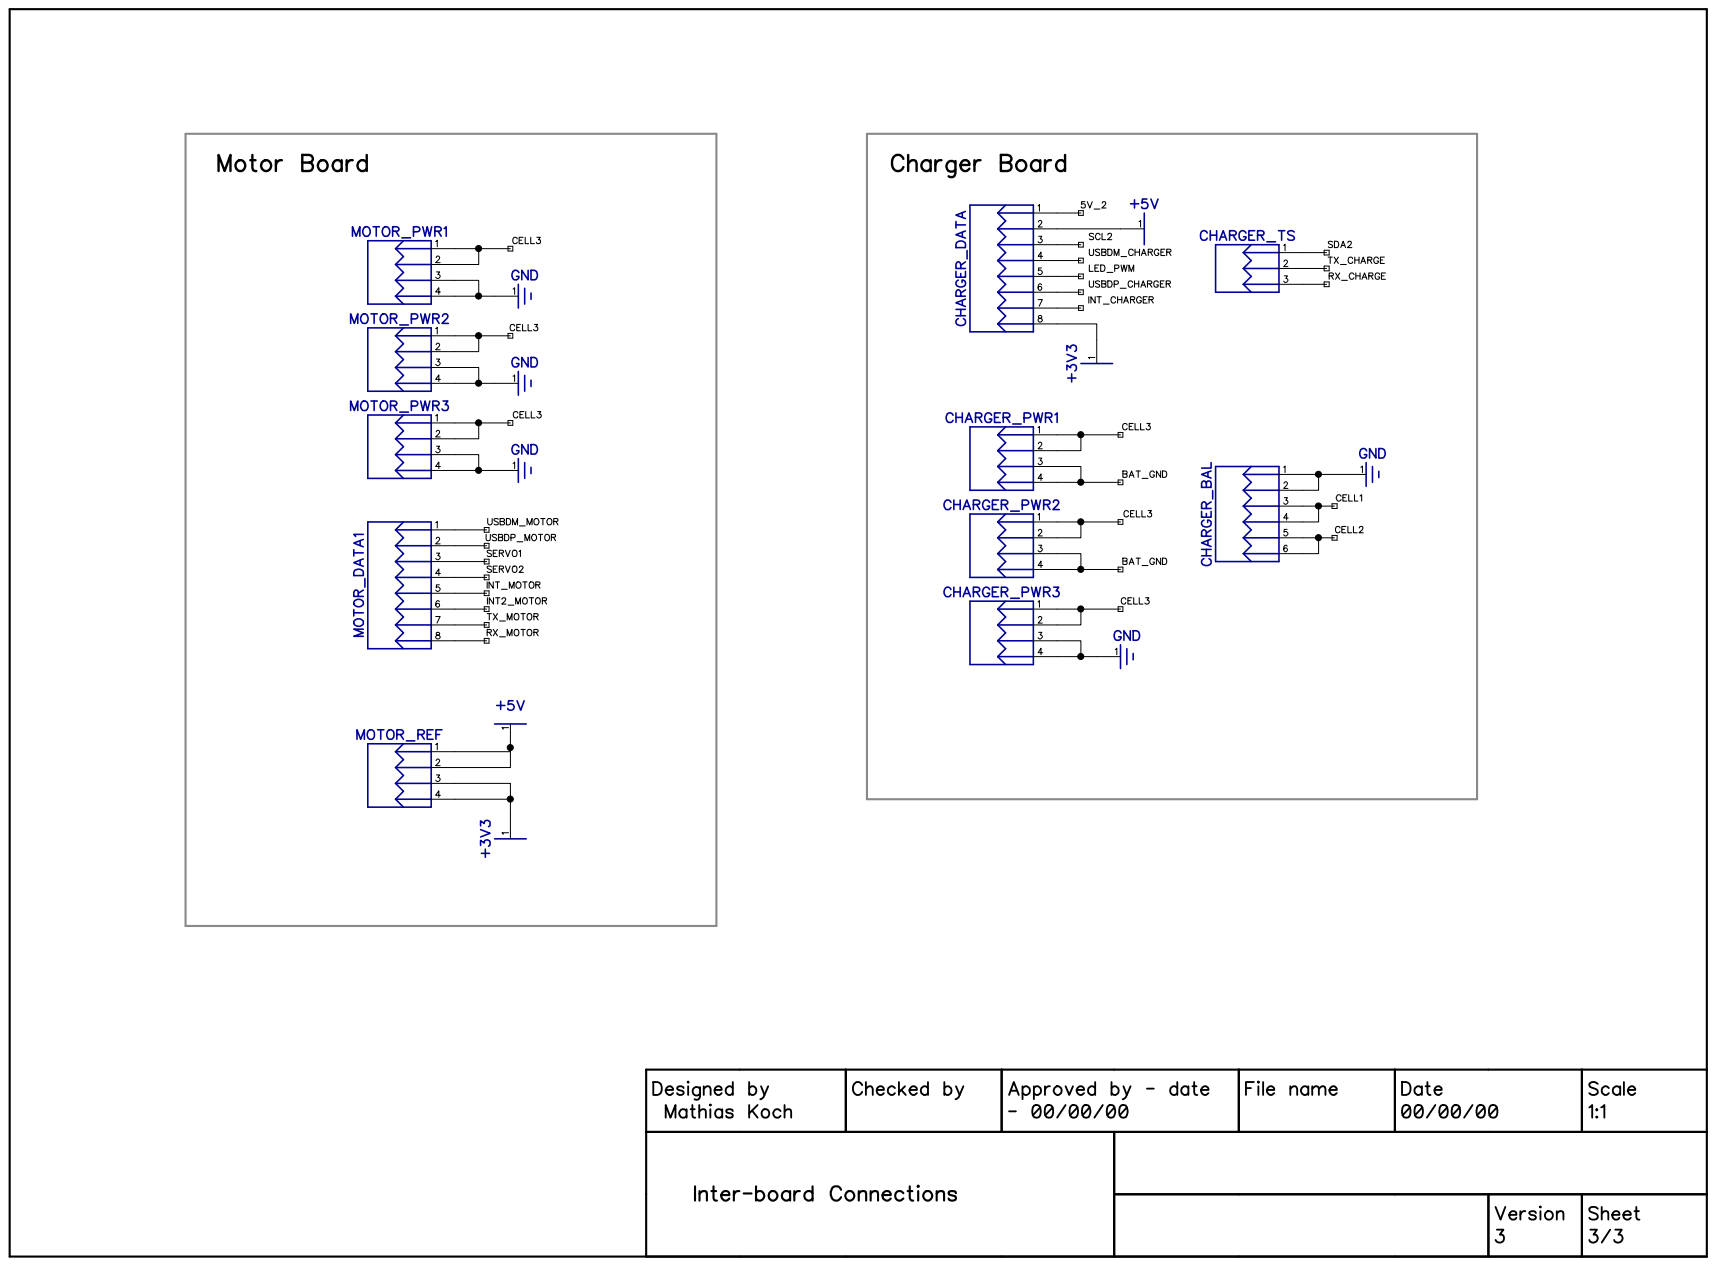
[picture p97: page 3]
