MathiasKoch/roberto_mechanical/DipTrace/PDF/Motor_v5.pdf

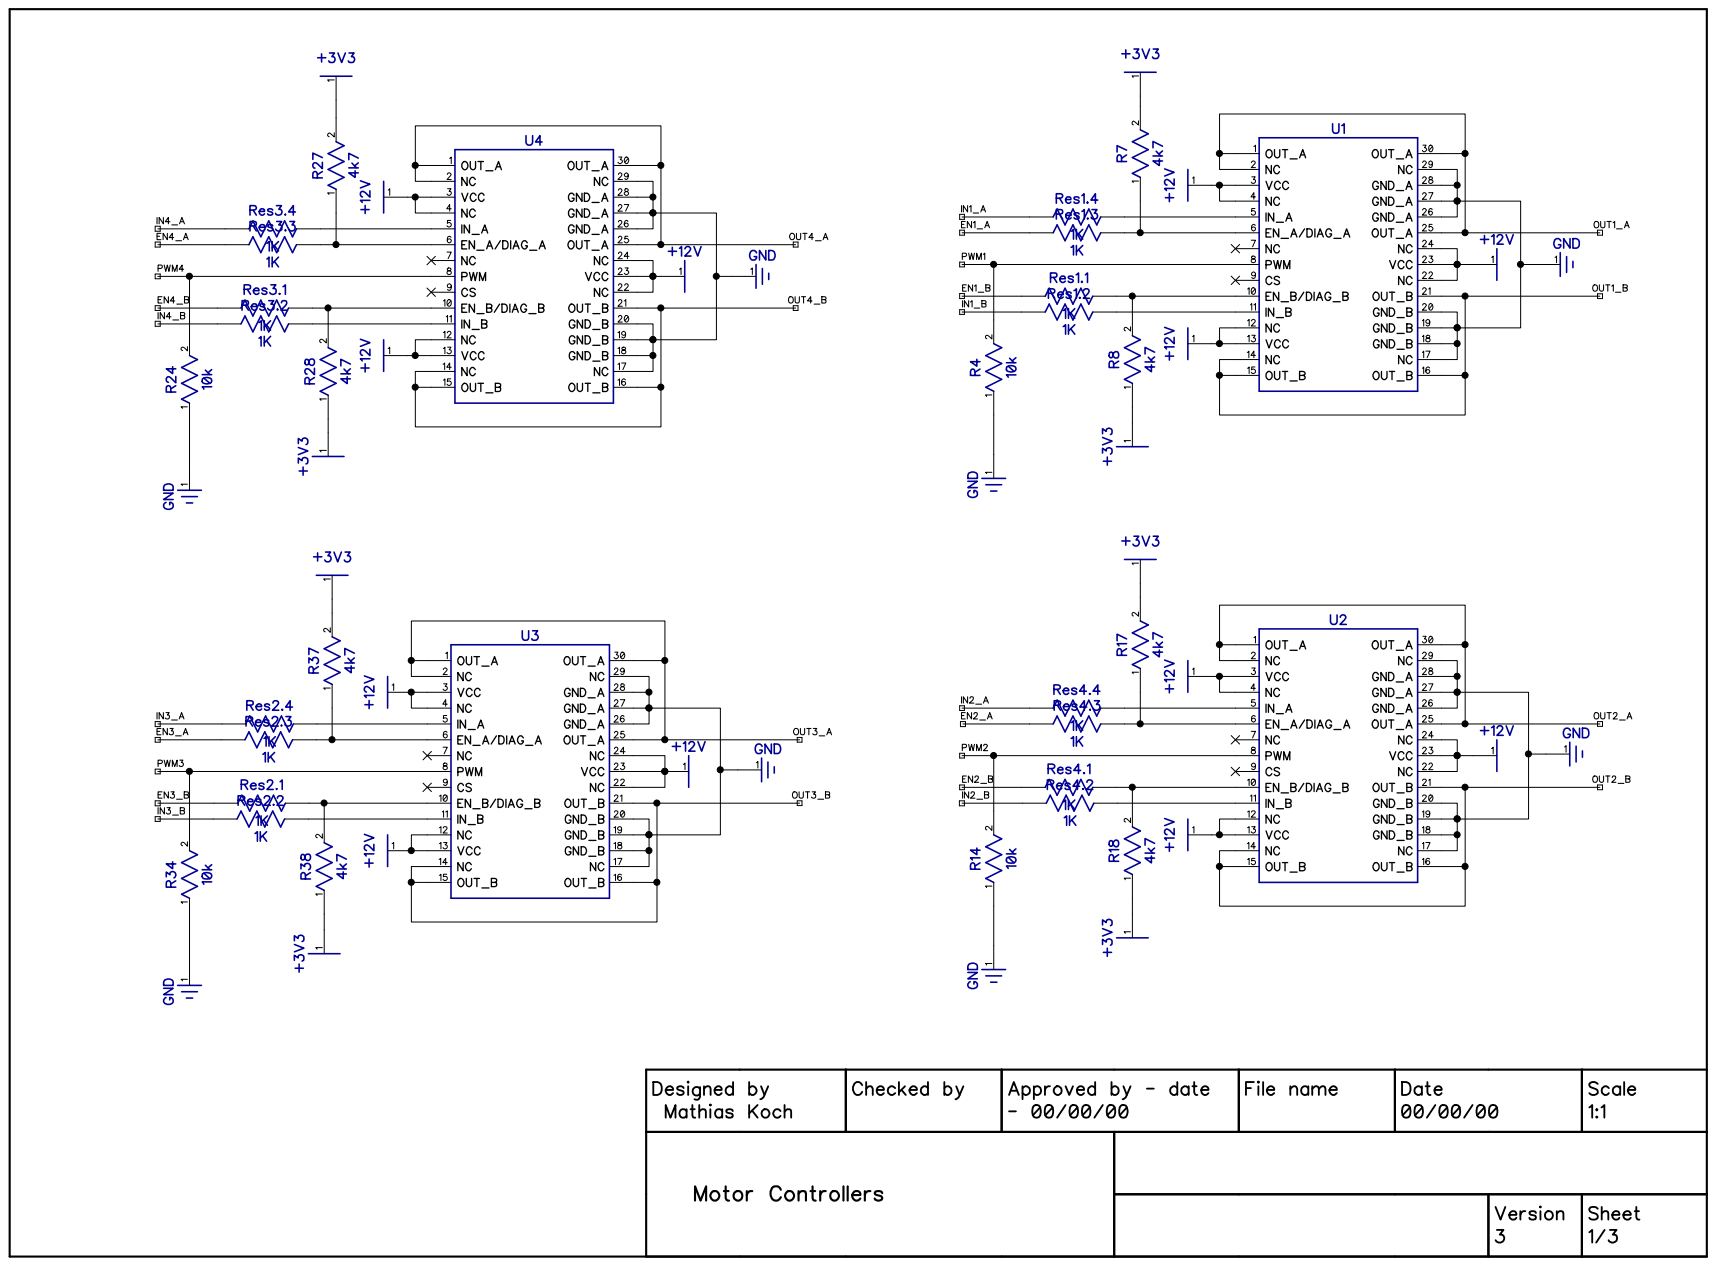
[picture p98: page 1]

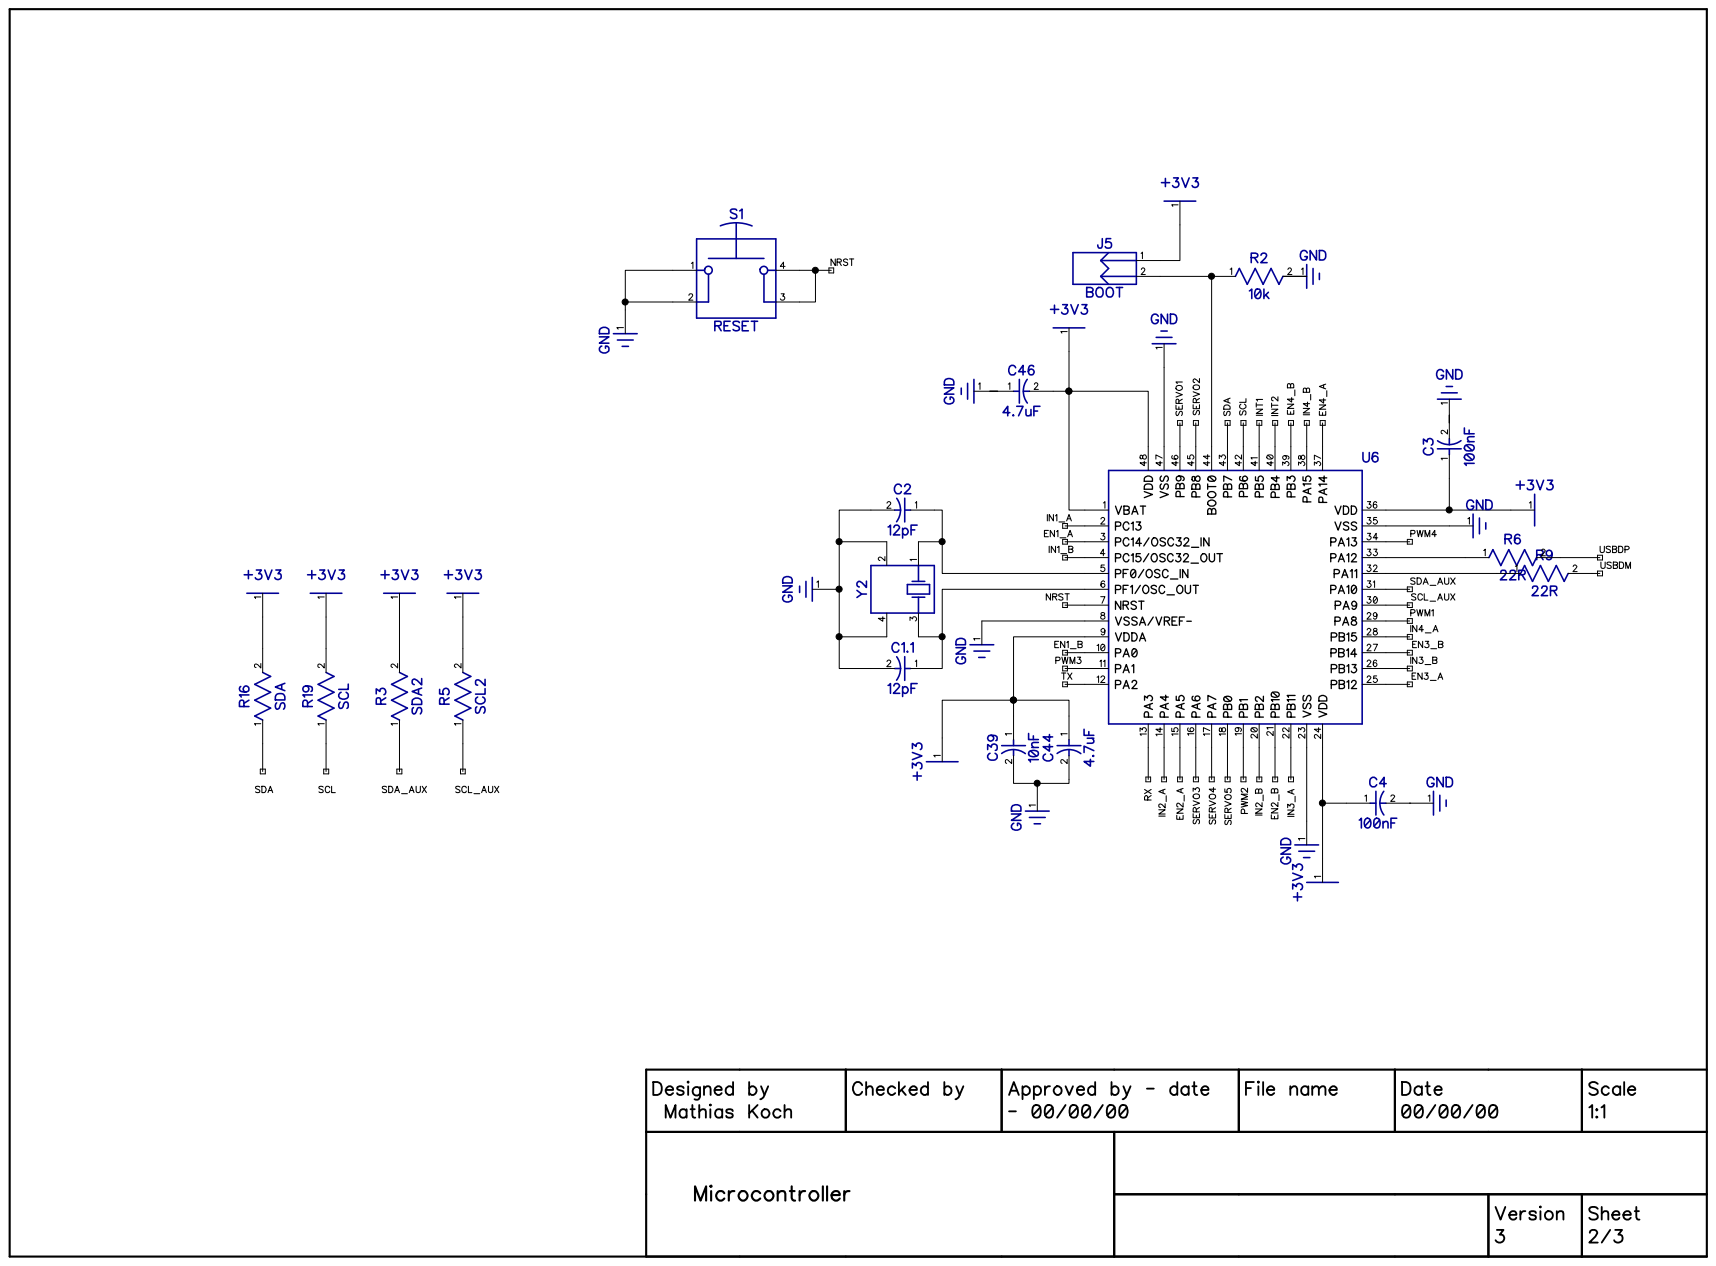
[picture p99: page 2]

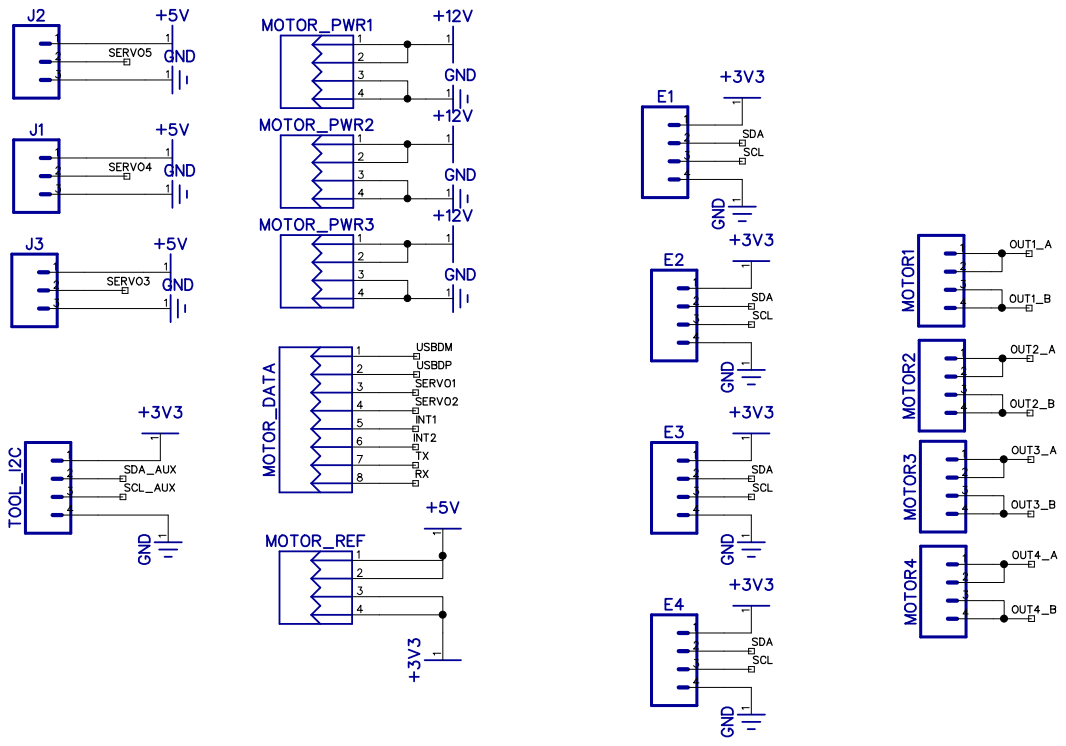
[picture p100: page 3]
