MathiasKoch/roberto_mechanical/Solidworks/Discarded/LCD_front.PDF

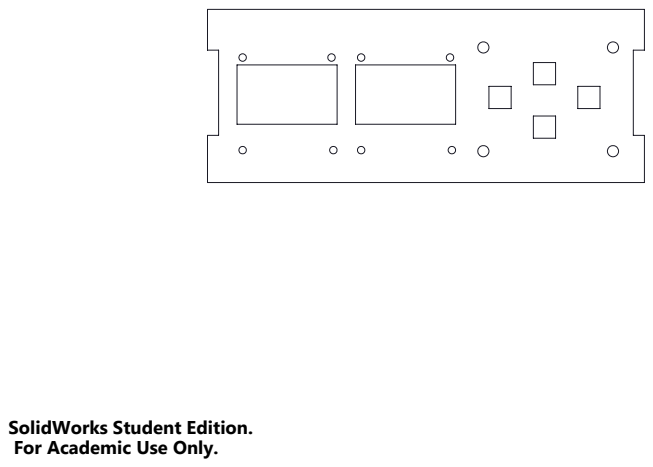
[picture p101: page 1]

SolidWorks Student Edition.
For Academic Use Only.
