MathiasKoch/roberto_mechanical/Solidworks/Drawings/pdf/base_bottom_up.PDF

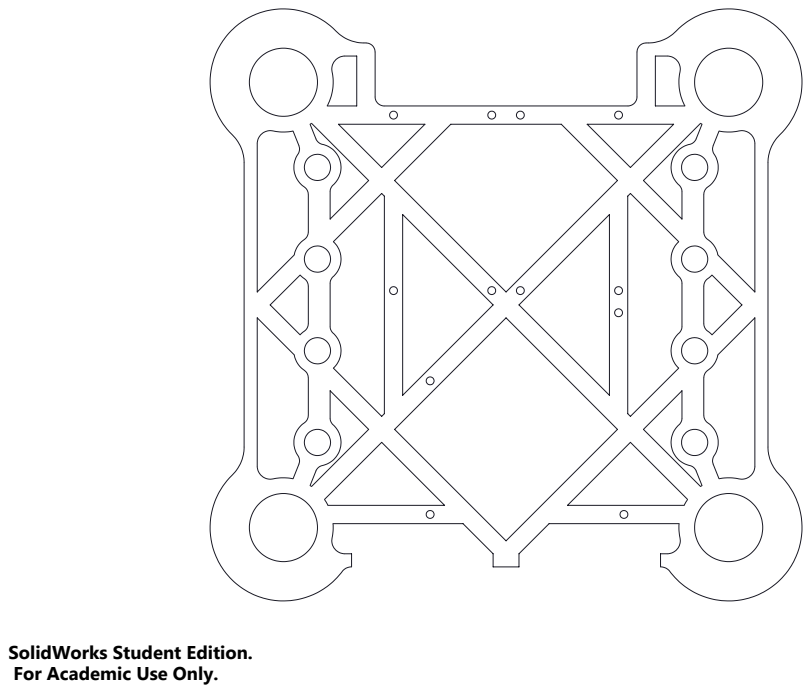
[picture p102: page 1]

SolidWorks Student Edition.
For Academic Use Only.
