MathiasKoch/roberto_mechanical/Solidworks/Drawings/pdf/camera_mount_v2.PDF

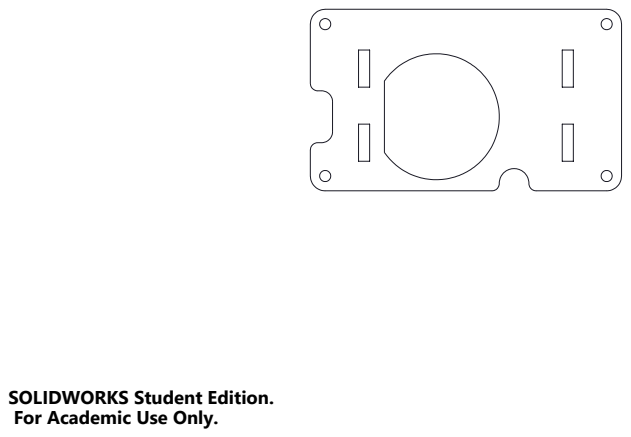
[picture p103: page 1]

SOLIDWORKS Student Edition.
For Academic Use Only.
