MathiasKoch/roberto_mechanical/Solidworks/Drawings/pdf/Draw11.PDF

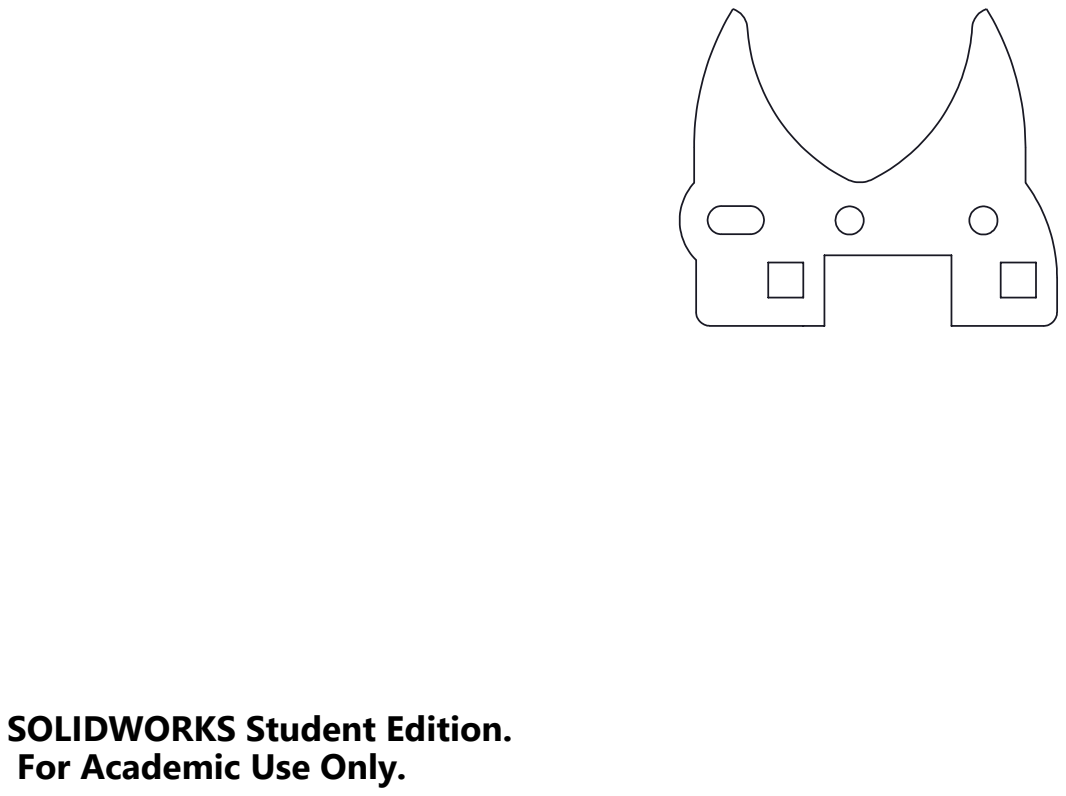
[picture p104: page 1]

SOLIDWORKS Student Edition.
For Academic Use Only.
