MathiasKoch/roberto_mechanical/Solidworks/Drawings/pdf/Draw12.PDF

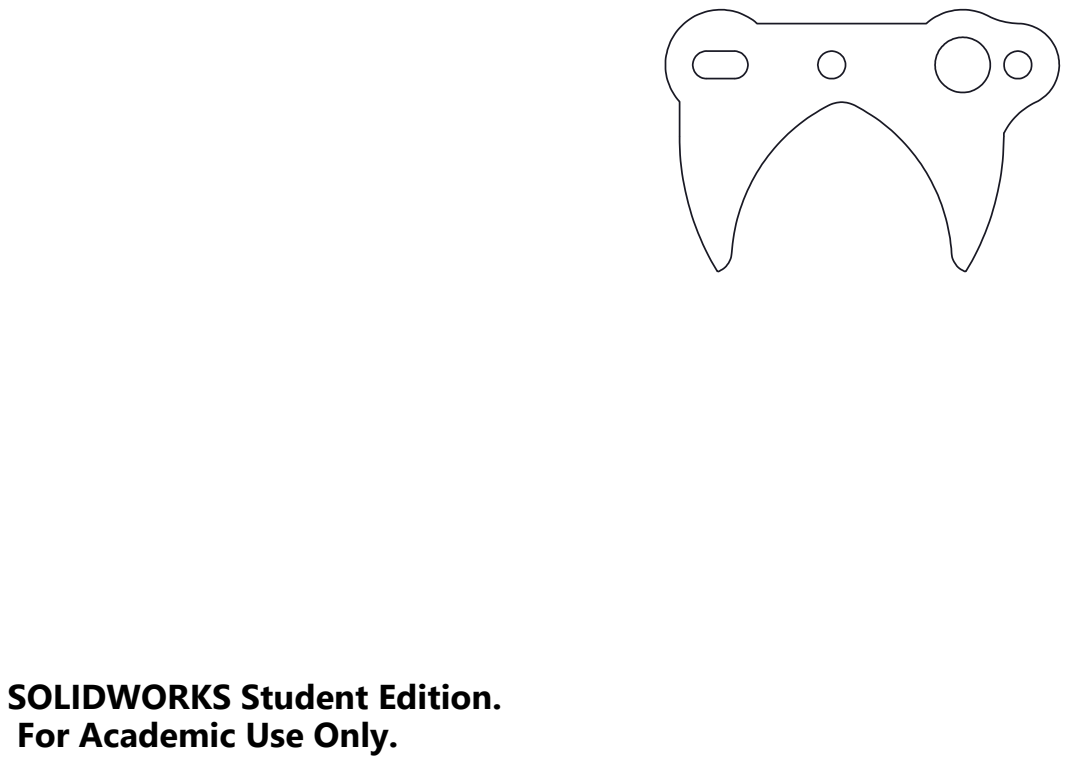
[picture p105: page 1]

SOLIDWORKS Student Edition.
For Academic Use Only.
