MathiasKoch/roberto_mechanical/Solidworks/Drawings/pdf/Draw13.PDF

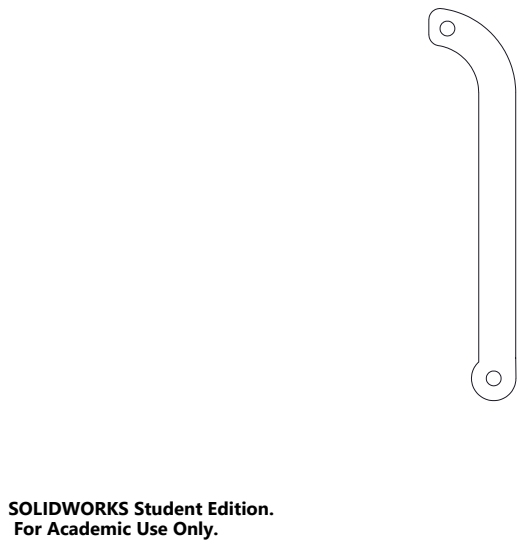
[picture p106: page 1]

SOLIDWORKS Student Edition.
For Academic Use Only.
