MathiasKoch/roberto_mechanical/Solidworks/Drawings/pdf/Draw14.PDF

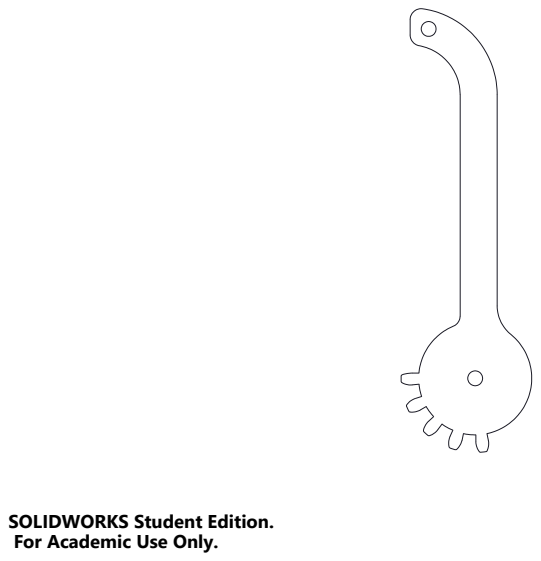
[picture p107: page 1]

SOLIDWORKS Student Edition.
For Academic Use Only.
