MathiasKoch/roberto_mechanical/Solidworks/Drawings/pdf/Draw15.PDF

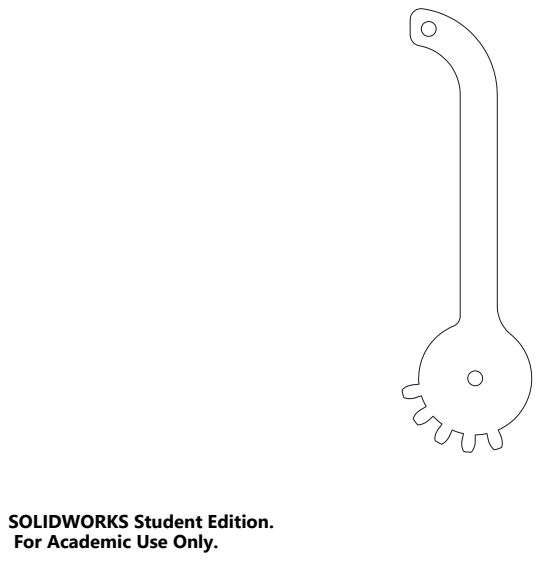
[picture p108: page 1]

SOLIDWORKS Student Edition.
For Academic Use Only.
