MathiasKoch/roberto_mechanical/Solidworks/Drawings/pdf/Draw16.PDF

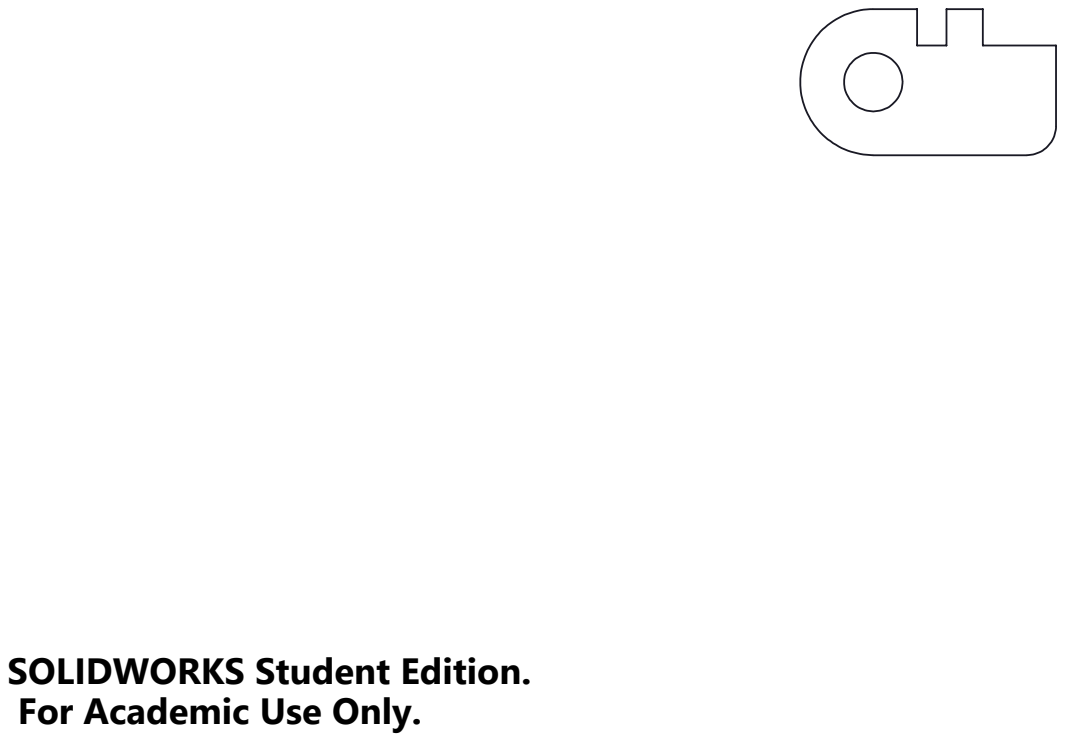
[picture p109: page 1]

SOLIDWORKS Student Edition.
For Academic Use Only.
