MathiasKoch/roberto_mechanical/Solidworks/Drawings/pdf/Draw17.PDF

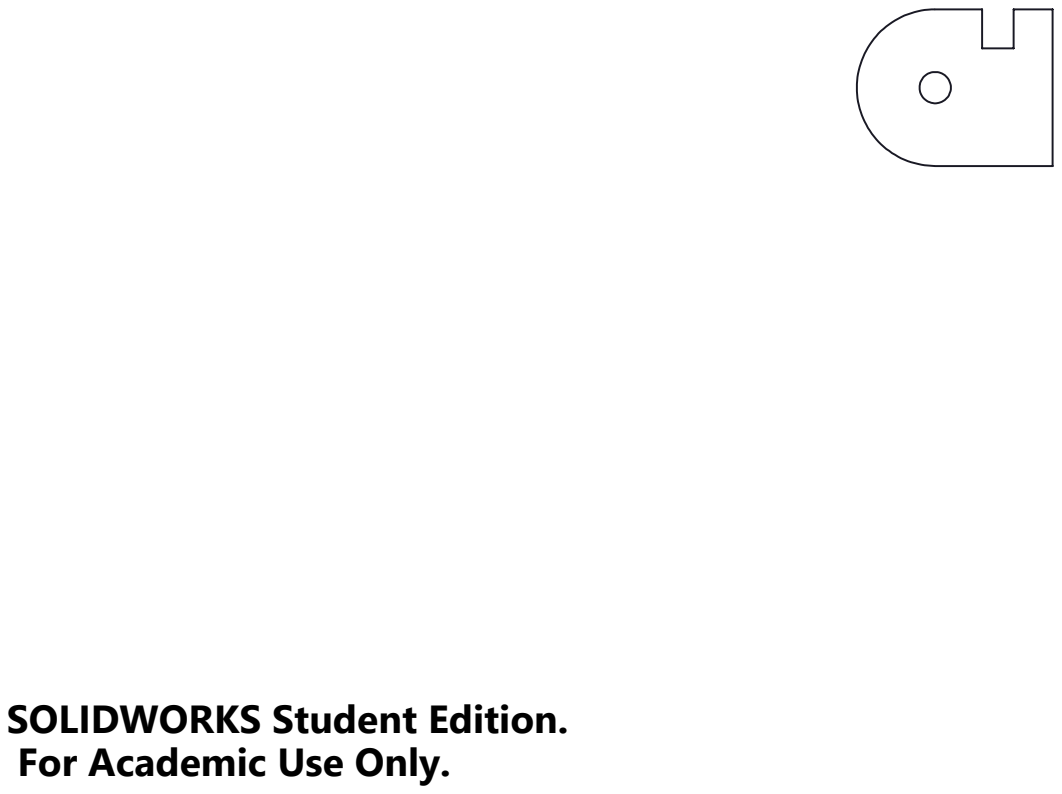
[picture p110: page 1]

SOLIDWORKS Student Edition.
For Academic Use Only.
