MathiasKoch/roberto_mechanical/Solidworks/Drawings/pdf/Draw18.PDF

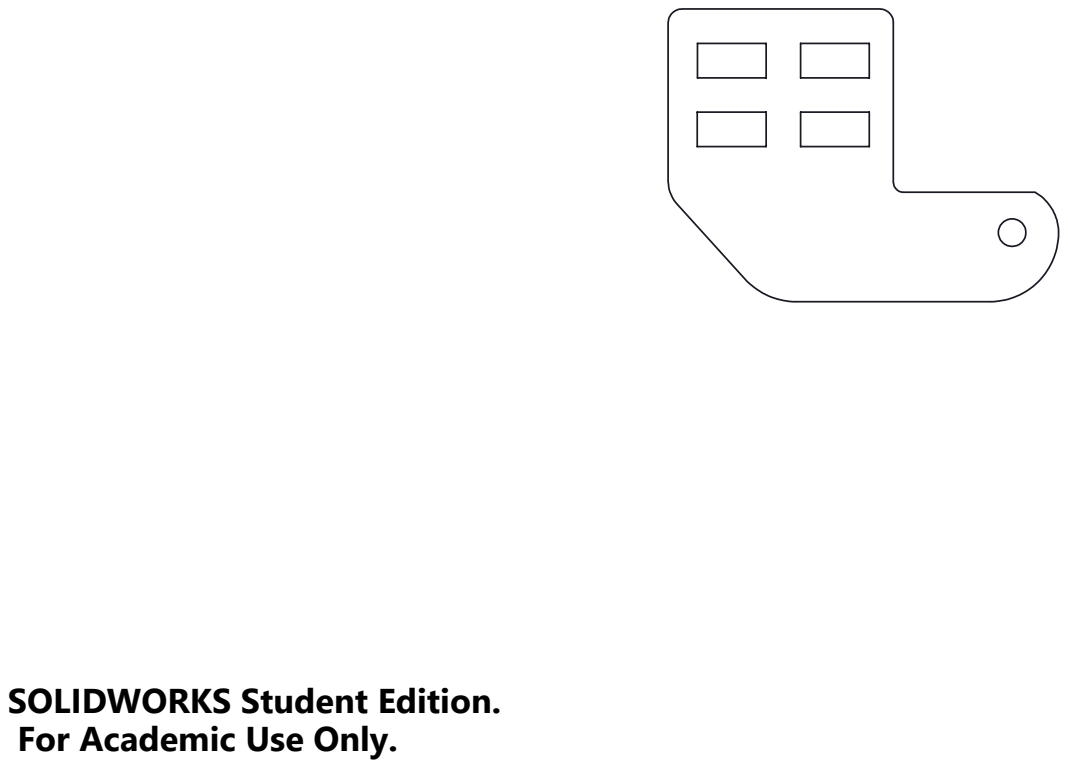
[picture p111: page 1]

SOLIDWORKS Student Edition.
For Academic Use Only.
