MathiasKoch/roberto_mechanical/Solidworks/Drawings/pdf/Draw19.PDF

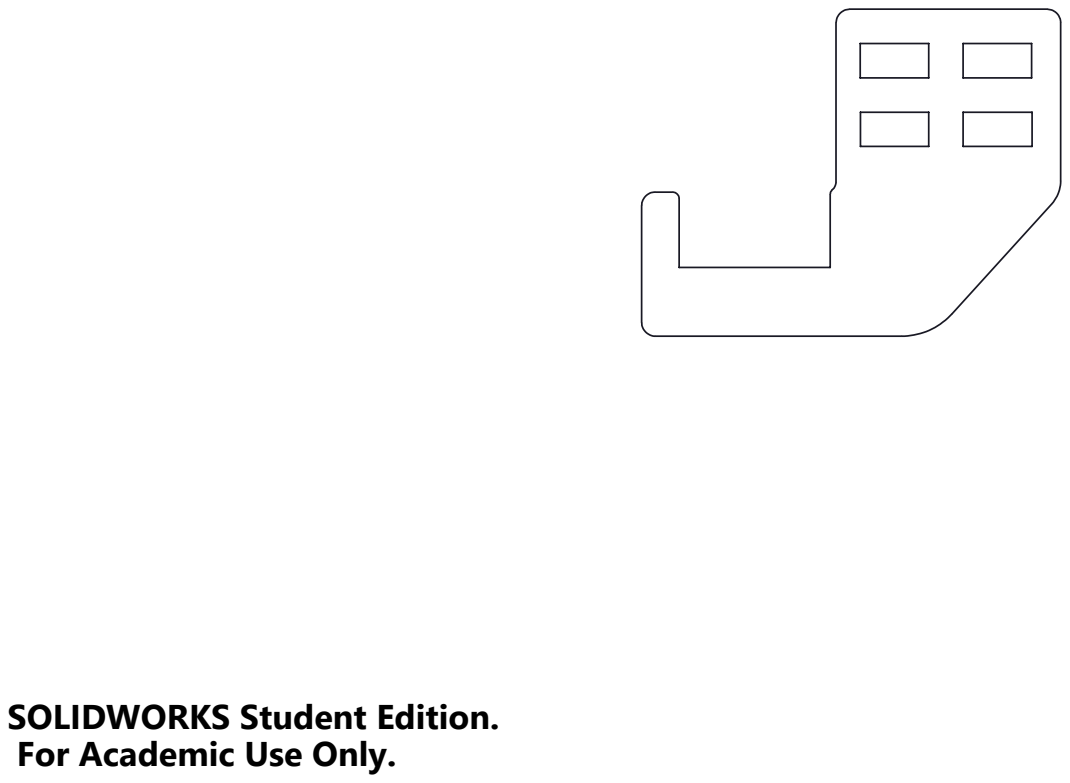
[picture p112: page 1]

SOLIDWORKS Student Edition.
For Academic Use Only.
