MathiasKoch/roberto_mechanical/Solidworks/Drawings/pdf/Draw20.PDF

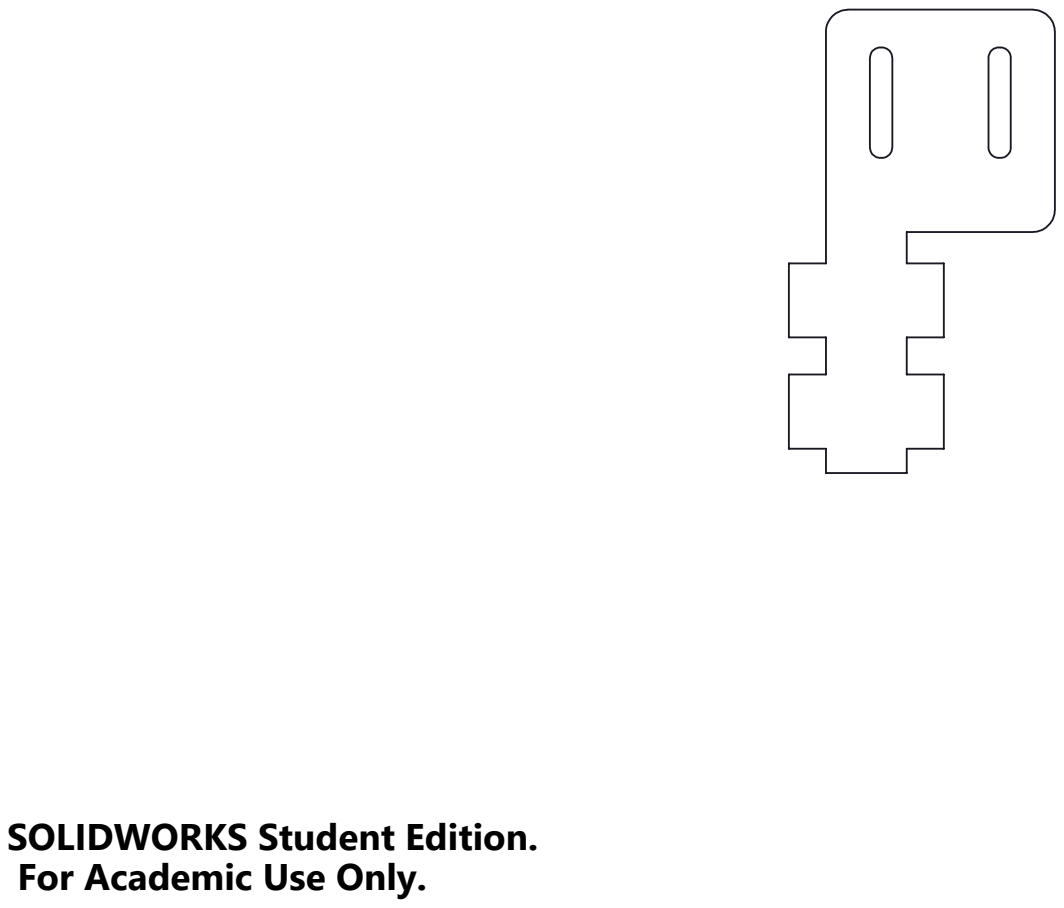
[picture p113: page 1]

SOLIDWORKS Student Edition.
For Academic Use Only.
