MathiasKoch/roberto_mechanical/Solidworks/Drawings/pdf/Draw3.PDF

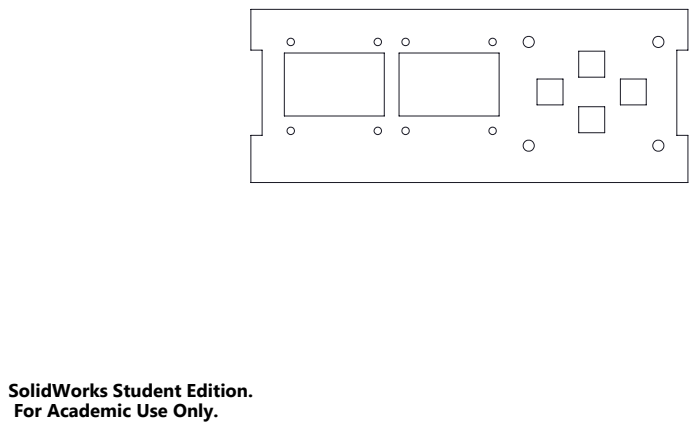
[picture p114: page 1]

SolidWorks Student Edition.
For Academic Use Only.
