MathiasKoch/roberto_mechanical/Solidworks/Drawings/pdf/Draw5.PDF

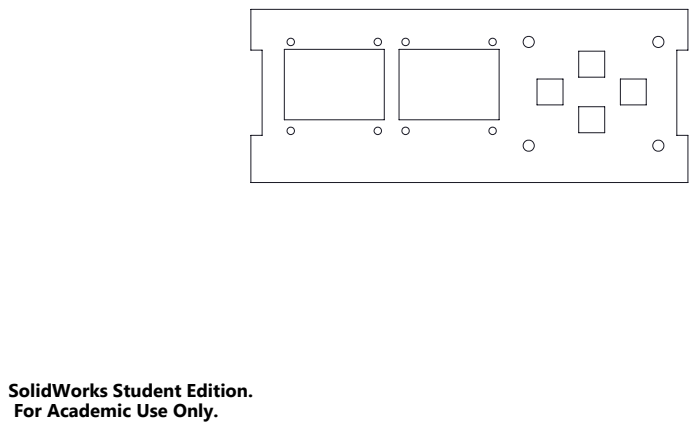
[picture p115: page 1]

SolidWorks Student Edition.
For Academic Use Only.
