MathiasKoch/roberto_mechanical/Solidworks/Drawings/pdf/Draw7.PDF

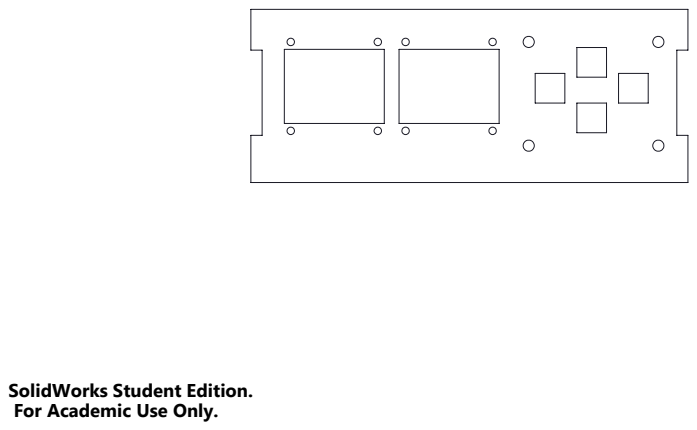
[picture p116: page 1]

SolidWorks Student Edition.
For Academic Use Only.
