MathiasKoch/roberto_mechanical/Solidworks/Drawings/pdf/hjulskive.pdf

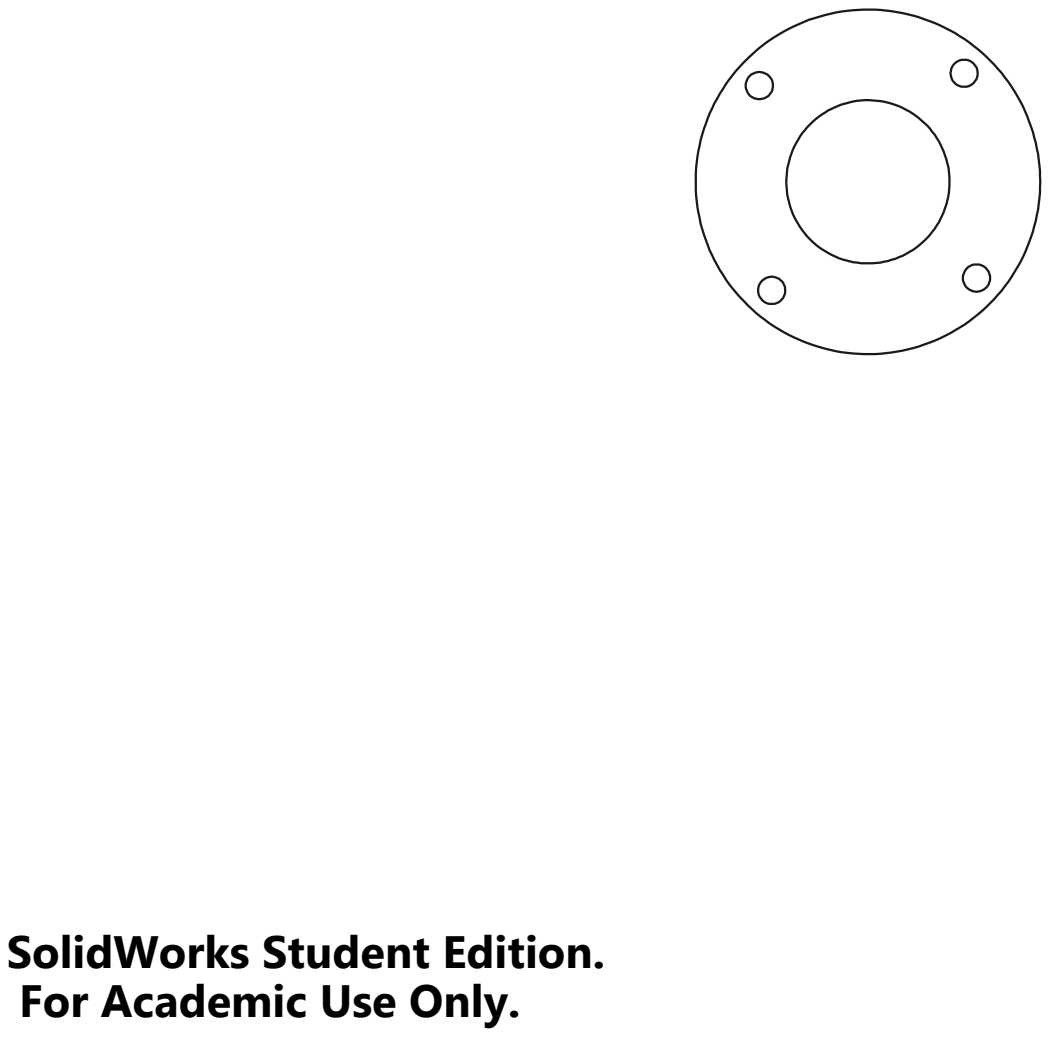
[picture p117: page 1]

SolidWorks Student Edition.
For Academic Use Only.
