MathiasKoch/roberto_mechanical/Solidworks/Drawings/pdf/LCD_bottom.pdf

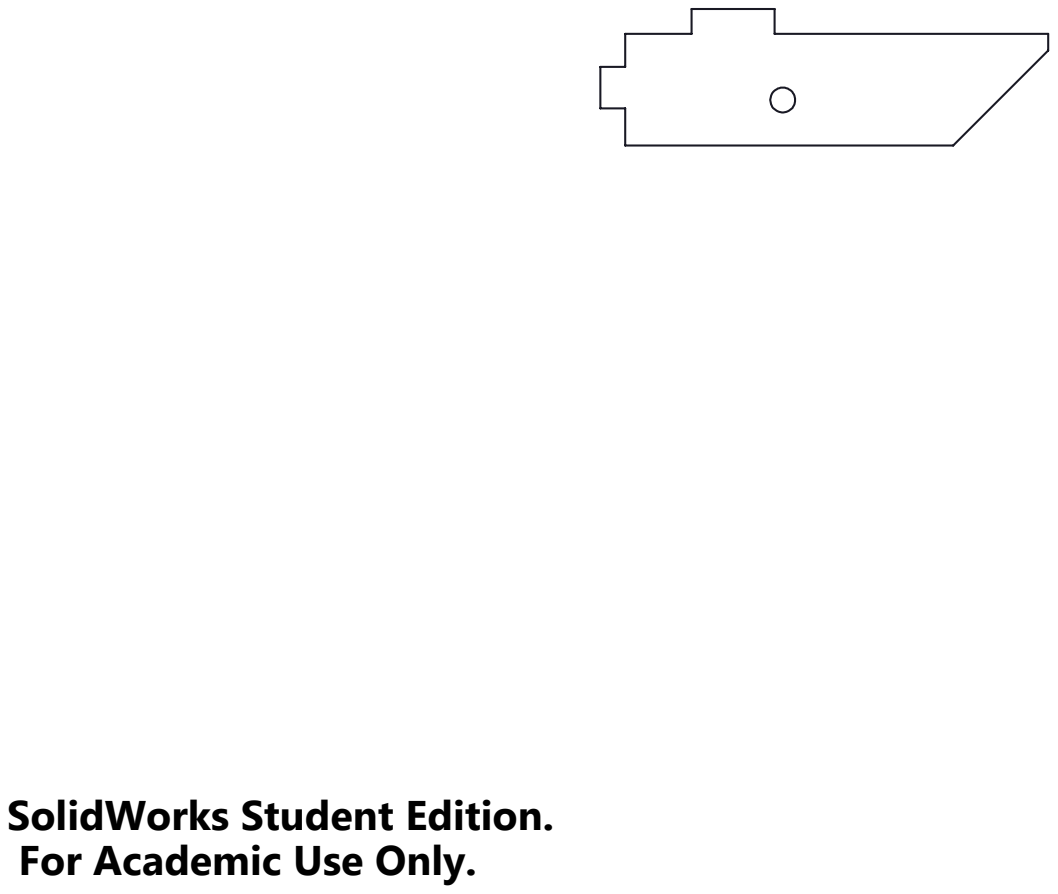
[picture p118: page 1]

SolidWorks Student Edition.
For Academic Use Only.
