MathiasKoch/roberto_mechanical/Solidworks/Drawings/pdf/LCD_bottom_power.pdf

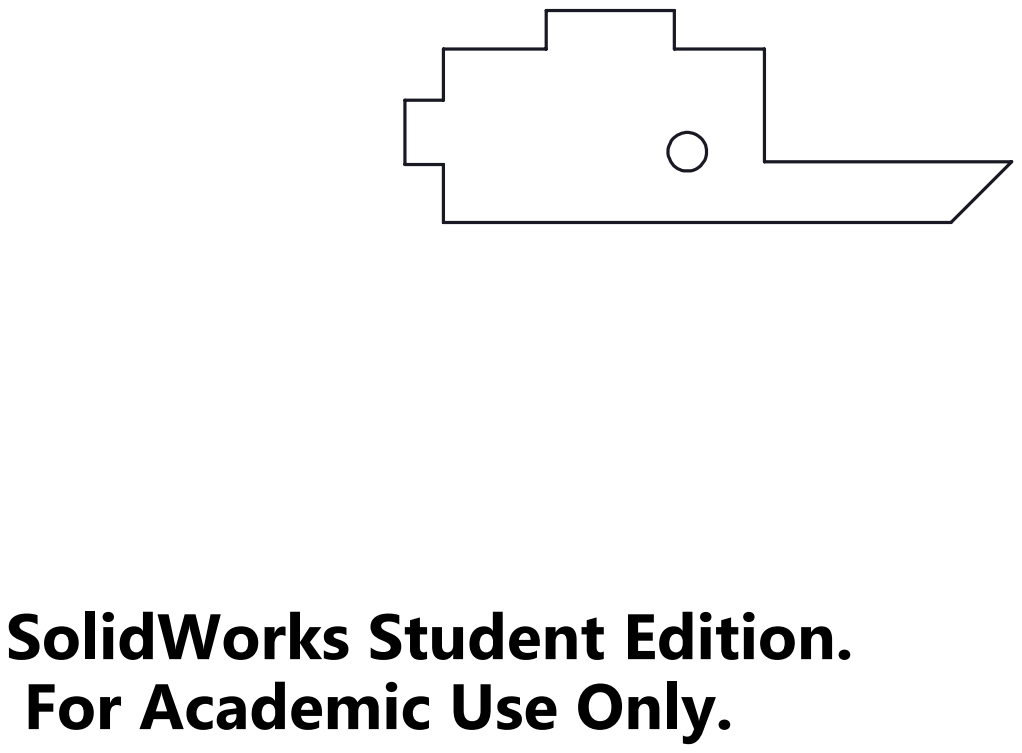
[picture p119: page 1]

SolidWorks Student Edition.
For Academic Use Only.
