MathiasKoch/roberto_mechanical/Solidworks/Drawings/pdf/LCD_front.PDF

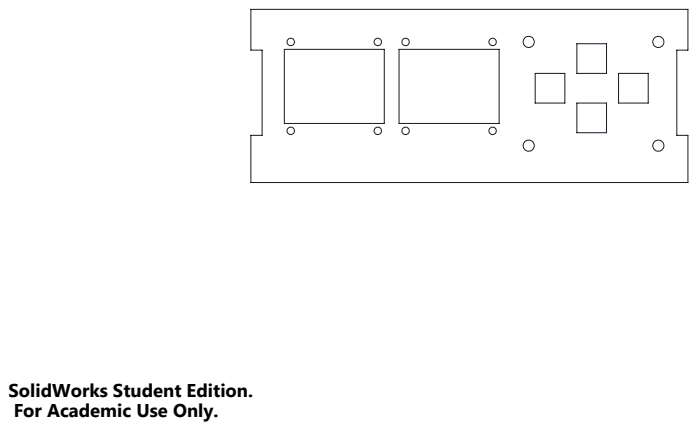
[picture p120: page 1]

SolidWorks Student Edition.
For Academic Use Only.
