MathiasKoch/roberto_mechanical/Solidworks/Drawings/pdf/LCD_low_front.pdf

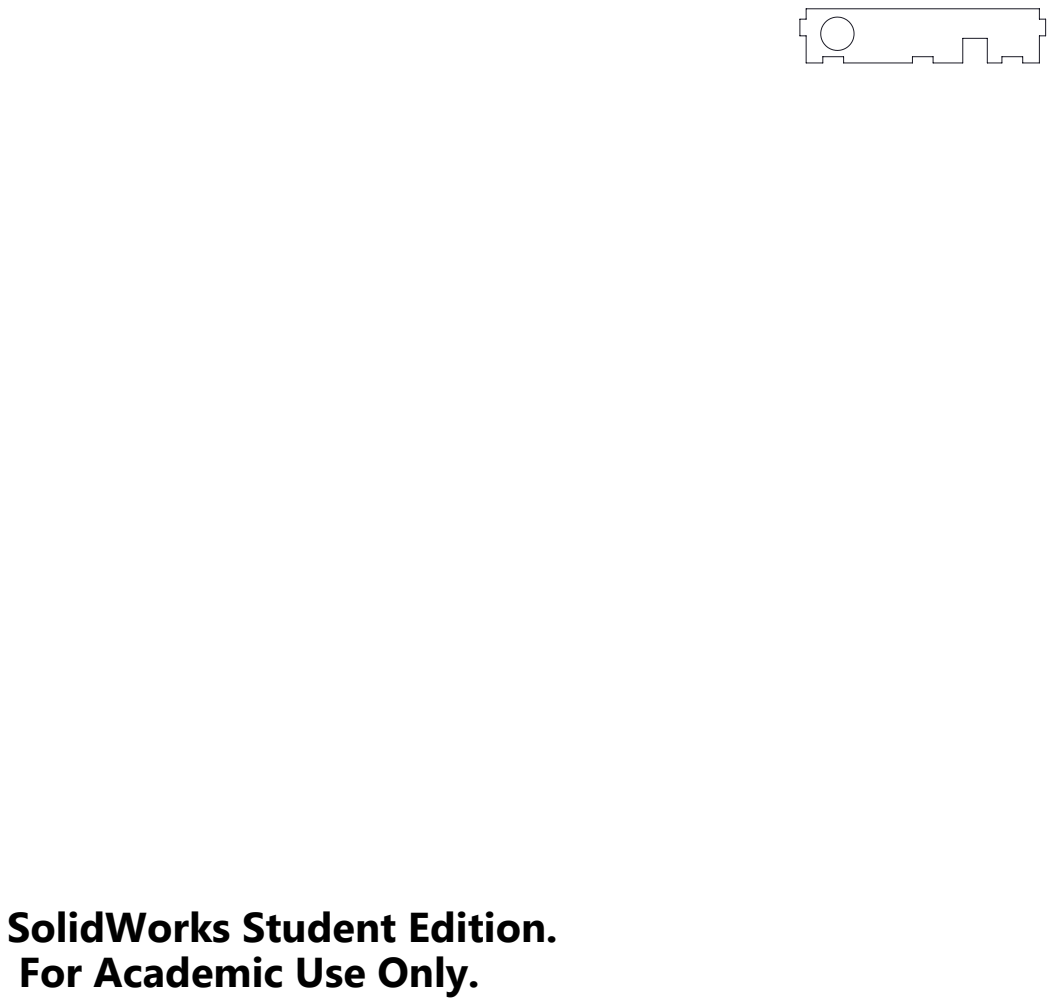
[picture p121: page 1]

SolidWorks Student Edition.
For Academic Use Only.
