MathiasKoch/roberto_mechanical/Solidworks/Drawings/pdf/LCD_side.pdf

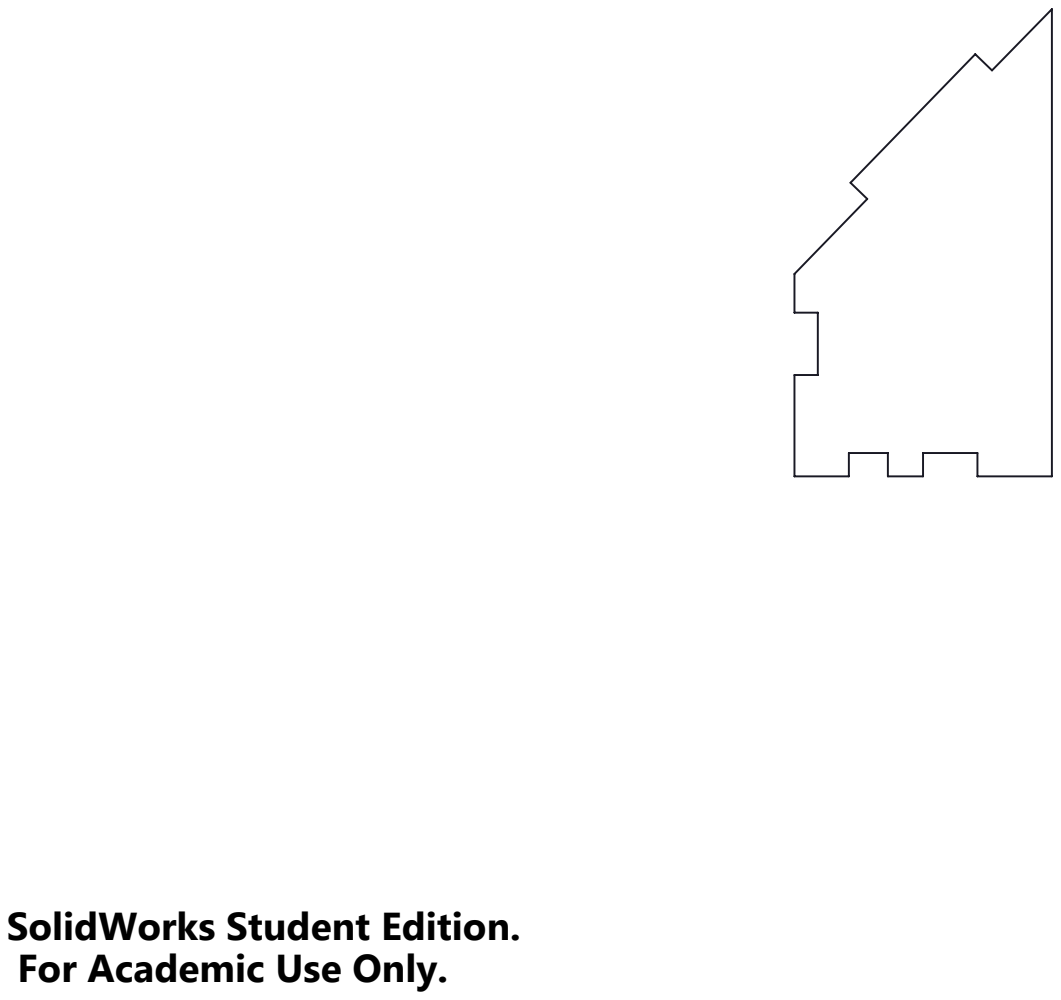
[picture p122: page 1]

SolidWorks Student Edition.
For Academic Use Only.
