MathiasKoch/roberto_mechanical/(list of files, drawings)

Other design files:
DipTrace/Buttons_v2.dch
DipTrace/Buttons_v2.dip
DipTrace/Charger_v5.dch
DipTrace/Charger_v5.dip
DipTrace/Distribution.dip
DipTrace/Distribution_v3-1.dch
DipTrace/Distribution_v3-1.dip
DipTrace/Distribution_v3.dch
DipTrace/Lader_BQ40Z60_V2.dch
DipTrace/Lader_V2.dip
DipTrace/Motor_v5.dch
DipTrace/Motor_v5.dip
DipTrace/Old/buttons2.dip
DipTrace/Old/Buttons.dch
DipTrace/Old/buttons.dip
DipTrace/Old/charger.dip
DipTrace/Old/Charger_v4.dch
DipTrace/Old/Charger_v4.dip
DipTrace/Old/Distribution_v1.dip
DipTrace/Old/Distribution_v2.dch
DipTrace/Old/Distribution_v2.dip
DipTrace/Old/Distribution_v3.dch
DipTrace/Old/Distribution_v3.dip
DipTrace/Old/encoder.dip
DipTrace/Old/Encoder_v1.dch
DipTrace/Old/Encoder_v1.dip
DipTrace/Old/i2c.dip
DipTrace/Old/Lader.dip
DipTrace/Old/Lader_BQ40Z60.dch
DipTrace/Old/Lader_BQ40Z60_V2.dch
DipTrace/Old/Lader_BQ40Z60_V3.dch
DipTrace/Old/Lader_v3.dip
DipTrace/Old/Motor2.dch
DipTrace/Old/motor2.dip
DipTrace/Old/Motor3.dch
DipTrace/Old/motor3.dip
DipTrace/Old/motor.dip
DipTrace/Old/Motor_v4.dch
DipTrace/Old/Motor_v4.dip
