MathiasKoch/roberto_mechanical/(commit log)

2016-10-30 Initial commit of all mechanical files, in the process of moving from dropbox to github
    [12c_extender.brd, 12c_extender.sch, Bearing1.SLDASM, Board_1.sldprt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]
2016-11-07 Fixed gears for mechanical model
    [12c_extender.brd, 12c_extender.sch, Bearing1.SLDASM, Board_1.sldprt, JST,BxB-XH-A4_PIN_1.sldprt, JST,BxB-XH-A4_PIN_1_1.sldprt, JST,BxB-XH-A4_PIN_1_2.sldprt, LCD.SLDPRT]
2016-11-09 Added first two detailed PCBs to model
    [1x3 female header 2_54mm pitch.SLDPRT, 1x3 female header 2_54mm pitch_charger.SLDPRT, 2x2 female header 2_54mm pitch.SLDPRT, 2x2 female header 2_54mm pitch_motor.SLDPRT, 2x3 female header 2_54mm pitch.SLDPRT, 2x3 female header 2_54mm pitch_charger.SLDPRT, 2x4 female header 2_54mm pitch.SLDPRT, 2x4 female header 2_54mm pitch_charger.SLDPRT]
2016-11-10 Added all the detailed PCBs to the model, and added the CircuitWorks component library for recreation purposes
    [0402c_2320560.sldprt, 0402r_1430758.sldprt, 0404_r_1620019.sldprt, 0805.SLDPRT, 0_125W Metal Film Resistor.SLDPRT, 0_25W Carbon Film Resistor.SLDPRT, 0_25W Metal Film Resistor.SLDPRT, 0_33W Carbon Film Resistor.SLDPRT]
2016-11-17 Changed center gear cylinder and added 20mm standoffs between Odroid and camera mount
    [ODROID.SLDPRT, bearing.SLDASM, camera_mount.SLDASM, encoder_mount.SLDPRT, pcb_distribution.SLDASM, pcb_encoder.SLDASM, plate_stick_short.SLDPRT, servo_horn.SLDPRT]
2016-11-17 Added display assembly
    [8 way jst shr-08v-s-b.SLDPRT, Capacitor 0603_motor.SLDPRT, JST_XH_4.SLDPRT, ODROID.SLDPRT, Resistor 0603_motor.SLDPRT, User Library-096OLED.SLDPRT, User Library-Finished golf ball.SLDPRT, XT60 MALE.SLDPRT]
2017-02-08 Added version 4 charger schematics, and other parts
    [Assem2.SLDASM, Assem6.SLDASM, Assem7.SLDASM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]
2017-02-12 Just ordered charger_v4 and distribution_v2
    [Buttons_v2.dch, Buttons_v2.dip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]
2017-08-20 Commit at time of ordering PCBs, Motor_v5, Charger_v5 and Distribution_v3
    [20-VQFN (3_5x4_5).step, B4B-PH-SM4(LF)(SN)_motor.STEP, B8B-PH-SM4.STEP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]
2021-03-21 Add distribution v3
    [BOM_Charger_v5.xlsx, Distribution_v3-1.dch, Distribution_v3-1.dip, Distribution_v3.dch, Distribution_v3.dip, Distribution_v3_INV.csv, Motor_v5_INV.csv, PnP_Chager_v5.csv]
